SaadOjo/OJO/Sources/CAD/Drawings of purchased items/Wheels.PNG

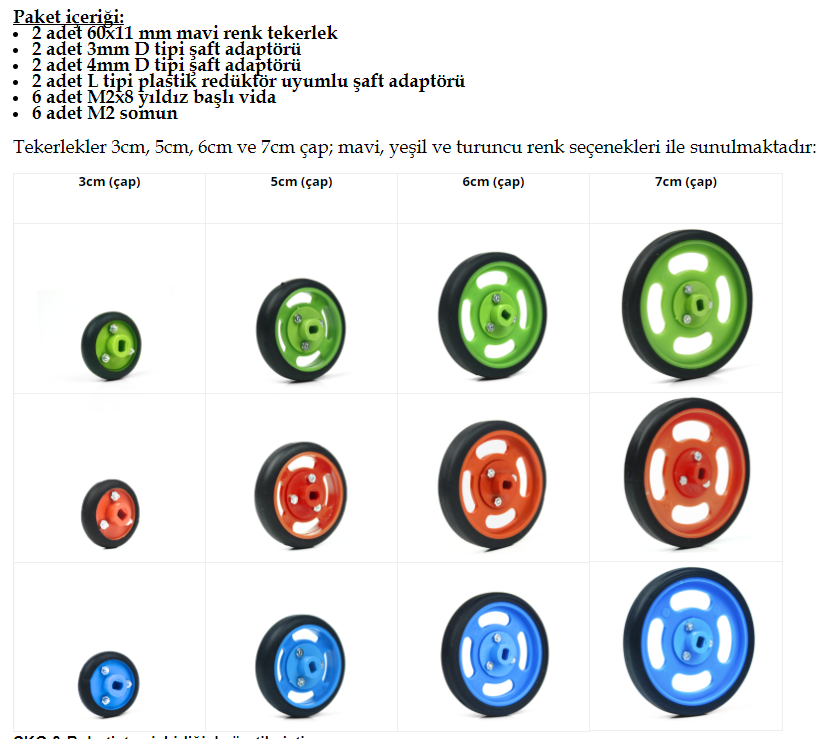
Sources/CAD/Drawings of purchased items/Wheels.PNG
