SaadOjo/OJO/OJO YouTube Cover.png

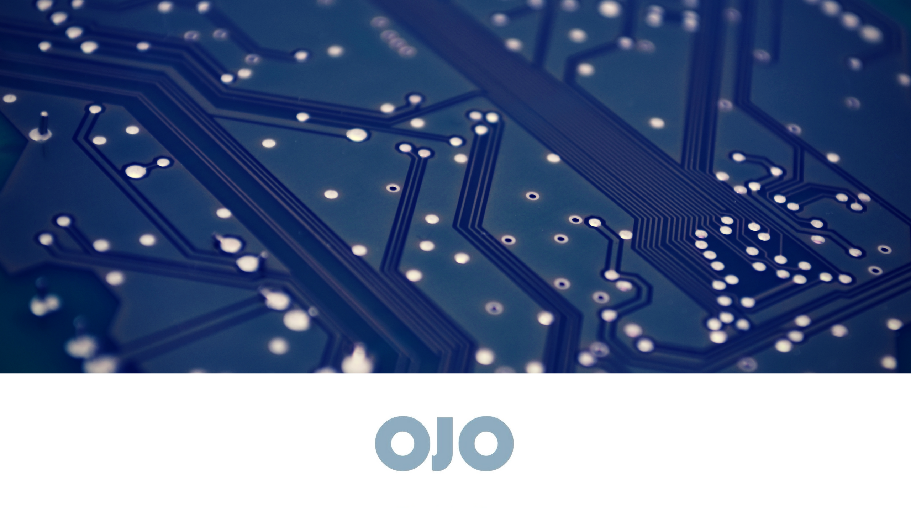
OJO YouTube Cover.png
