SaadOjo/OJO/README.md

# OJO
Colaboration platform for OJO company
