SaadOjo/OJO/Videos/Links.txt

1) Robot moving back* 
https://www.youtube.com/watch?v=8MlsbzrMXWE

2) Following the front robot, leaving the line command, finding the last one and detecting the laser
https://www.youtube.com/watch?v=pU-CdzhZj8A

3) Demo
https://youtu.be/8eGR3QvXF0o

*Relative to the convoy.
