SaadOjo/OJO/Sources/Microcontroller CodesSensorCombination/amount_of_pins_required.txt

US: 2 * 3 = 6 digital
IR DIR: 2 analog
IR DIS: 1 analog
IR Remote: 1 digital
Laser: 2 analog ??
Solar panel: 2 digital
POWER LED: 1
