SaadOjo/OJO/Sources/CAD/Links for wheels.txt

http://www.robotus.net/SLT20-Silikon-Tekerlek-2-Adet-,PR-576.html

http://www.robitshop.com/scooterkaykay-tekerlekler-icin-6mm-saft-adaptoru

https://www.robotistan.com/12v-25mm-100rpm-dc-motor

https://www.robotistan.com/aluminyum-l-tipi-25d-motor-tutucu-ikili

https://www.robotistan.com/solarbotics-rw2-tekerlek

http://www.robotus.net/SLT20-Silikon-Tekerlek-2-Adet-,PR-576.html
