SaadOjo/OJO/Sources/Microcontroller CodesSensorCombination/pinmapping.txt

Analog Pins:

A1: IR distance sensor
A2: IR direction 1 (LEFT)
A3: IR direction 2 (RIGHT)

Digital Pins:

2: IR Remote
5:Motor 1 (LEFT)
6:Motor 2 (RIGHT)
