SaadOjo/OJO/Documents/Weekly Reports/First semester/Week 8.docx

Weekly Report (WEEK 8)

Company Name: OJO e-mail: ojoee@googlegroups.com

Members:

Abdullah Aslam: phone: +90 (538) 050 37 64 e-mail: ama.abdullah90@gmail.com

Anar Abdullayev: phone: +90 (553) 924 96 43 e-mail: abdullayev.1995@gmail.com

Bulut Ulukapı: phone: +90 (555) 367 26 16 e-mail: ulukapi.bulut@metu.edu.tr

Syed Saad Saif: phone: +90 (546) 781 99 50 e-mail: saad.saif@metu.edu.tr

Umut Can Serçe: phone: +90 (506) 997 99 88 e-mail: serce.umut@metu.edu.tr

In this week, we decided to write our codes in a modular way. We divided some tasks related with coding, and then we assigned these to our group members. We made researches individually and started coding. In Table 1, it can be seen what these parts are and whom they are assigned to.

Motor driver: Abdullah Aslam

Ultrasonic sensor: Anar Abdullayev

LED antenna sensor: Bulut Ulukapı

Feedback control: Syed Saad Saif

Flags: Umut Can Serçe

Table 1. The list of modules and their assignments

In addition to the equipment and components that are purchased in last weeks, we purchased a chassis for tests and trial.

There was also a standards committee meeting. Before the meeting, we communicated with the other group and made an informal meeting. After these informal and formal meetings, some decisions are made. The agreements which are made on these meetings can be seen on the Table 2.

- If a leave command is given while turning, the optimal direction for leaving must be decided.
- Minimum radius of the curvature for turning is 100 cm.
- Maximum speed of the mock up robot is 12 cm/s. (previously it was 20cm/s)
- Distance between the center of the rectangle (visibility marker) on the robot and ground needs to in between 12 cm and 16 cm.
- Infrared LED’s needs to be horizontal.

Table 2. The decisions made in the standard committee meeting 3
