SaadOjo/OJO/Documents/Objective Tree.docx

Environment compatible Control

Light-weighted

Easily manoeuvrable

Performance

Rejoin in 10 sec
(For a good response time )

Minimum number of components to robust

Leaving and rejoining the convoy

Power Efficient

Marketable

Cost Effective

User Friendly
