SaadOjo/OJO/Documents/CDRR/CDRR Ideas and Plans.odt

-Overall System Description (with top-down approach)

-System and subsystem level

-Block diagrams

-Flow charts

-3D drawings

-All control and sata signals with their feedback paths

-Technical Specifications

-Design Modifications (changes since the CDR)

-Design changes

-4 wheel, 4 motor drive system

-Solar panel inside the box

-Chassis changed

-Updated Standards

-IR visibility marker/flags

-width of the green rectangle

-7 segment inside the box

-Compability Analysis of Sub-blocks

-Inter lib communication

-RPI --- Arduino standarts ---- UART

(Signal interfaces must be described clearly)

-Compliance with Requirements

-Design Requirements

-follow robot infront

-normal distance: 20 cm

-normal speed: 12 cm/s

-leave the line on externally received command

-within 15 sec

-maintain lateral distance of 10 cm from convoy

-rejoin the convoy as the last robot

-Physical Dimensions

-fit inside 30 cm diameter cylinder placed vertically

-Design Decisions According to the Requirements(give details)

-all the sensors and diff drive

-distance sensor IR

-IP to get distance and direction

-38 kHz IR receiver

-(cant read?) motors

-solar panel to detect laser

-made custom chassis

-Possible Error Sources

-HSV to minimize color change

-environmental light

-uneven surface

-4 wheels

-noise in sensors

-low pass filters

-combining data from multiple sensors

-Test Procedures and Assesment of Test Results(with encountered problems and proposed solutions)

TP:

-Image Processing

Objective: 1. Determine Distance,Direction,Orientation

2.Determine leaving command

1) Color Detection

-different colors

-check the range of green that can be detected

-different lighting conditions

1) Rectangle Detection

-edge detected

-tried different shapes

2) Corner Detection (coordinates)

3a) Accuracy of Dist,Dir,Orient

3b)Field of view

-Distance Sensors

-IR

-Ultrasonic

-Solar Panel

-Robot Speed

-Turning

-Leaving (Response Time)

-Following

-Power Delivery

-Resource Management (may need some addition)

-Updated budget

-Power distribution and management

- Updated Gannt
