SaadOjo/OJO/Documents/Flow chart (rough).docx

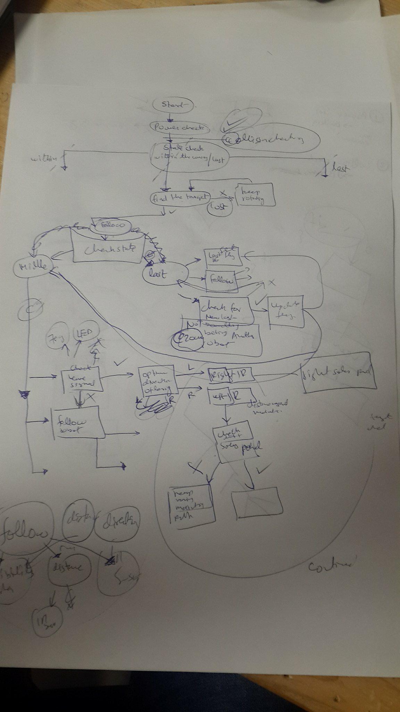
[picture p71: figure]
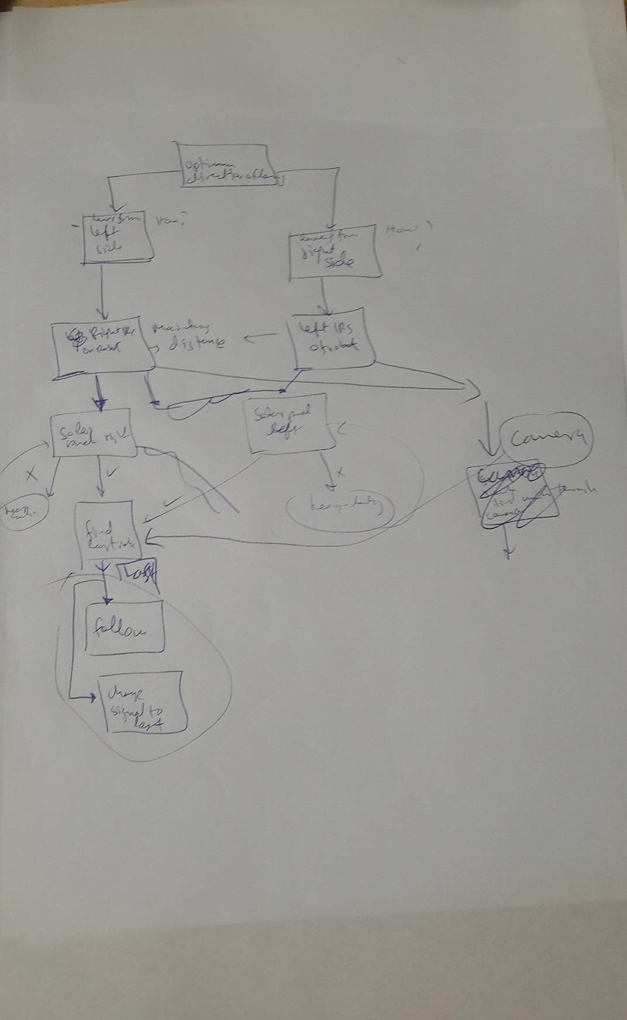
[picture p72: figure]
