SaadOjo/OJO/Datasheets/panel.jpg

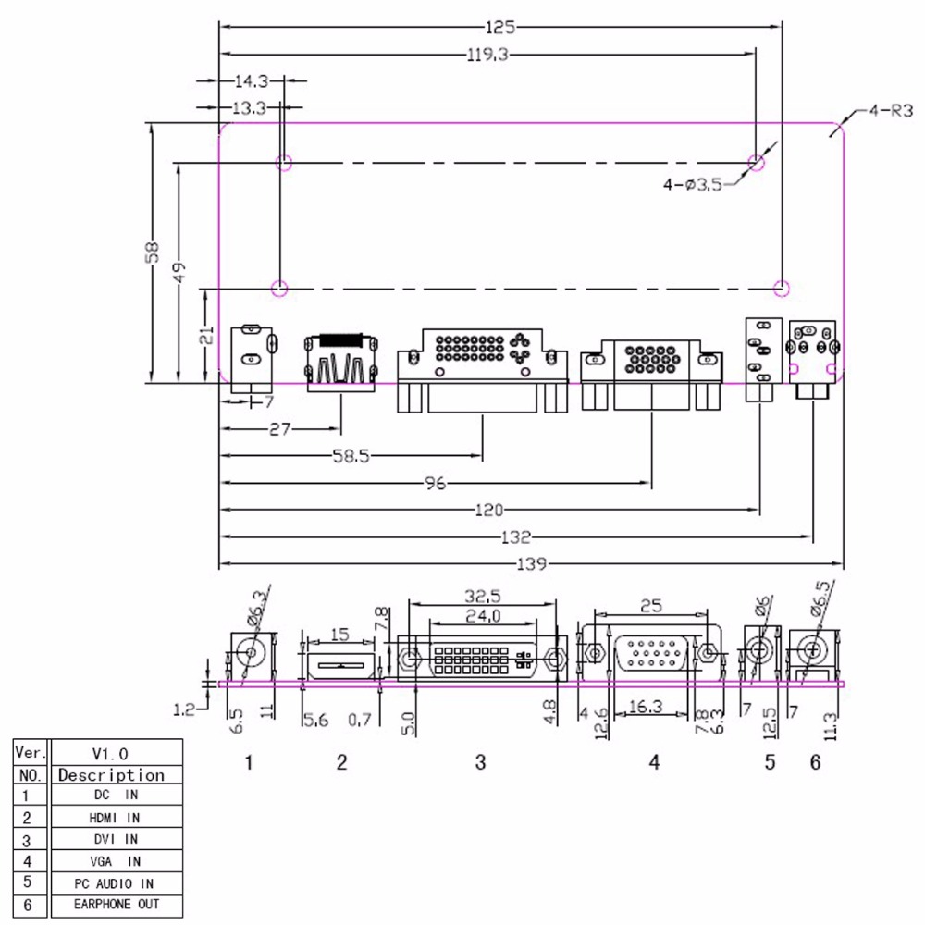
Datasheets/panel.jpg
