SaadOjo/OJO/Documents/CDRR/overall system diagram.jpg

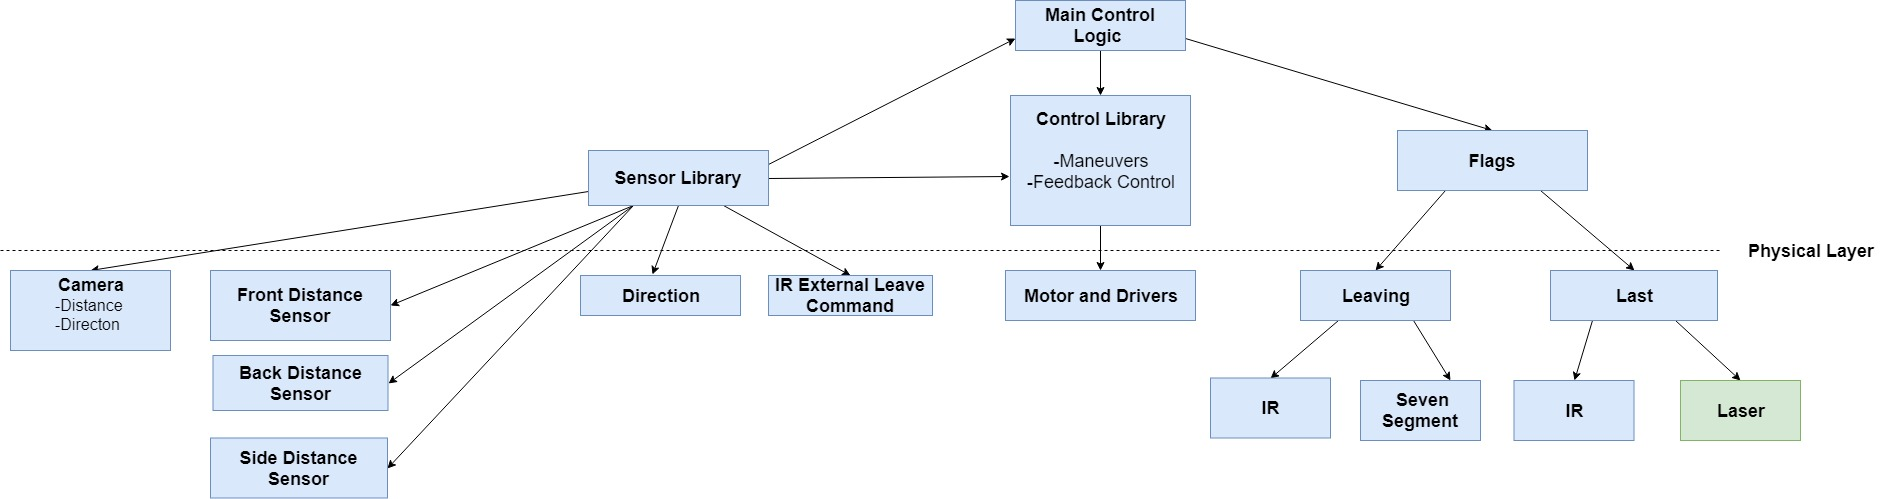
Documents/CDRR/overall system diagram.jpg
