SaadOjo/OJO/Documents/CDRR/Whole robot.png

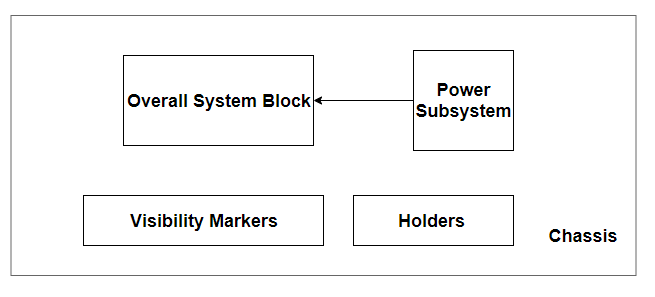
Documents/CDRR/Whole robot.png
