SaadOjo/OJO/Other/Sketchup 3D/for scale.png

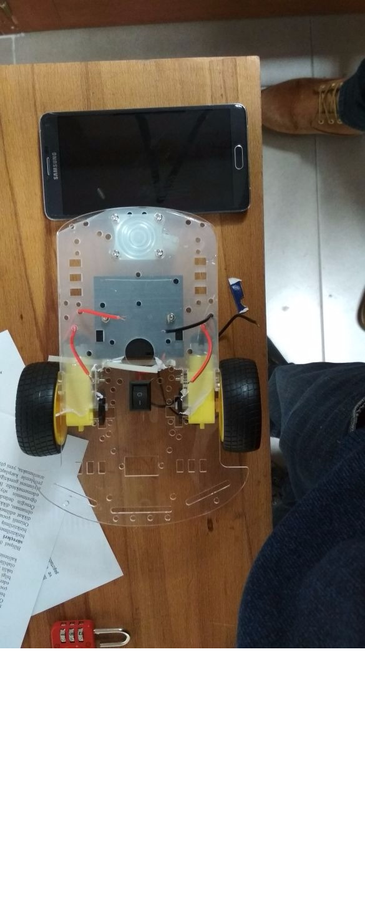
Other/Sketchup 3D/for scale.png
