SaadOjo/OJO/Other/Sketchup 3D/ruler.png

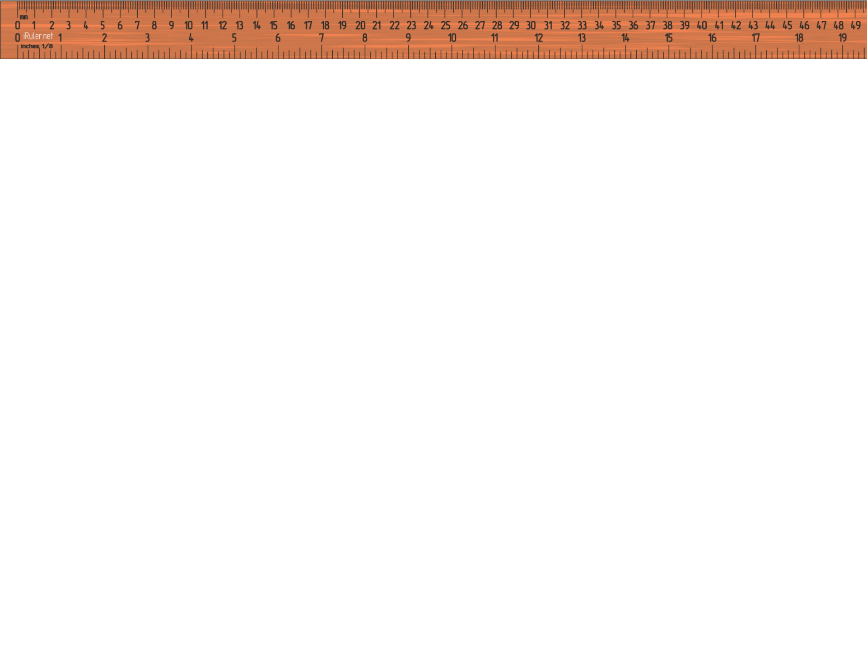
Other/Sketchup 3D/ruler.png
