SaadOjo/OJO/Sources/CAD/Solidworks Files/00 Non Project Related/Batman/ComicCon_Decals-61_1024x1024.png

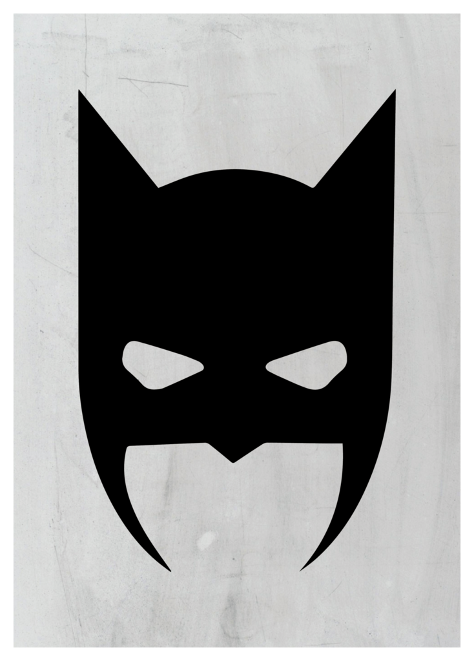
Sources/CAD/Solidworks Files/00 Non Project Related/Batman/ComicCon_Decals-61_1024x1024.png
