SaadOjo/OJO/Sources/CAD/Drawings of purchased items/25 mm motor holder.jpg

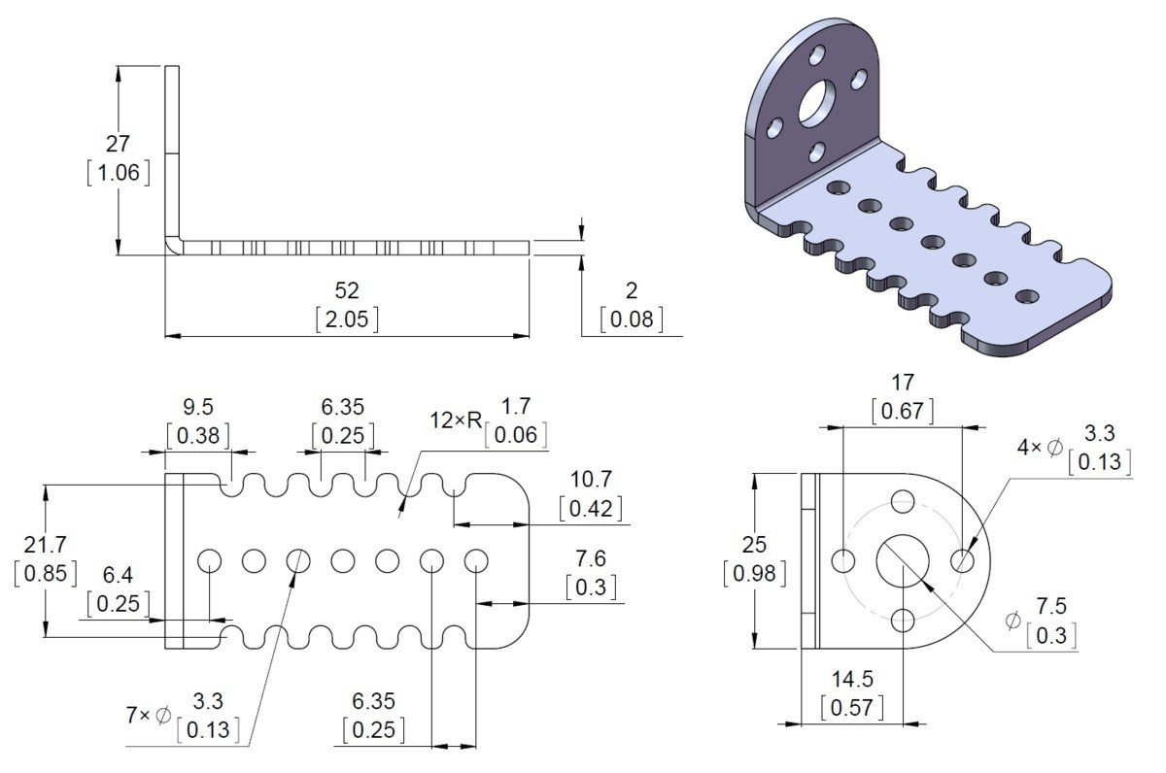
Sources/CAD/Drawings of purchased items/25 mm motor holder.jpg
