SaadOjo/OJO/Sources/CAD/Drawings of purchased items/drawings of microcontrollers and camera/arduino nano.png

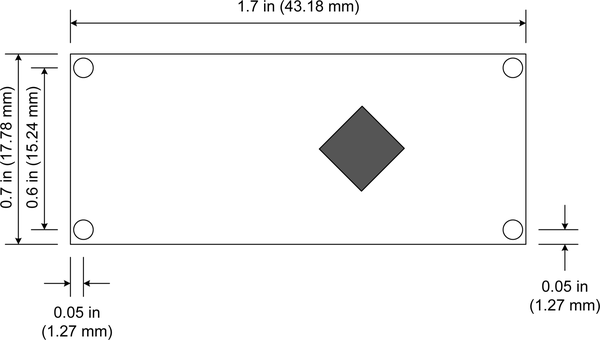
Sources/CAD/Drawings of purchased items/drawings of microcontrollers and camera/arduino nano.png
