SaadOjo/OJO/Sources/CAD/Drawings of purchased items/Hub.PNG

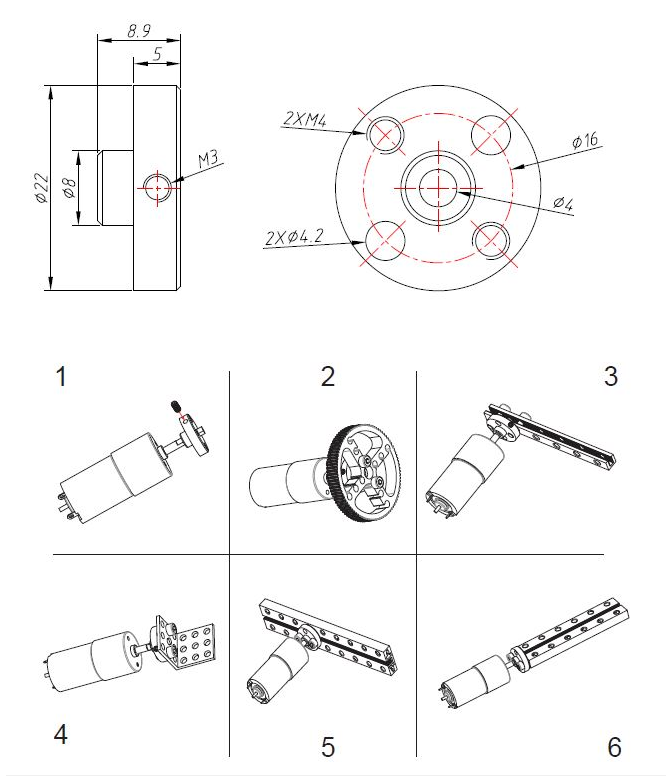
Sources/CAD/Drawings of purchased items/Hub.PNG
