SaadOjo/OJO/Sources/CAD/Solidworks Files/00 Non Project Related/coinSeperator/Assem1.SLDASM

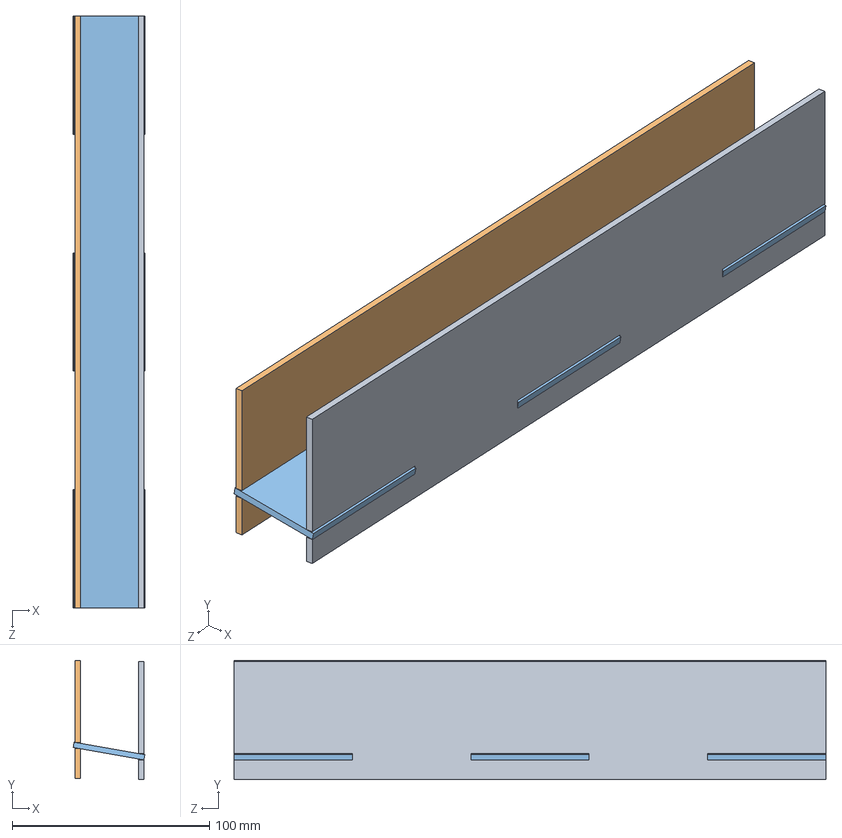
[picture p86: CAD file, 2018-03-12]
Sources/CAD/Solidworks Files/00 Non Project Related/coinSeperator/Assem1.SLDASM
36.3 x 60.5 x 300.0 mm
side_wall_1
side_wall_2
coin_plate
