SaadOjo/OJO/Sources/CAD/Solidworks Files/00 Non Project Related/Monitor/Assem.SLDASM

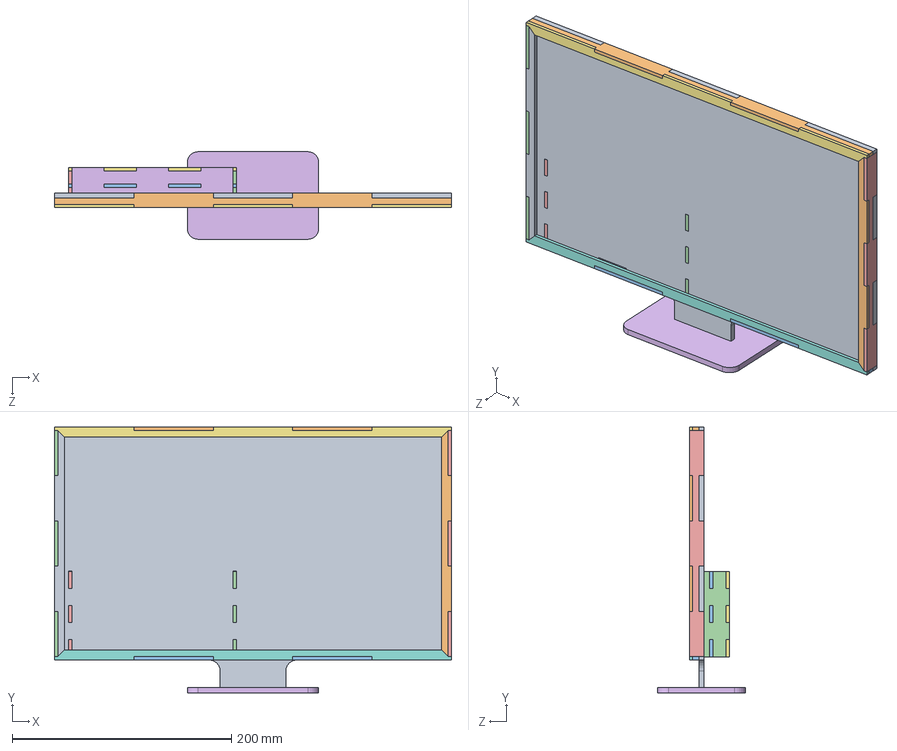
[picture p87: CAD file, 2018-03-06]
Sources/CAD/Solidworks Files/00 Non Project Related/Monitor/Assem.SLDASM
362.3 x 242.5 x 80.0 mm
A_1
B_1
C_1
D_1
F_1
BASE
G_1
H_1
I_1
J_1
BOX_A_1
BOX_B_1
BOX_C_1
BOX_D_1
BOX_E_1
