SaadOjo/OJO/Sources/CAD/Solidworks Files/00 Non Project Related/Monitor_2/Assem2.SLDASM

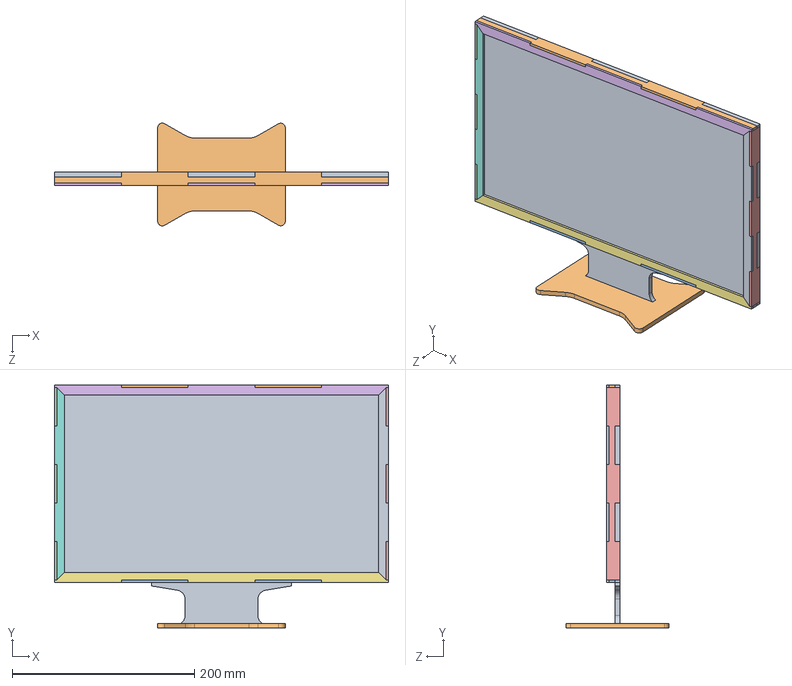
[picture p88: CAD file, 2018-05-15]
Sources/CAD/Solidworks Files/00 Non Project Related/Monitor_2/Assem2.SLDASM
366.4 x 266.4 x 112.8 mm
A_1
C_1_topdeepbezel
D_1_bottomdeepbezel
E_1_sidedeepbezel
F_1_sidedeepbezel
G_1_topbezel
H_1_topbezel
I_1_sidebezel
J_1_sidebezel
B_4_base
