SaadOjo/OJO/Sources/CAD/Solidworks Files/00 Non Project Related/Monitor_2/ButtonCase/holder_assem.SLDASM

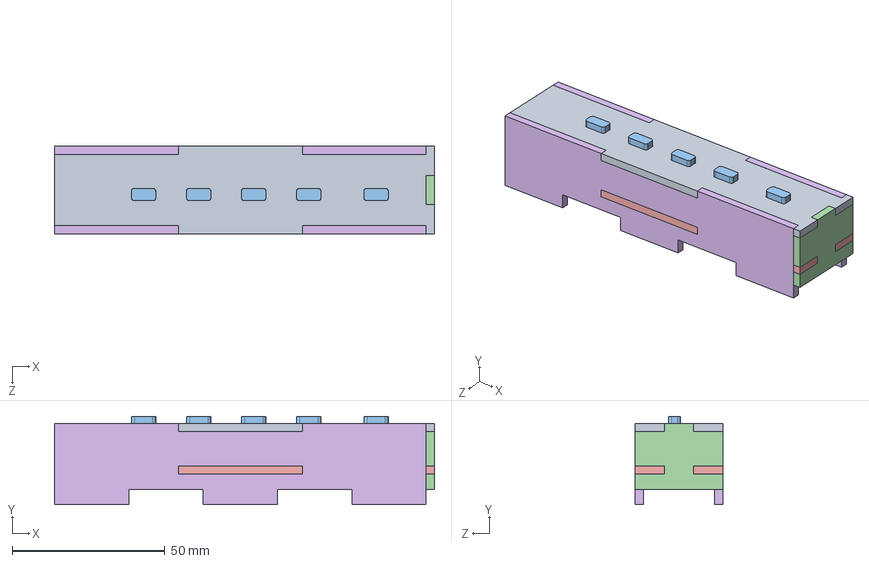
[picture p89: CAD file, 2018-05-15]
Sources/CAD/Solidworks Files/00 Non Project Related/Monitor_2/ButtonCase/holder_assem.SLDASM
124.2 x 28.9 x 28.6 mm
top_plate
bb1 x 5
bt1 x 5
side_plate
base_plate
other_side_2 x 2
