SaadOjo/OJO/Sources/CAD/Solidworks Files/00 Non Project Related/Monitor_3/Assem2_other.SLDASM

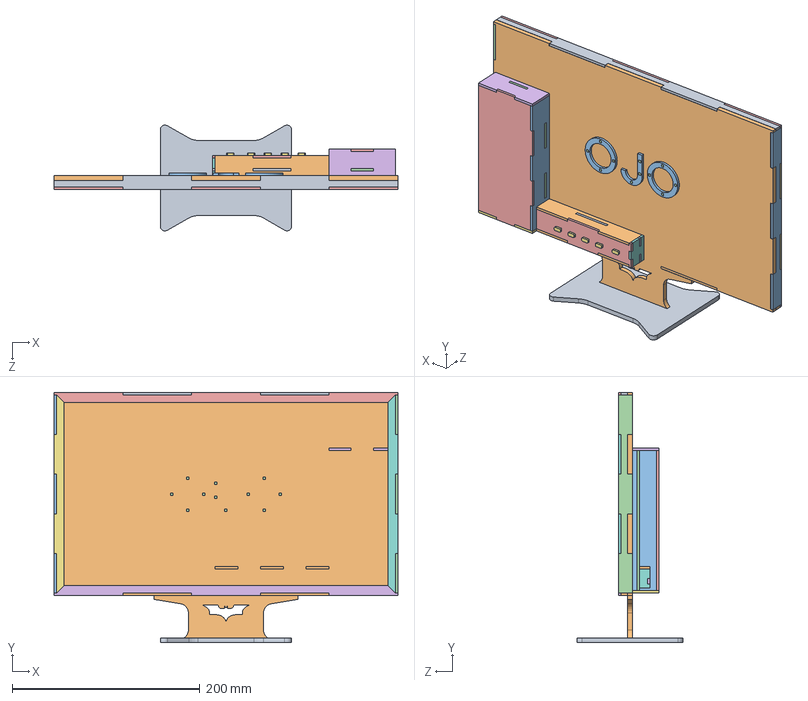
[picture p90: CAD file, 2018-05-15]
Sources/CAD/Solidworks Files/00 Non Project Related/Monitor_3/Assem2_other.SLDASM
366.5 x 266.5 x 112.8 mm
C_1_topdeepbezel
D_1_bottomdeepbezel
E_1_sidedeepbezel
F_1_sidedeepbezel
G_1_topbezel
H_1_topbezel
I_1_sidebezel
J_1_sidebezel
B_4_base
A_1_other
OJO LOGO
stick x 11
top_plate
bb1 x 5
bt1 x 5
side_plate
base_plate
other_side_2 x 2
box_back_plate
box_base_plate
box_top_plate
left_side_plate
right_side_plate
