SaadOjo/OJO/Sources/CAD/Solidworks Files/10 to be cut/5 mm/Solidworks/mainboard_last.SLDPRT

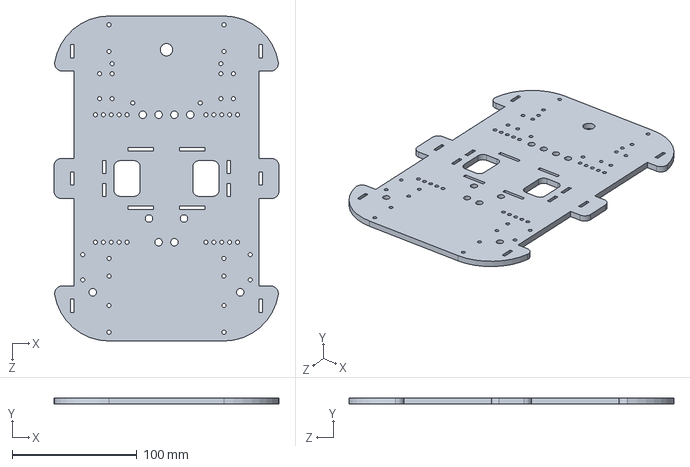
[picture p91: CAD file, 2018-05-15]
Sources/CAD/Solidworks Files/10 to be cut/5 mm/Solidworks/mainboard_last.SLDPRT
180.0 x 5.00 x 260.0 mm
