SaadOjo/OJO/Sources/CAD/Solidworks Files/Holder for solar panel/Assem for solar panel holder.SLDASM

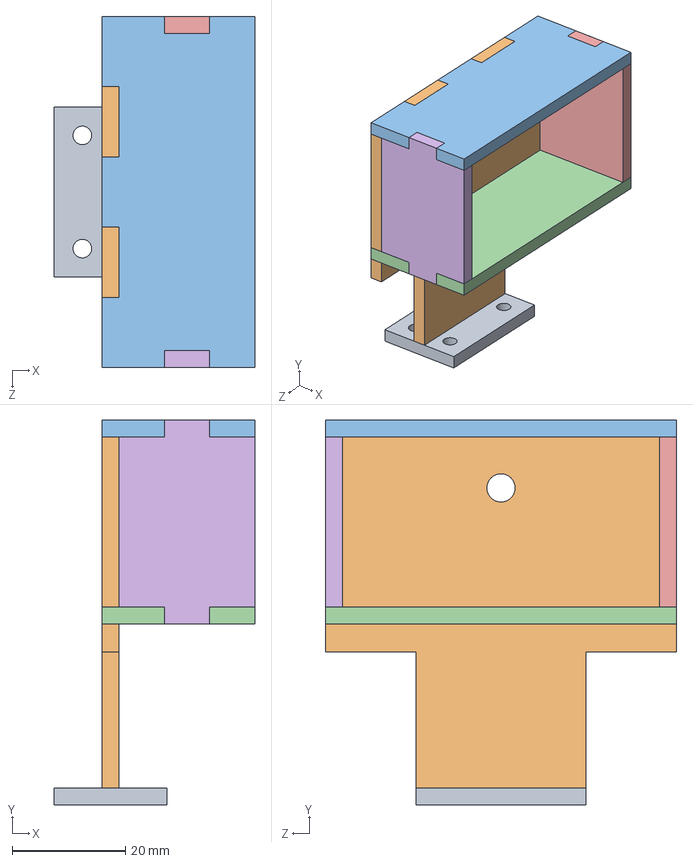
[picture p92: CAD file, 2018-03-03]
Sources/CAD/Solidworks Files/Holder for solar panel/Assem for solar panel holder.SLDASM
35.5 x 68.0 x 62.0 mm
part_A1
part_B1
Part_E1
Part_F1
Part_C1
Part_D1
