SaadOjo/OJO/Sources/CAD/Solidworks Files/Monitor_2/attachmentAssembly.SLDASM

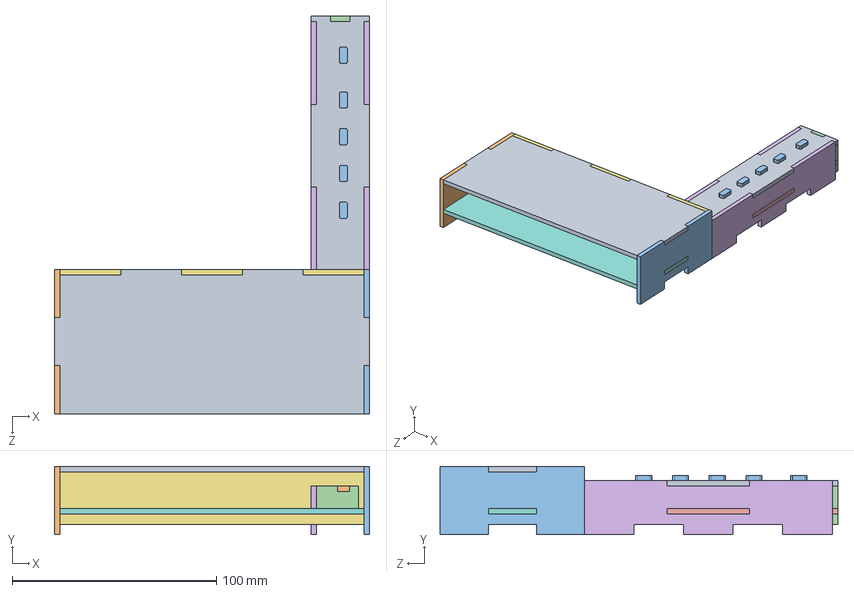
[picture p93: CAD file, 2018-05-15]
Sources/CAD/Solidworks Files/Monitor_2/attachmentAssembly.SLDASM
154.4 x 33.4 x 194.9 mm
top_plate
bb1 x 5
bt1 x 5
side_plate
base_plate
other_side_2 x 2
box_back_plate
box_base_plate
box_top_plate
left_side_plate
right_side_plate
