SaadOjo/OJO/Sources/CAD/Solidworks Files/Robot/Assem1_2_new.SLDASM

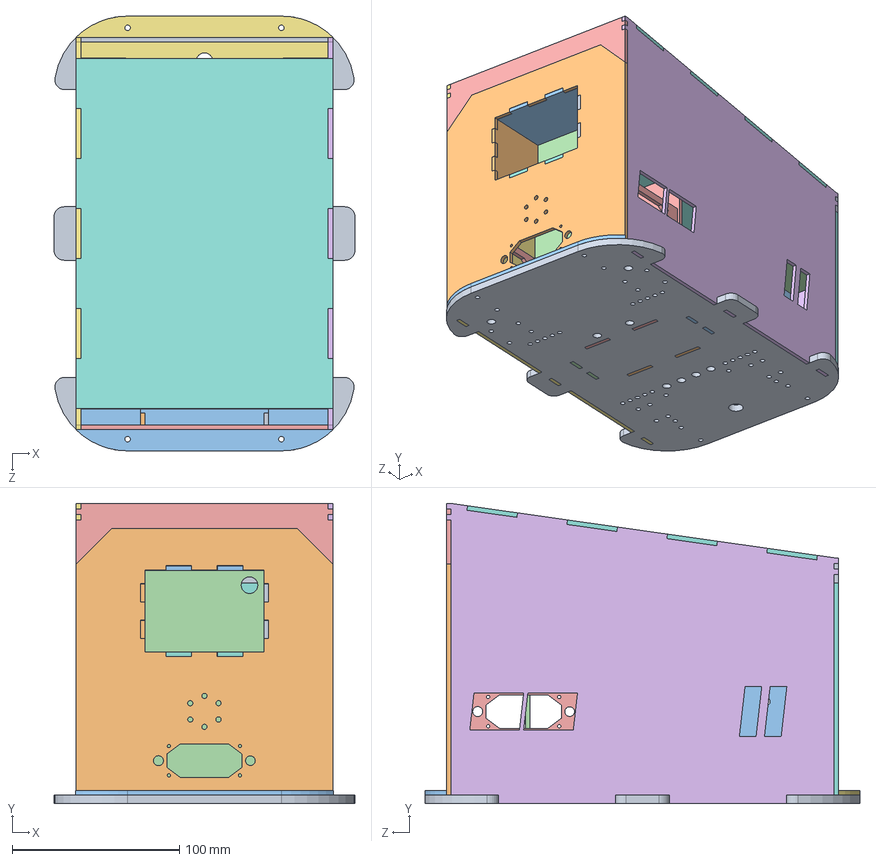
[picture p94: CAD file, 2018-05-15]
Sources/CAD/Solidworks Files/Robot/Assem1_2_new.SLDASM
180.0 x 179.5 x 260.0 mm
mainboard_last
part_A1 x 2
part_B1 x 2
Part_E1 x 2
Part_F1 x 2
Part_C1 x 2
Part_D1 x 2
partsev_bottom
partsev_side_1
partsev_side_2
partsev_top
partsev_back
back
Side_2
Side_1
top
front
new_back_holder_back_part_A
new_back_holder_base
new_back_holder_solar_panel_and_laser_part_B x 2
new_back_holder_solar_panel_and_laser_part_C x 2
Arduino_nano_holder
Base_main
Front_holder_A
Raspberry_holder
bat_long_wall_1
bat_short_wall_1
bat_short_wall_2
bat_long_wall_with_circuit_holder
