SaadOjo/OJO/Sources/CAD/Solidworks Files/seven segment box/partsev_assem.SLDASM

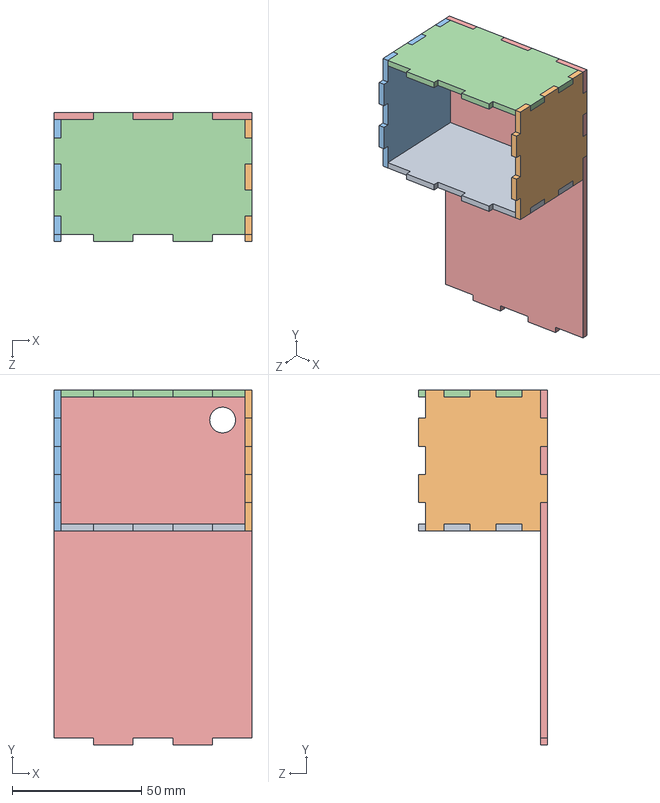
[picture p95: CAD file, 2018-05-15]
Sources/CAD/Solidworks Files/seven segment box/partsev_assem.SLDASM
76.4 x 137.2 x 50.0 mm
partsev_bottom
partsev_side_1
partsev_side_2
partsev_top
partsev_back
