SaadOjo/OJO/Sources/CAD/Solidworks Files/00 Non Project Related/Monitor_2/Assem.SLDASM

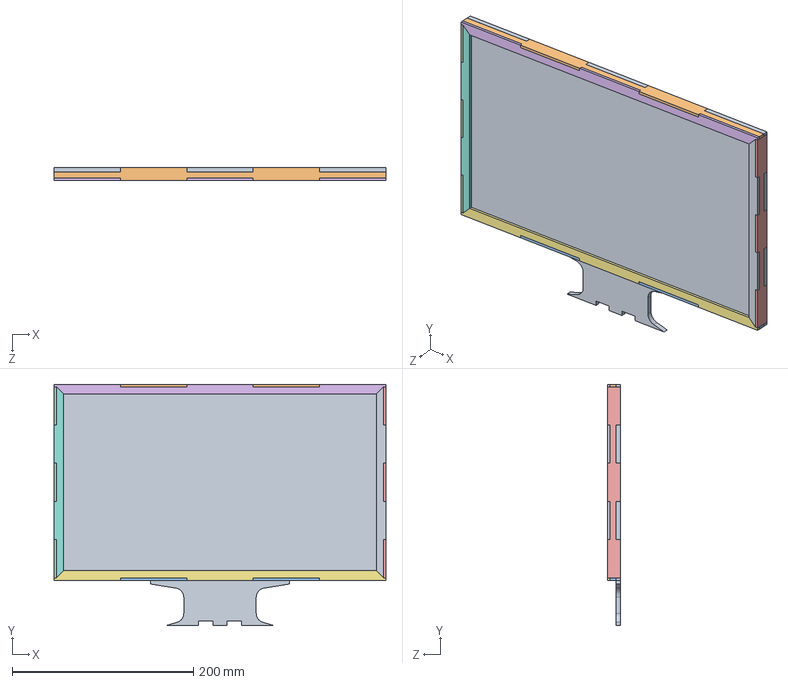
[picture p96: CAD file, 2018-03-12]
Sources/CAD/Solidworks Files/00 Non Project Related/Monitor_2/Assem.SLDASM
366.4 x 266.4 x 14.7 mm
A_1
C_1_topdeepbezel
D_1_bottomdeepbezel
E_1_sidedeepbezel
F_1_sidedeepbezel
G_1_topbezel
H_1_topbezel
I_1_sidebezel
J_1_sidebezel
