SaadOjo/OJO/Sources/CAD/Solidworks Files/00 Non Project Related/shelf/Assem1_prime.SLDASM

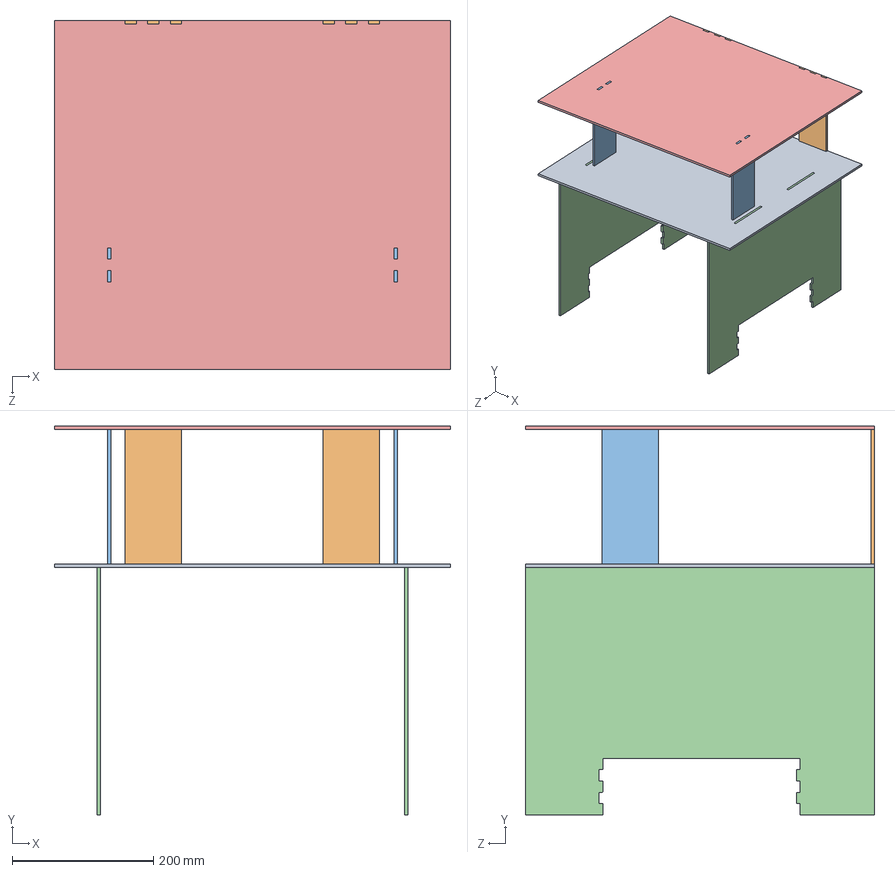
[picture p97: CAD file, 2018-03-12]
Sources/CAD/Solidworks Files/00 Non Project Related/shelf/Assem1_prime.SLDASM
560.0 x 550.0 x 494.0 mm
A_1
D_1_prime x 2
G_1_prime x 2
B_1_prime x 2
H_1
