SaadOjo/OJO/Sources/CAD/Solidworks Files/battery holder/Assem_bat_holder.SLDASM

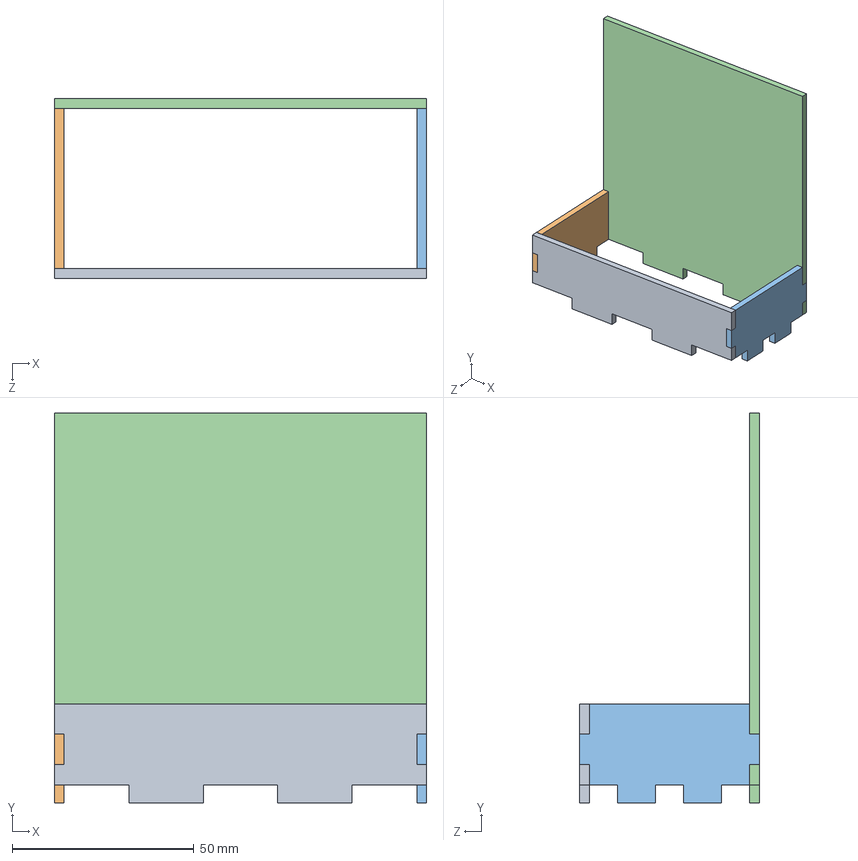
[picture p98: CAD file, 2018-05-15]
Sources/CAD/Solidworks Files/battery holder/Assem_bat_holder.SLDASM
102.4 x 107.3 x 49.4 mm
bat_long_wall_1
bat_short_wall_1
bat_short_wall_2
bat_long_wall_with_circuit_holder
