SaadOjo/OJO/Sources/CAD/Solidworks Files/Chassis/mainboard_04_new.SLDPRT

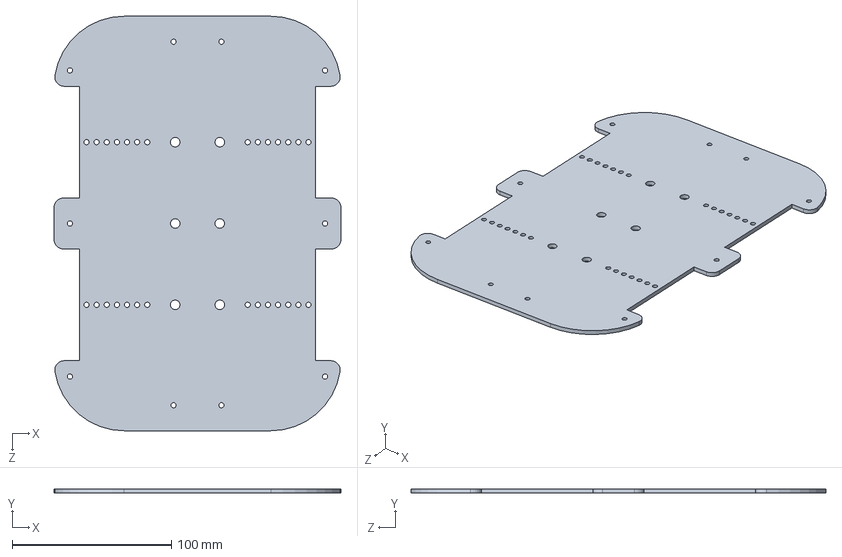
[picture p99: CAD file, 2018-02-26]
Sources/CAD/Solidworks Files/Chassis/mainboard_04_new.SLDPRT
180.0 x 2.80 x 260.0 mm
