SaadOjo/OJO/Sources/CAD/Solidworks Files/Front Holder/Assem_front.SLDASM

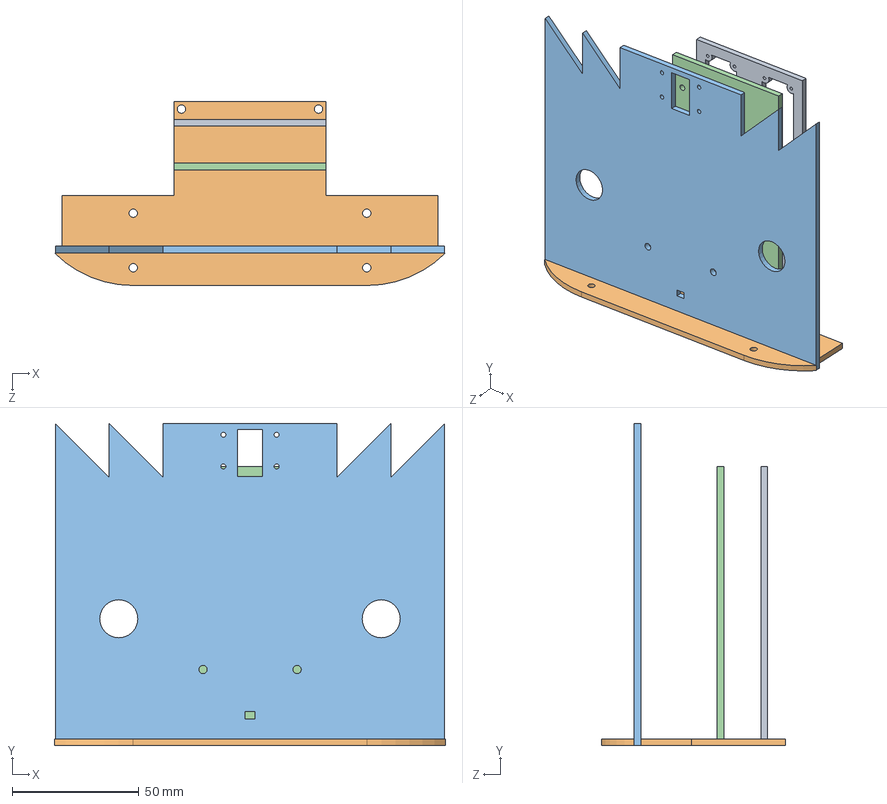
[picture p100: CAD file, 2018-05-15]
Sources/CAD/Solidworks Files/Front Holder/Assem_front.SLDASM
154.1 x 127.0 x 72.5 mm
Arduino_nano_holder
Base_main
Front_holder_A
Raspberry_holder
