SaadOjo/OJO/Sources/CAD/Solidworks Files/Monitor_2/ElectronicsBox/box_assem.SLDASM

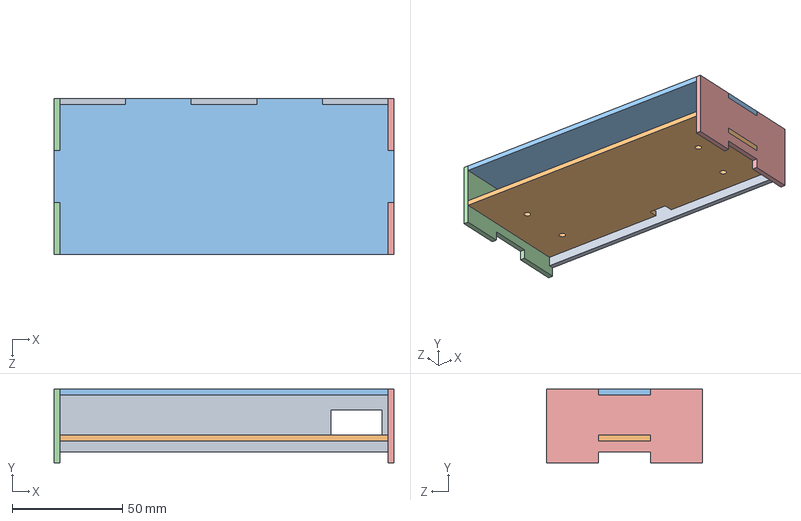
[picture p101: CAD file, 2018-05-15]
Sources/CAD/Solidworks Files/Monitor_2/ElectronicsBox/box_assem.SLDASM
154.4 x 33.4 x 70.7 mm
box_back_plate
box_base_plate
box_top_plate
left_side_plate
right_side_plate
