SaadOjo/OJO/Sources/CAD/Solidworks Files/new back holder/Assem_new_back.SLDASM

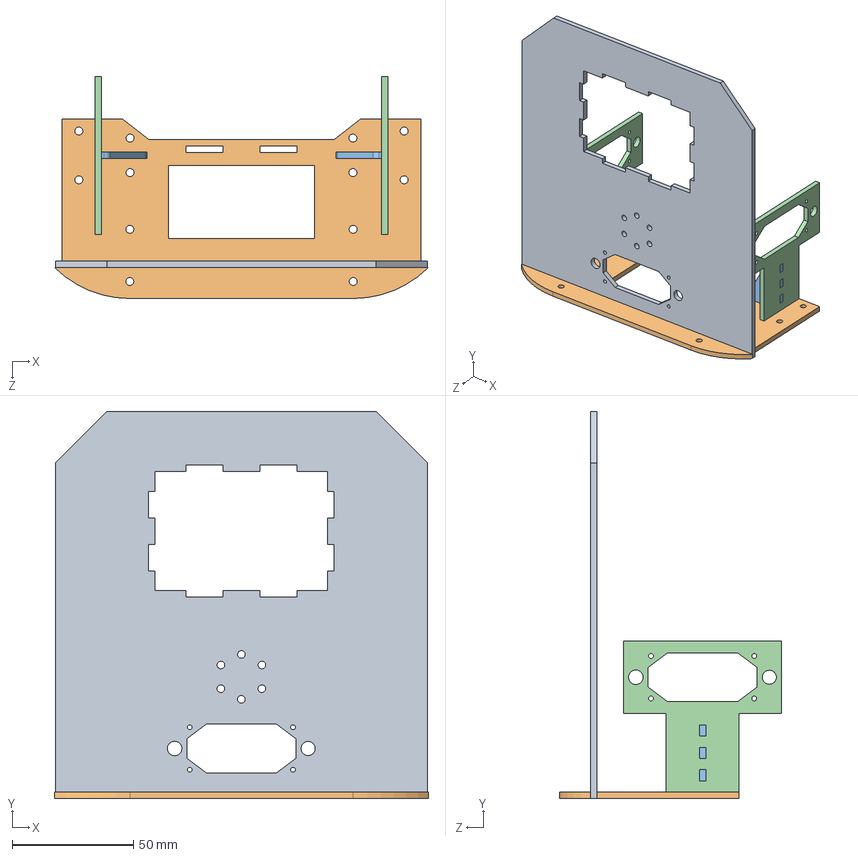
[picture p102: CAD file, 2018-05-15]
Sources/CAD/Solidworks Files/new back holder/Assem_new_back.SLDASM
154.1 x 159.5 x 91.4 mm
new_back_holder_back_part_A
new_back_holder_base
new_back_holder_solar_panel_and_laser_part_B x 2
new_back_holder_solar_panel_and_laser_part_C x 2
