SaadOjo/OJO/Sources/CAD/Solidworks Files/Robot/Assem1.SLDASM

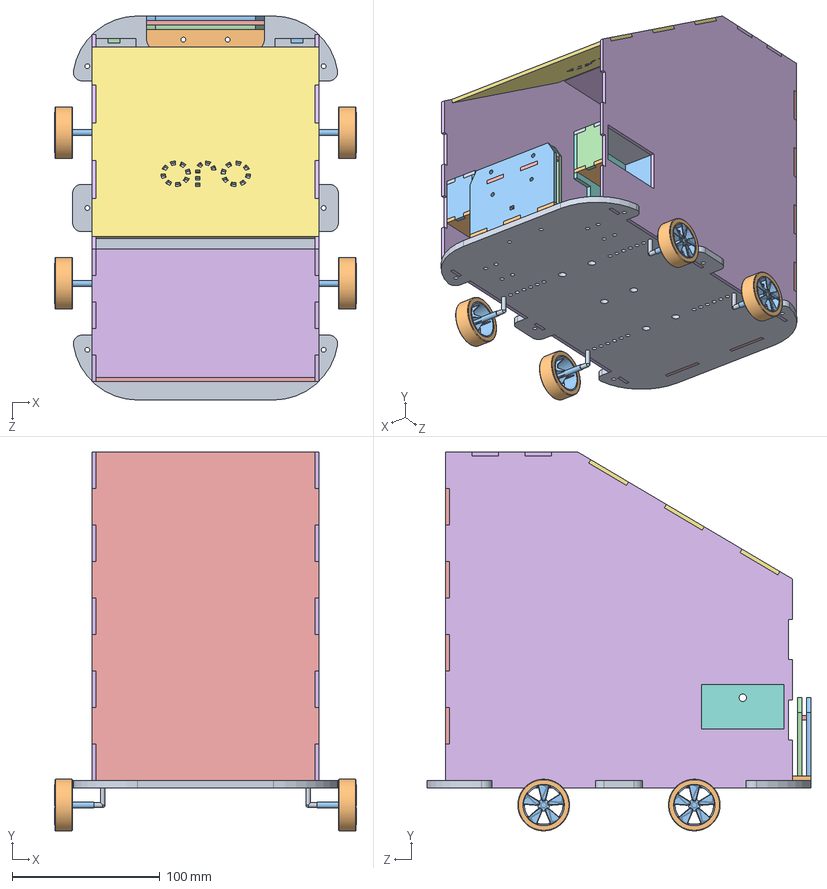
[picture p103: CAD file, 2018-03-08]
Sources/CAD/Solidworks Files/Robot/Assem1.SLDASM
204.6 x 256.4 x 260.0 mm
mainboard_last
holder_A_1
holder_B_2
holder_C_1
holder_D_1
Side_2 x 2
part_A1 x 2
part_B1 x 2
Part_E1 x 2
Part_F1 x 2
Part_C1 x 2
Part_D1 x 2
Back
Top_first
Top_second
tire x 4
disque roue x 4
