SaadOjo/OJO/Sources/CAD/Solidworks Files/Walls (Box)/walls_assem.SLDASM

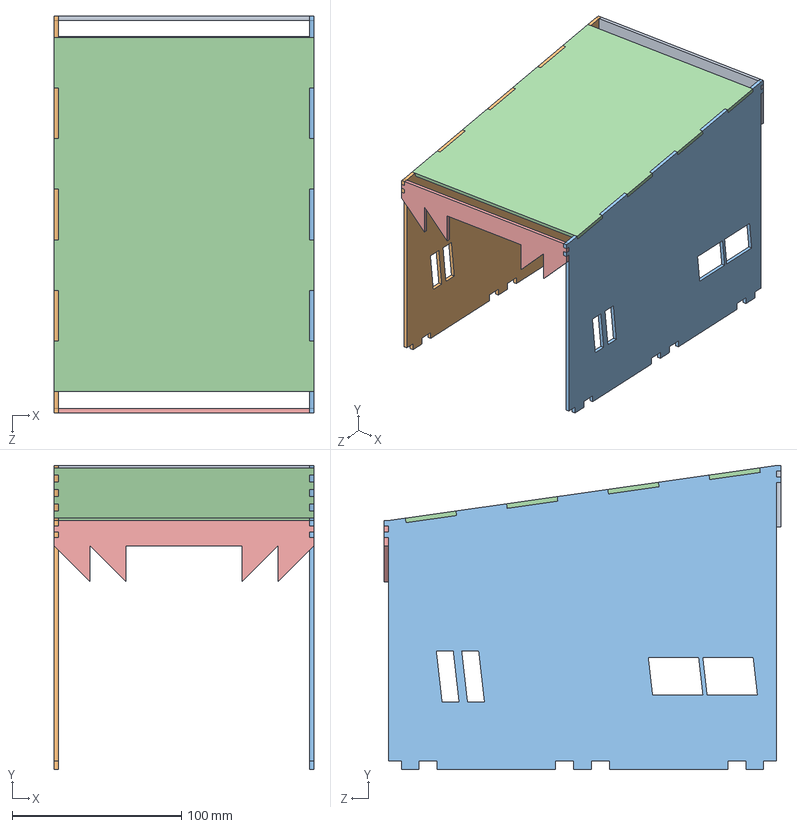
[picture p104: CAD file, 2018-05-15]
Sources/CAD/Solidworks Files/Walls (Box)/walls_assem.SLDASM
153.4 x 179.5 x 234.4 mm
back
Side_2
Side_1
top
front
