SaadOjo/OJO/Sources/CAD/Solidworks Files/00 Non Project Related/Monitor/Electronics Box/BoxAssembly.SLDASM

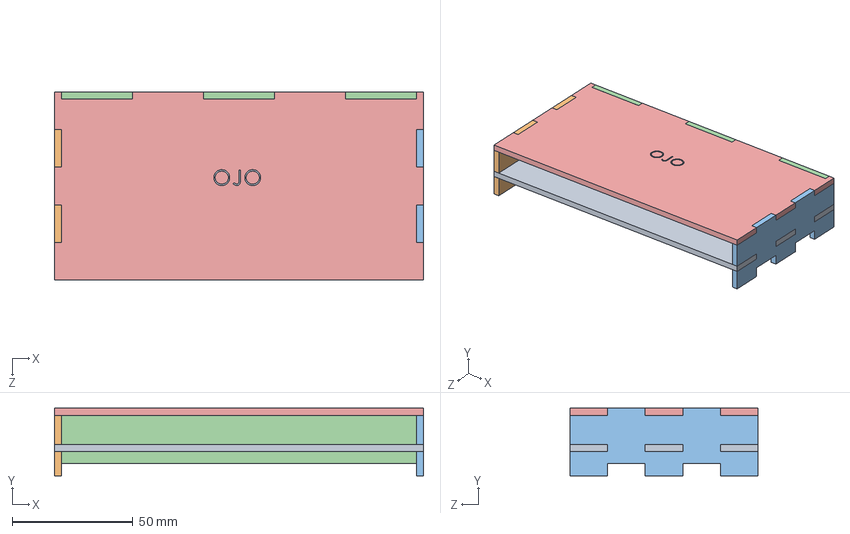
[picture p105: CAD file, 2018-03-06]
Sources/CAD/Solidworks Files/00 Non Project Related/Monitor/Electronics Box/BoxAssembly.SLDASM
153.0 x 28.0 x 78.0 mm
BOX_A_1
BOX_B_1
BOX_C_1
BOX_D_1
BOX_E_1
