SaadOjo/OJO/Sources/CAD/Solidworks Files/00 Non Project Related/Monitor_2/ElectronicsBox/assem.SLDASM

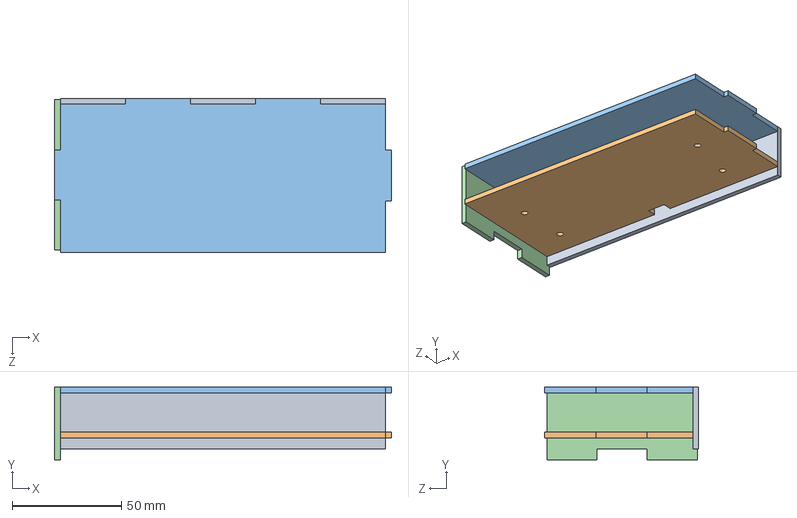
[picture p106: CAD file, 2018-03-17]
Sources/CAD/Solidworks Files/00 Non Project Related/Monitor_2/ElectronicsBox/assem.SLDASM
154.4 x 33.4 x 70.7 mm
box_back_plate
box_base_plate
box_top_plate
left_side_plate
