SaadOjo/OJO/Sources/CAD/Solidworks Files/Arduino Holder/Assem Arduino.SLDASM

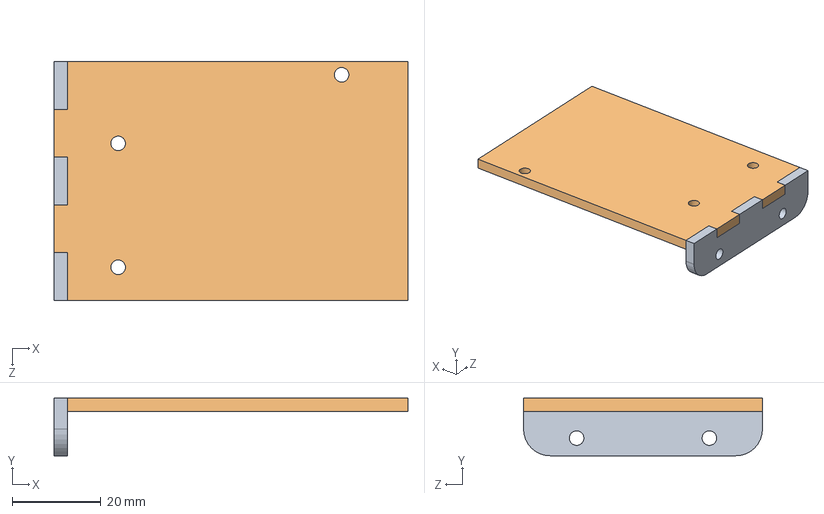
[picture p107: CAD file, 2018-03-03]
Sources/CAD/Solidworks Files/Arduino Holder/Assem Arduino.SLDASM
80.0 x 13.0 x 54.0 mm
Part_A_1
Part_B_1
