SaadOjo/OJO/Sources/CAD/Solidworks Files/Front Holder/Base_main.SLDPRT

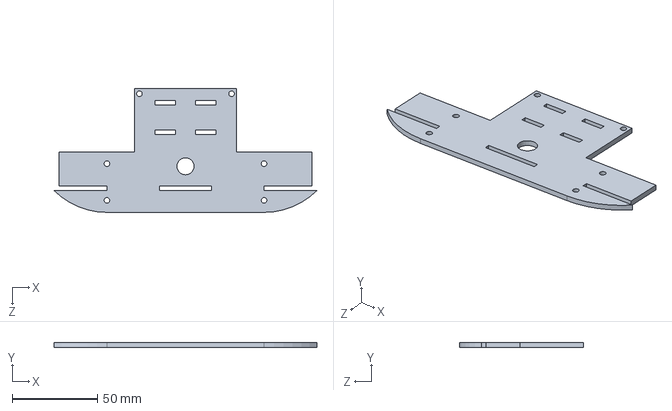
[picture p108: CAD file, 2018-05-15]
Sources/CAD/Solidworks Files/Front Holder/Base_main.SLDPRT
154.1 x 2.70 x 72.5 mm
