SaadOjo/OJO/Sources/CAD/Solidworks Files/This little thing/this little thing.SLDASM

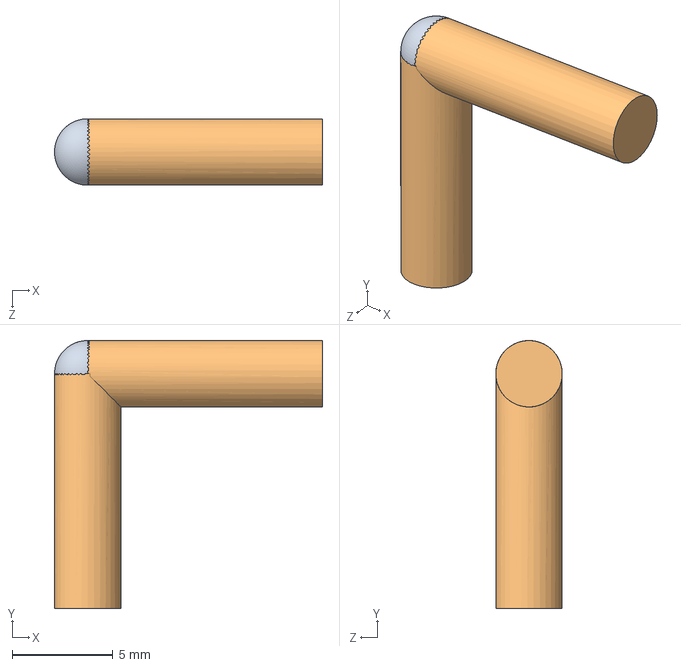
[picture p109: CAD file, 2018-03-08]
Sources/CAD/Solidworks Files/This little thing/this little thing.SLDASM
13.3 x 13.3 x 3.30 mm
