SaadOjo/OJO/Sources/CAD/Solidworks Files/00 Non Project Related/Monitor_3/ButtonCase/buttonAs1.SLDASM

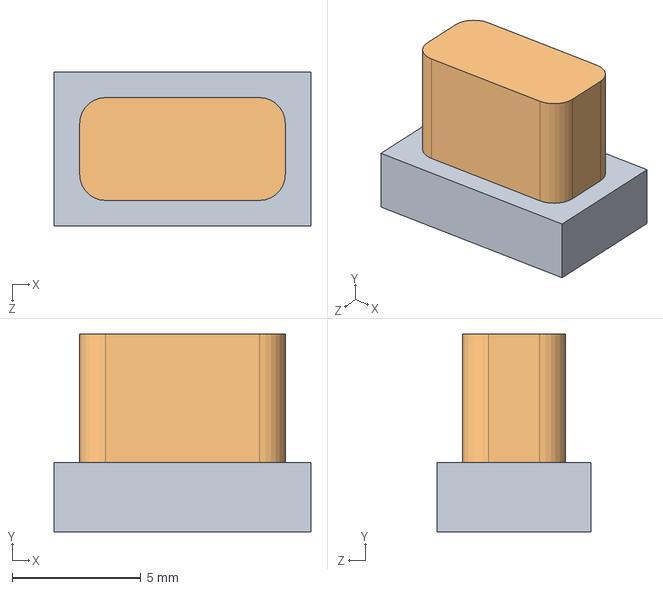
[picture p110: CAD file, 2018-03-12]
Sources/CAD/Solidworks Files/00 Non Project Related/Monitor_3/ButtonCase/buttonAs1.SLDASM
10.0 x 7.70 x 6.00 mm
button1_base
button1
