SaadOjo/OJO/Sources/CAD/Solidworks Files/00 Non Project Related/Monitor_3/ButtonCase/Assem3.SLDASM

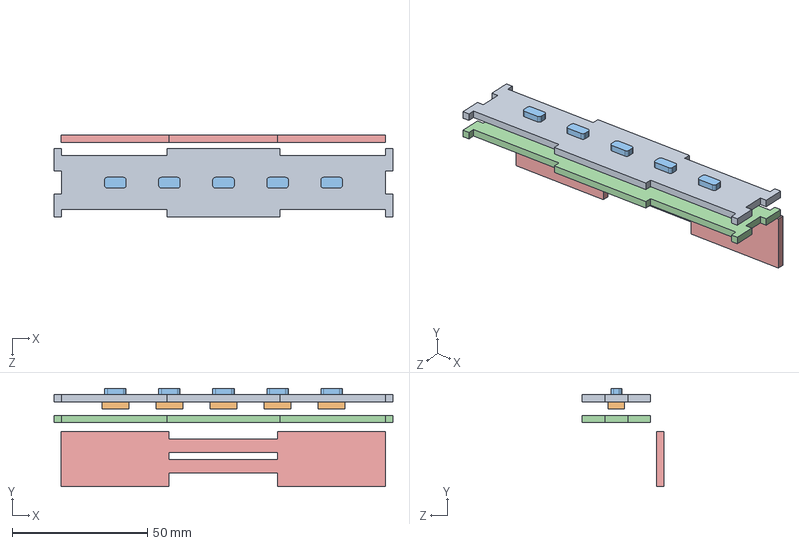
[picture p111: CAD file, 2018-03-12]
Sources/CAD/Solidworks Files/00 Non Project Related/Monitor_3/ButtonCase/Assem3.SLDASM
125.4 x 36.4 x 30.3 mm
top
button1_base x 5
button1 x 5
middle
boxlongedge
