SaadOjo/OJO/Sources/CAD/Solidworks Files/00 Non Project Related/shelf/Assem1.SLDASM

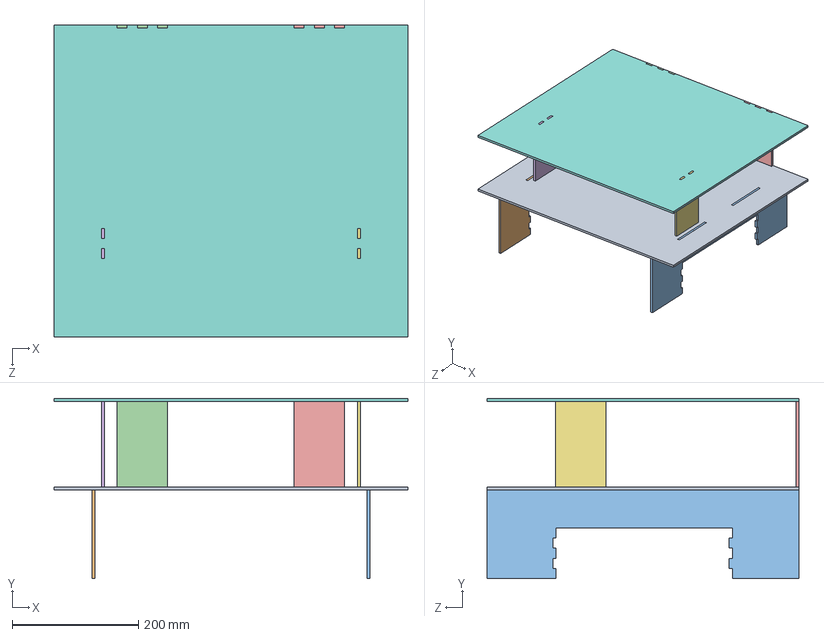
[picture p112: CAD file, 2018-03-12]
Sources/CAD/Solidworks Files/00 Non Project Related/shelf/Assem1.SLDASM
560.0 x 285.0 x 494.0 mm
A_1
B_1
C_1
D_1
E_1
F_1
G_1
H_1
