SaadOjo/OJO/Sources/CAD/Solidworks Files/00 Non Project Related/Batman/BATMAN 10 cm.SLDPRT

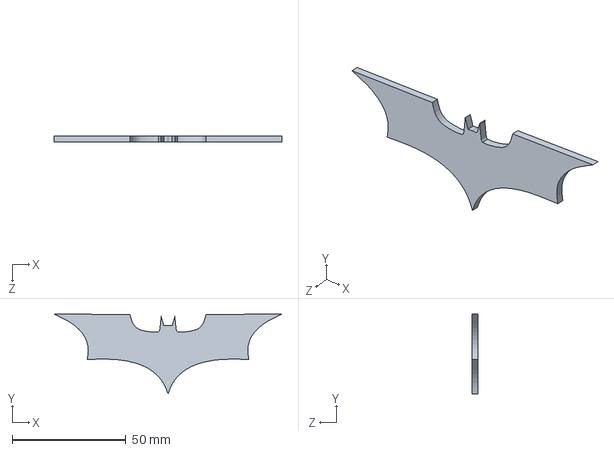
[picture p113: CAD file, 2018-03-16]
Sources/CAD/Solidworks Files/00 Non Project Related/Batman/BATMAN 10 cm.SLDPRT
100.0 x 35.0 x 2.70 mm
