SaadOjo/OJO/Sources/CAD/Solidworks Files/00 Non Project Related/Monitor/dxf/3mm/box/BOX_E_1.DXF

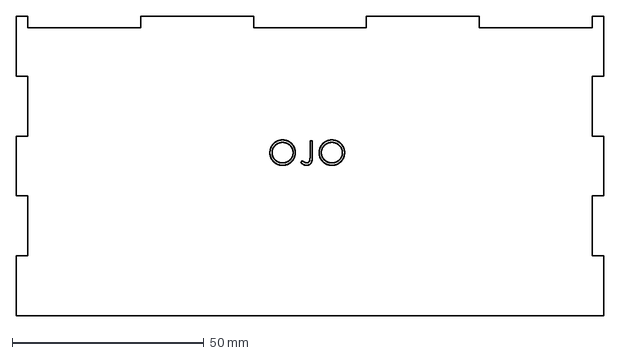
[picture p114: CAD file, 2018-03-06]
Sources/CAD/Solidworks Files/00 Non Project Related/Monitor/dxf/3mm/box/BOX_E_1.DXF
153.0 x 78.0 mm
