SaadOjo/OJO/Sources/CAD/Solidworks Files/00 Non Project Related/Monitor/dxf/3mm/J_1.DXF

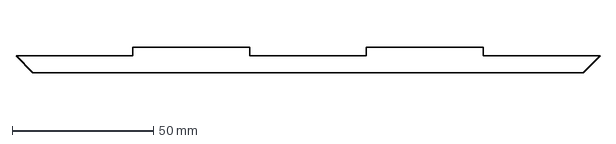
[picture p115: CAD file, 2018-03-06]
Sources/CAD/Solidworks Files/00 Non Project Related/Monitor/dxf/3mm/J_1.DXF
206.5 x 9.00 mm
