SaadOjo/OJO/Sources/CAD/Solidworks Files/00 Non Project Related/Monitor/dxf/5mm/BASE.DXF

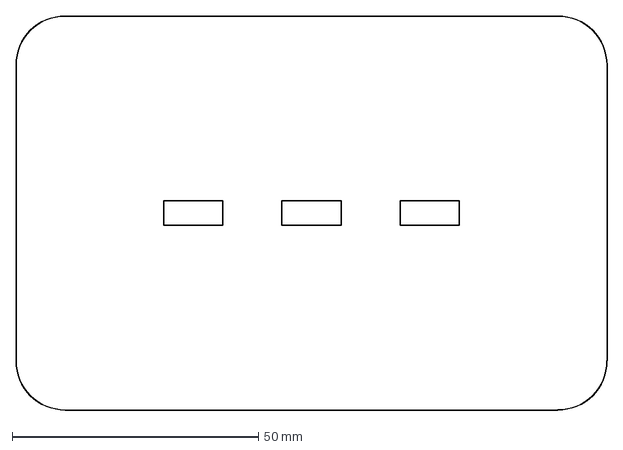
[picture p116: CAD file, 2018-03-06]
Sources/CAD/Solidworks Files/00 Non Project Related/Monitor/dxf/5mm/BASE.DXF
120.0 x 80.0 mm
