SaadOjo/OJO/Sources/CAD/Solidworks Files/00 Non Project Related/Monitor/Electronics Box/BOX_D_1.SLDPRT

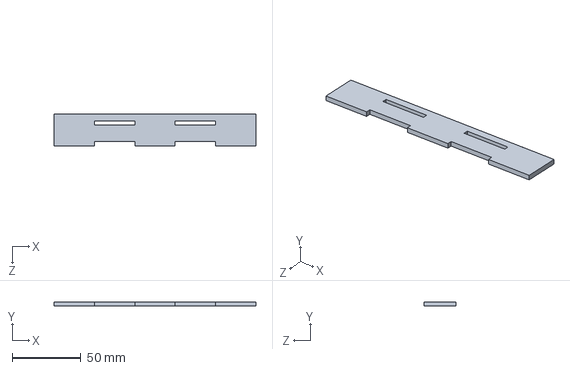
[picture p117: CAD file, 2018-03-06]
Sources/CAD/Solidworks Files/00 Non Project Related/Monitor/Electronics Box/BOX_D_1.SLDPRT
147.0 x 3.00 x 23.0 mm
