SaadOjo/OJO/Sources/CAD/Solidworks Files/00 Non Project Related/Monitor_2/3mm/E_1_sidedeepbezel.SLDPRT

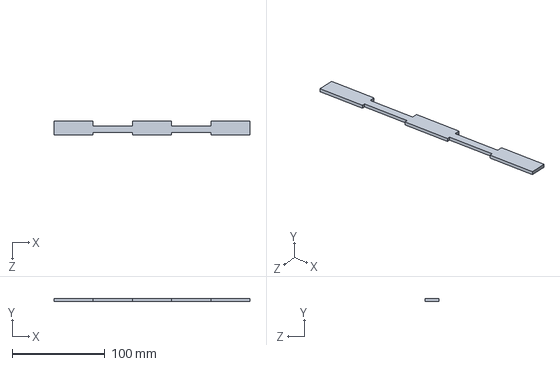
[picture p118: CAD file, 2018-03-10]
Sources/CAD/Solidworks Files/00 Non Project Related/Monitor_2/3mm/E_1_sidedeepbezel.SLDPRT
211.0 x 2.70 x 14.7 mm
