SaadOjo/OJO/Sources/CAD/Solidworks Files/00 Non Project Related/Monitor_2/5mm/5mm_dxf/A_1.DXF

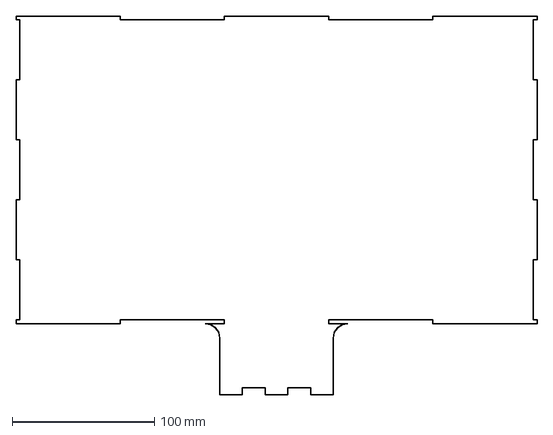
[picture p119: CAD file, 2018-03-10]
Sources/CAD/Solidworks Files/00 Non Project Related/Monitor_2/5mm/5mm_dxf/A_1.DXF
366.4 x 266.4 mm
