SaadOjo/OJO/Sources/CAD/Solidworks Files/00 Non Project Related/Monitor_2/5mm/A_1.SLDPRT

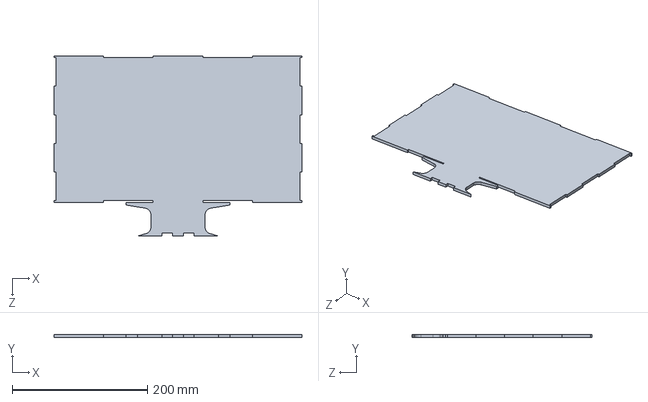
[picture p120: CAD file, 2018-03-12]
Sources/CAD/Solidworks Files/00 Non Project Related/Monitor_2/5mm/A_1.SLDPRT
366.4 x 5.00 x 266.4 mm
