SaadOjo/OJO/Sources/CAD/Solidworks Files/00 Non Project Related/Monitor_2/ElectronicsBox/left_side_plate.SLDPRT

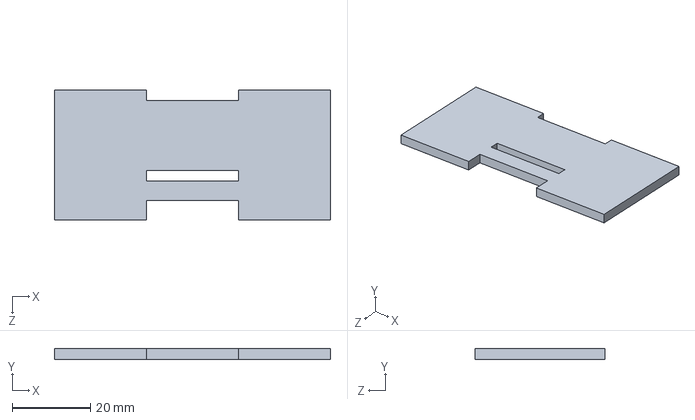
[picture p121: CAD file, 2018-05-15]
Sources/CAD/Solidworks Files/00 Non Project Related/Monitor_2/ElectronicsBox/left_side_plate.SLDPRT
70.7 x 2.70 x 33.4 mm
