SaadOjo/OJO/Sources/CAD/Solidworks Files/00 Non Project Related/Monitor_3/2.7 mm/stick.SLDPRT

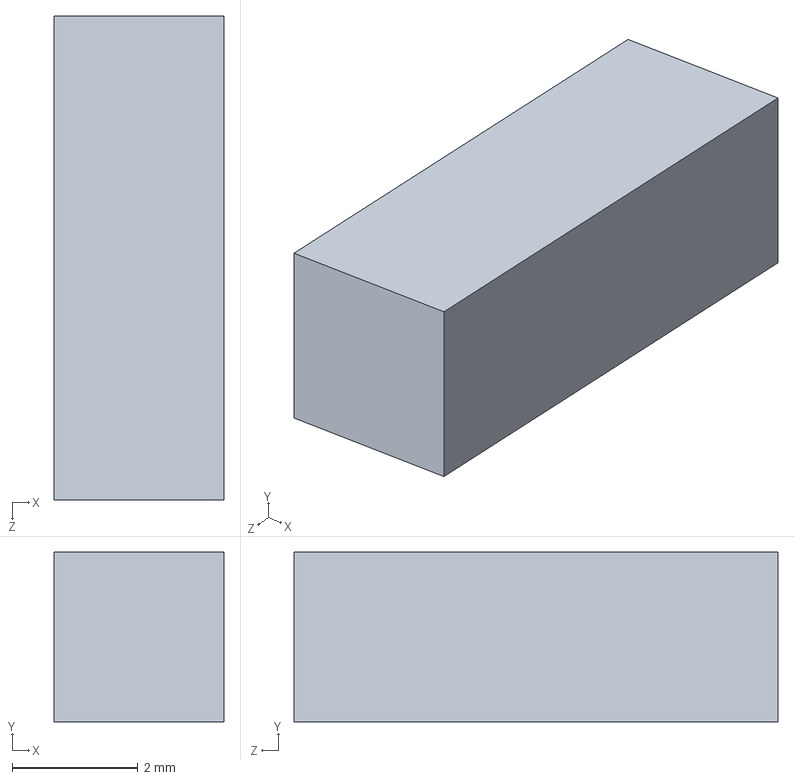
[picture p122: CAD file, 2018-03-16]
Sources/CAD/Solidworks Files/00 Non Project Related/Monitor_3/2.7 mm/stick.SLDPRT
2.70 x 2.70 x 7.70 mm
