SaadOjo/OJO/Sources/CAD/Solidworks Files/00 Non Project Related/Monitor_3/ButtonCase/button1.SLDPRT

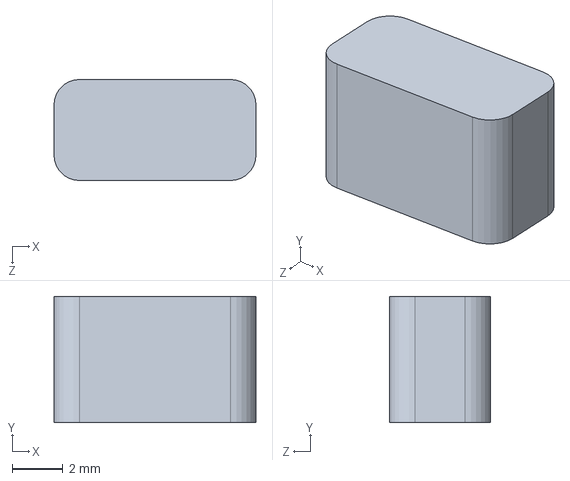
[picture p123: CAD file, 2018-03-12]
Sources/CAD/Solidworks Files/00 Non Project Related/Monitor_3/ButtonCase/button1.SLDPRT
8.00 x 5.00 x 4.00 mm
