SaadOjo/OJO/Sources/CAD/Solidworks Files/00 Non Project Related/shelf/D_1_prime.SLDPRT

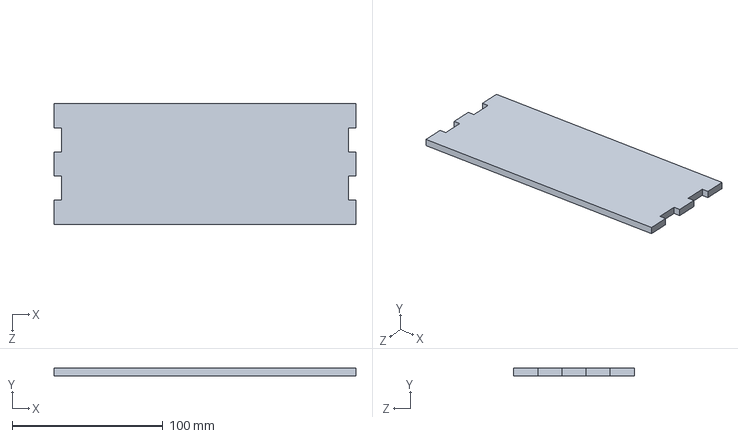
[picture p124: CAD file, 2018-03-12]
Sources/CAD/Solidworks Files/00 Non Project Related/shelf/D_1_prime.SLDPRT
200.0 x 5.00 x 80.0 mm
