SaadOjo/OJO/Sources/CAD/Solidworks Files/10 to be cut/2.7 mm/Solidworks/new_back_holder_solar_panel_and_laser_part_C.SLDPRT

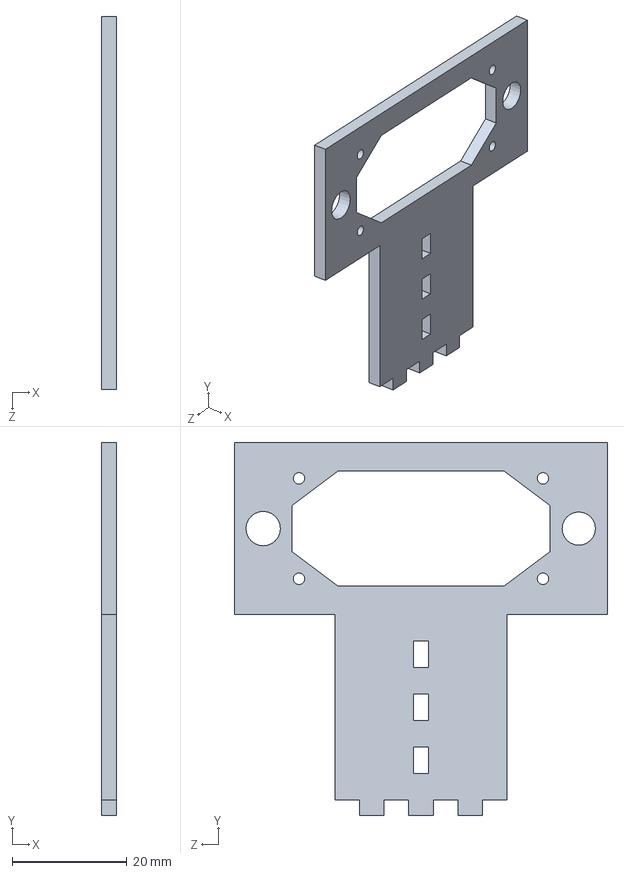
[picture p125: CAD file, 2018-05-15]
Sources/CAD/Solidworks Files/10 to be cut/2.7 mm/Solidworks/new_back_holder_solar_panel_and_laser_part_C.SLDPRT
2.70 x 65.0 x 65.0 mm
