SaadOjo/OJO/Sources/CAD/Solidworks Files/Arduino Holder/Part_A_1.SLDPRT

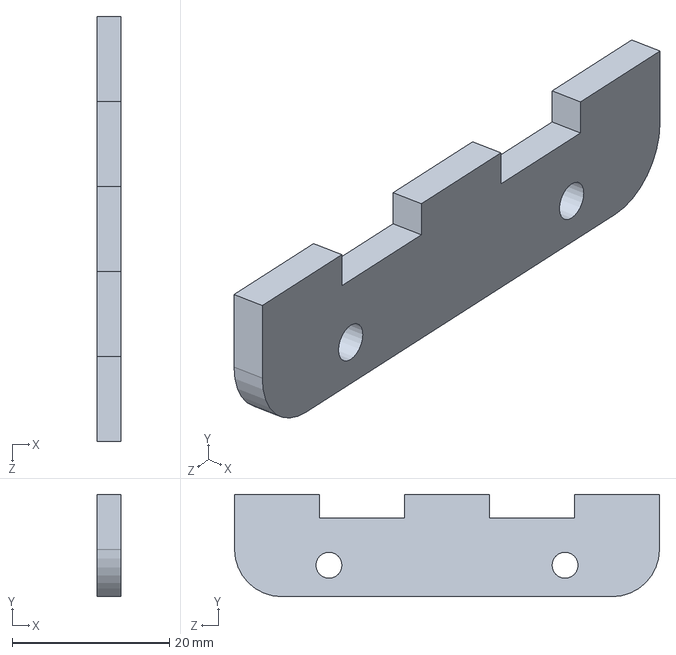
[picture p126: CAD file, 2018-03-03]
Sources/CAD/Solidworks Files/Arduino Holder/Part_A_1.SLDPRT
3.00 x 13.0 x 54.0 mm
