SaadOjo/OJO/Sources/CAD/Solidworks Files/battery holder/bat_short_wall_1.SLDPRT

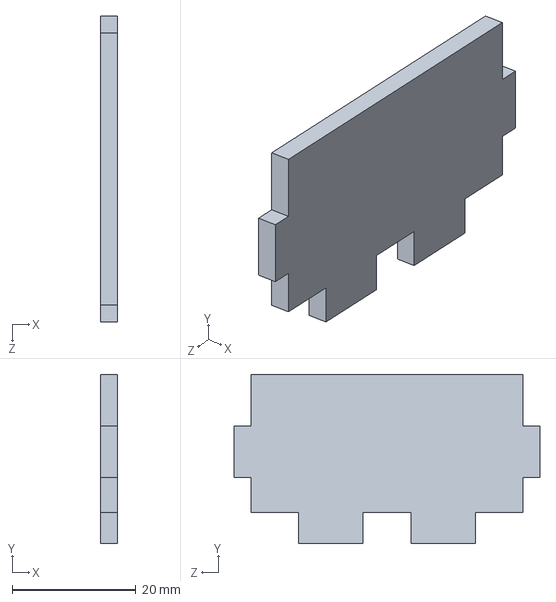
[picture p127: CAD file, 2018-05-15]
Sources/CAD/Solidworks Files/battery holder/bat_short_wall_1.SLDPRT
2.70 x 27.3 x 49.4 mm
