SaadOjo/OJO/Sources/CAD/Solidworks Files/Front Holder/Arduino_nano_holder.SLDPRT

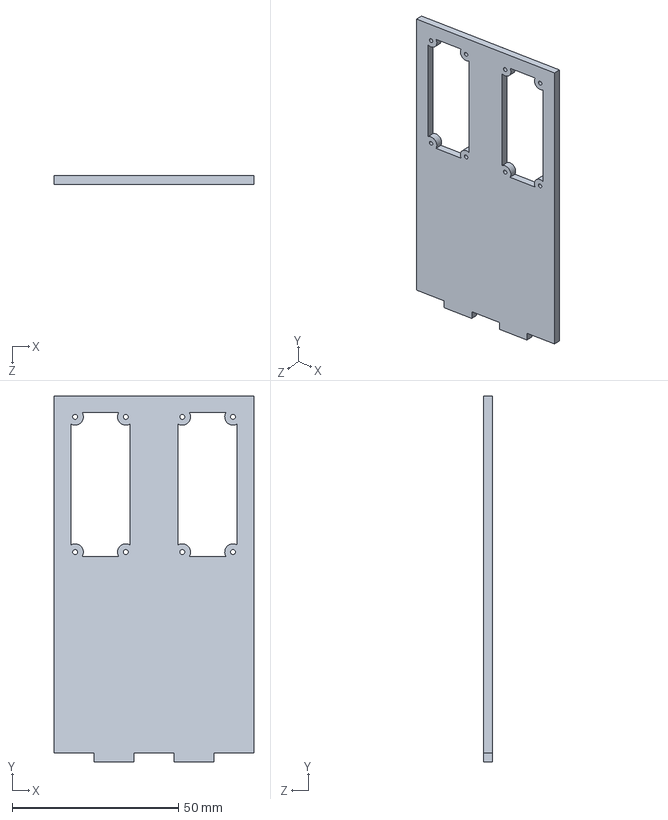
[picture p128: CAD file, 2018-05-15]
Sources/CAD/Solidworks Files/Front Holder/Arduino_nano_holder.SLDPRT
60.0 x 110.0 x 2.70 mm
