SaadOjo/OJO/Sources/CAD/Solidworks Files/Holder for direction and distance sensors/First (and failed) trial in 3D/new_holder_06.SLDPRT

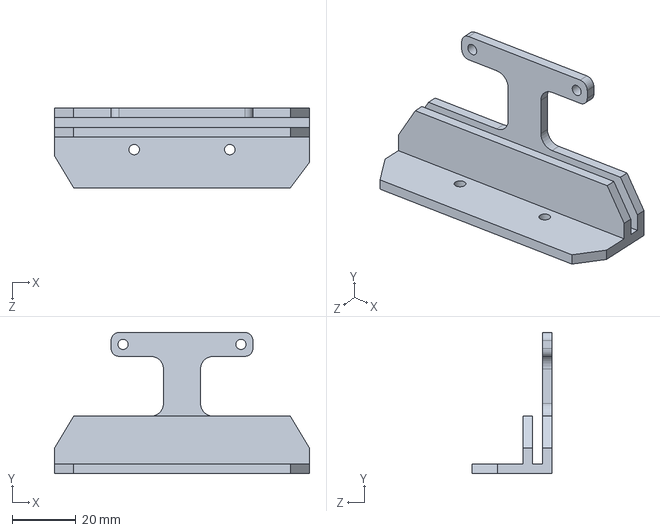
[picture p129: CAD file, 2018-03-02]
Sources/CAD/Solidworks Files/Holder for direction and distance sensors/First (and failed) trial in 3D/new_holder_06.SLDPRT
80.0 x 44.2 x 25.0 mm
