SaadOjo/OJO/Sources/CAD/Solidworks Files/Holder for direction and distance sensors/Separate parts/dxf/holder_A_2.DXF

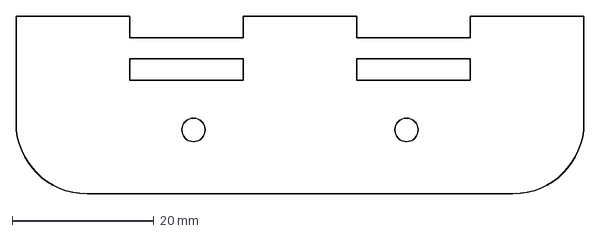
[picture p130: CAD file, 2018-03-03]
Sources/CAD/Solidworks Files/Holder for direction and distance sensors/Separate parts/dxf/holder_A_2.DXF
80.0 x 25.0 mm
