SaadOjo/OJO/Sources/CAD/Solidworks Files/Holder for direction and distance sensors/Separate parts/holder_B_2.SLDPRT

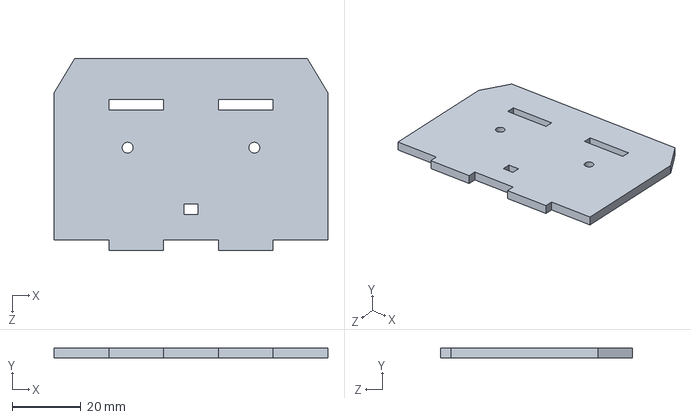
[picture p131: CAD file, 2018-03-08]
Sources/CAD/Solidworks Files/Holder for direction and distance sensors/Separate parts/holder_B_2.SLDPRT
80.0 x 3.00 x 56.0 mm
