SaadOjo/OJO/Sources/CAD/Solidworks Files/Holder for solar panel/dxf/Part_D1.DXF

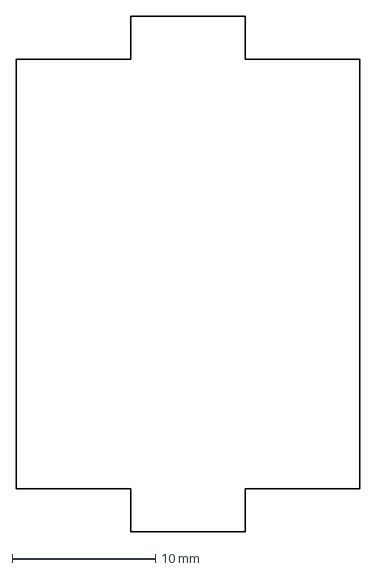
[picture p132: CAD file, 2018-03-02]
Sources/CAD/Solidworks Files/Holder for solar panel/dxf/Part_D1.DXF
24.0 x 36.0 mm
