SaadOjo/OJO/Sources/CAD/Solidworks Files/Monitor_3/dxfs/3mm/boxFiles/box_top_plate.DXF

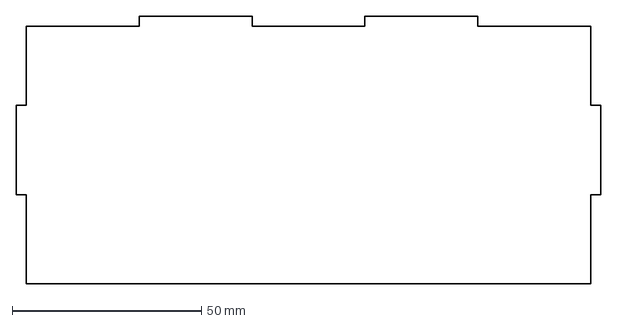
[picture p133: CAD file, 2018-05-15]
Sources/CAD/Solidworks Files/Monitor_3/dxfs/3mm/boxFiles/box_top_plate.DXF
154.4 x 70.7 mm
