SaadOjo/OJO/Sources/CAD/Solidworks Files/Monitor_3/dxfs/3mm/buttonHolder/base_plate.DXF

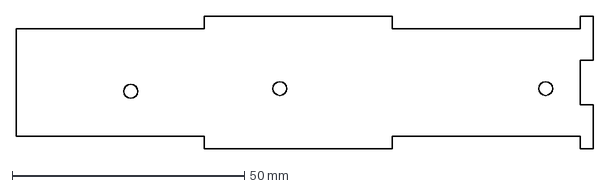
[picture p134: CAD file, 2018-05-15]
Sources/CAD/Solidworks Files/Monitor_3/dxfs/3mm/buttonHolder/base_plate.DXF
124.2 x 28.6 mm
