SaadOjo/OJO/Sources/CAD/Solidworks Files/Monitor_3/dxfs/3mm/monitorFiles/I_1_sidebezel.DXF

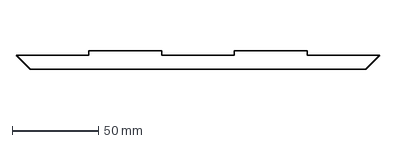
[picture p135: CAD file, 2018-05-15]
Sources/CAD/Solidworks Files/Monitor_3/dxfs/3mm/monitorFiles/I_1_sidebezel.DXF
211.0 x 10.7 mm
