SaadOjo/OJO/Sources/CAD/Solidworks Files/Monitor_3/dxfs/5mm/B_4_base.DXF

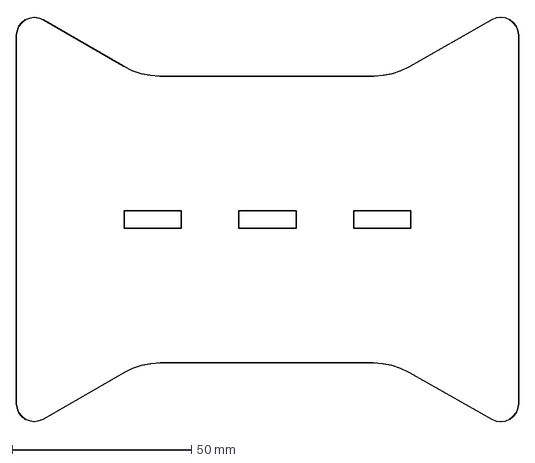
[picture p136: CAD file, 2018-05-15]
Sources/CAD/Solidworks Files/Monitor_3/dxfs/5mm/B_4_base.DXF
140.0 x 113.3 mm
