SaadOjo/OJO/Sources/CAD/Solidworks Files/new back holder/new_back_holder_base.SLDPRT

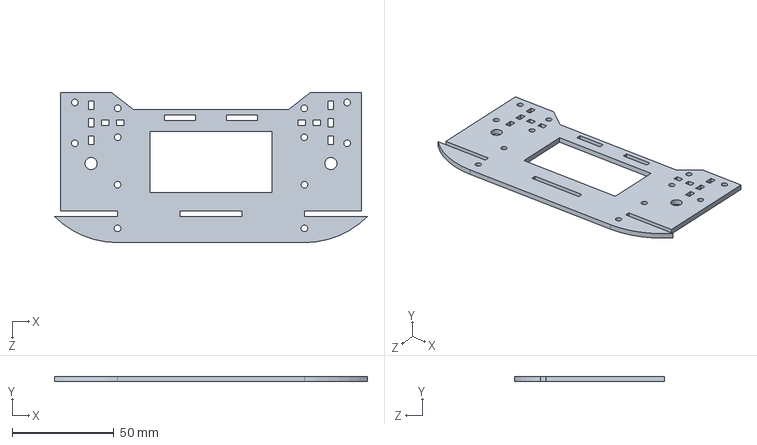
[picture p137: CAD file, 2018-05-15]
Sources/CAD/Solidworks Files/new back holder/new_back_holder_base.SLDPRT
154.1 x 2.70 x 73.9 mm
