SaadOjo/OJO/Sources/CAD/Solidworks Files/OJO logo/OJO_logo.SLDPRT

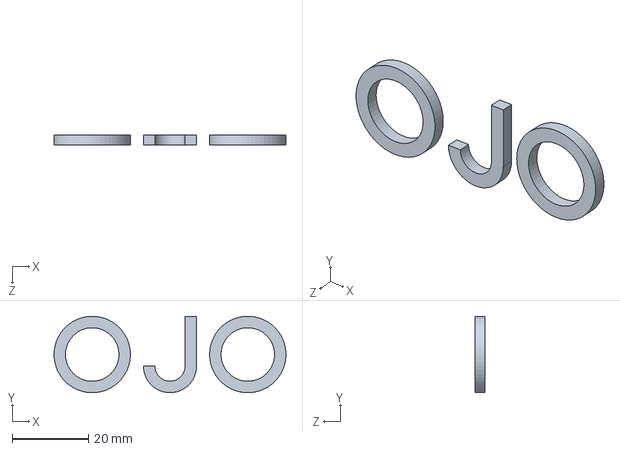
[picture p138: CAD file, 2018-05-15]
Sources/CAD/Solidworks Files/OJO logo/OJO_logo.SLDPRT
60.7 x 20.0 x 2.70 mm
