SaadOjo/OJO/Sources/CAD/Solidworks Files/This little thing/Part2.SLDPRT

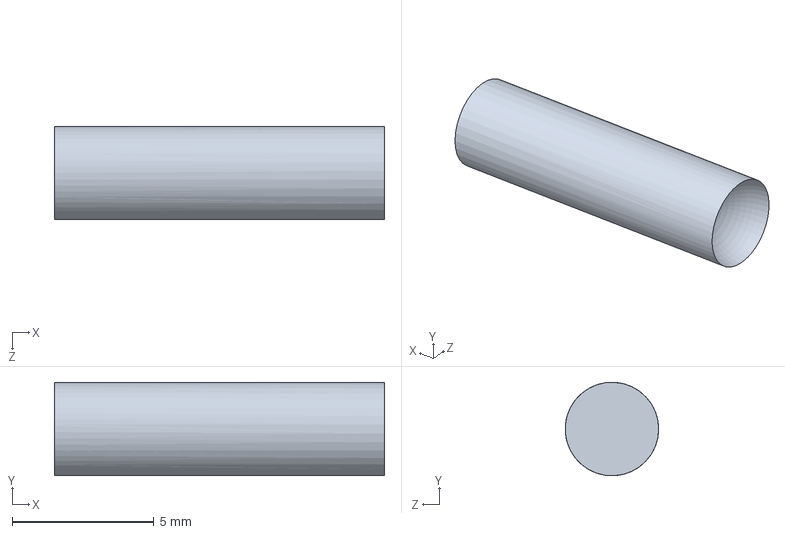
[picture p139: CAD file, 2018-03-08]
Sources/CAD/Solidworks Files/This little thing/Part2.SLDPRT
11.6 x 3.30 x 3.30 mm
