SaadOjo/OJO/Sources/CAD/Solidworks Files/Walls (Box)/Side_2.SLDPRT

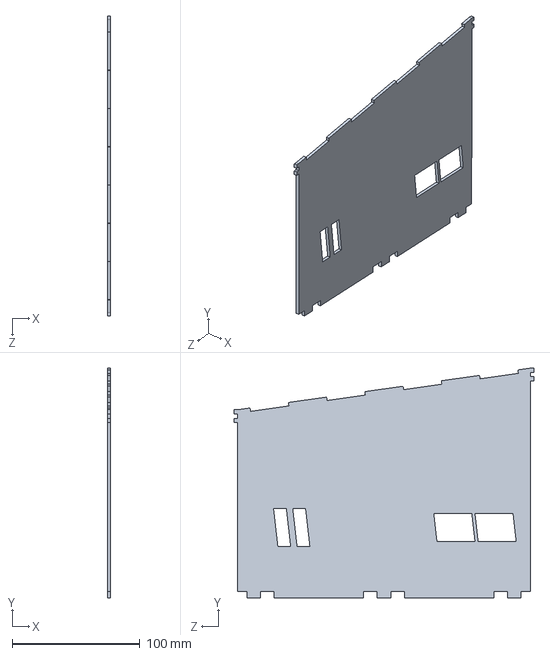
[picture p140: CAD file, 2018-05-15]
Sources/CAD/Solidworks Files/Walls (Box)/Side_2.SLDPRT
2.70 x 179.5 x 234.4 mm

Sources/CAD/Drawings of purchased items/drawings of microcontrollers and camera/rpi_MECH_3b_1p2.dxf
J13
U8
U19
U16
X2
F1
J9
U20
U1
L3
R81
C258
C256
C252
U18
U17
U15
U2
J10
R66
R42
R83
R75
R43
R4
R31
R82
R38
R61
R60
R8
R6
R5
R58
R57
R56
R55
R79
R78
R77
R76
R54
R52
R51
R25
R10
R45
R12
R13
R72
R71
R70
R69
R68
R67
R22
R21
R24
R23
R50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
