SaadOjo/OJO/Sources/CAD/Solidworks Files/00 Non Project Related/Batman/BATMAN.SLDPRT

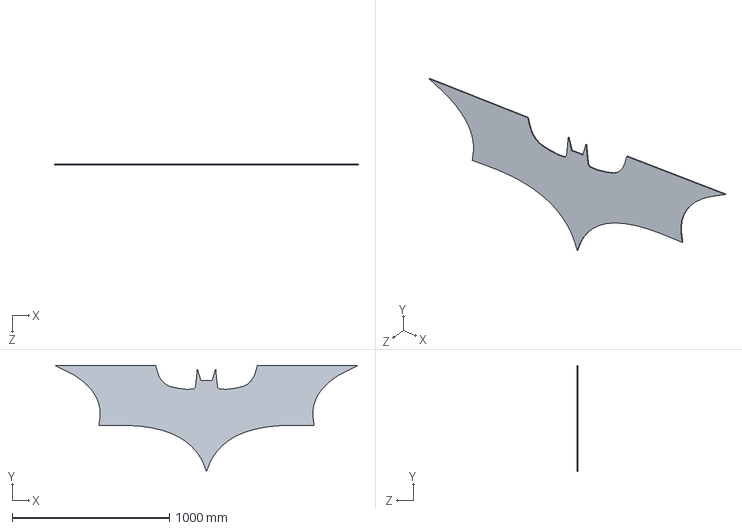
[picture p142: CAD file, 2018-03-16]
Sources/CAD/Solidworks Files/00 Non Project Related/Batman/BATMAN.SLDPRT
1936.0 x 678.0 x 5.00 mm
