SaadOjo/OJO/Sources/CAD/Solidworks Files/00 Non Project Related/coinSeperator/coin_plate.SLDPRT

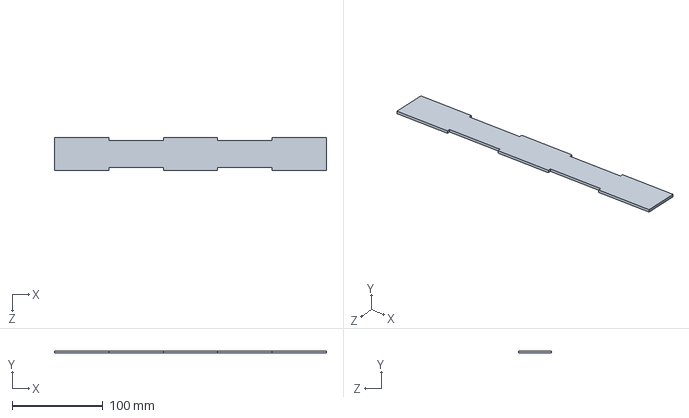
[picture p143: CAD file, 2018-03-12]
Sources/CAD/Solidworks Files/00 Non Project Related/coinSeperator/coin_plate.SLDPRT
300.0 x 2.70 x 36.4 mm
