SaadOjo/OJO/Sources/CAD/Solidworks Files/00 Non Project Related/Monitor/dxf/3mm/box/BOX_B_1.DXF

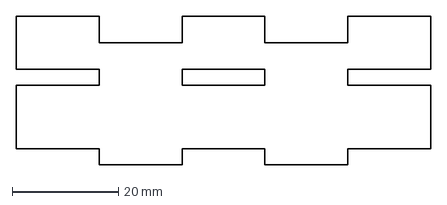
[picture p144: CAD file, 2018-03-06]
Sources/CAD/Solidworks Files/00 Non Project Related/Monitor/dxf/3mm/box/BOX_B_1.DXF
78.0 x 28.0 mm
