SaadOjo/OJO/Sources/CAD/Solidworks Files/00 Non Project Related/Monitor/dxf/3mm/H_1.DXF

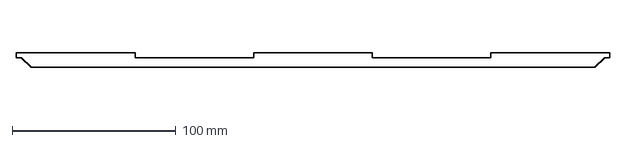
[picture p145: CAD file, 2018-03-06]
Sources/CAD/Solidworks Files/00 Non Project Related/Monitor/dxf/3mm/H_1.DXF
362.3 x 9.00 mm
