SaadOjo/OJO/Sources/CAD/Solidworks Files/00 Non Project Related/Monitor/dxf/5mm/A_1.DXF

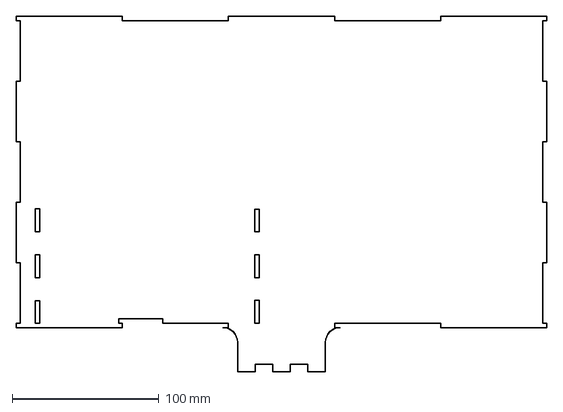
[picture p146: CAD file, 2018-03-06]
Sources/CAD/Solidworks Files/00 Non Project Related/Monitor/dxf/5mm/A_1.DXF
362.3 x 242.5 mm
