SaadOjo/OJO/Sources/CAD/Solidworks Files/00 Non Project Related/Monitor/Electronics Box/BOX_C_1.SLDPRT

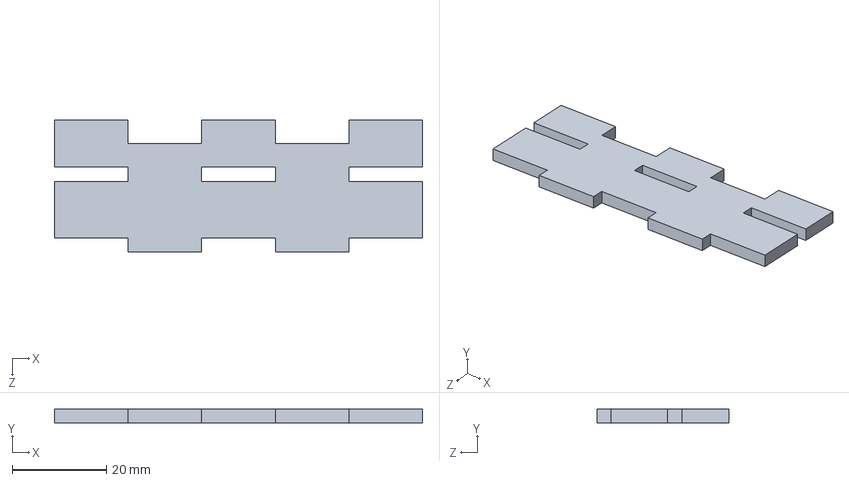
[picture p147: CAD file, 2018-03-06]
Sources/CAD/Solidworks Files/00 Non Project Related/Monitor/Electronics Box/BOX_C_1.SLDPRT
78.0 x 3.00 x 28.0 mm
