SaadOjo/OJO/Sources/CAD/Solidworks Files/00 Non Project Related/Monitor_2/3mm/G_1_topbezel.SLDPRT

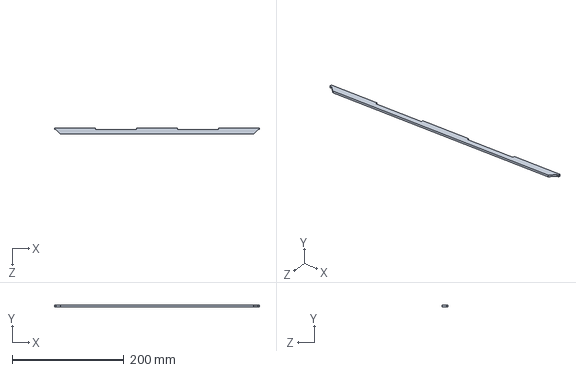
[picture p149: CAD file, 2018-03-10]
Sources/CAD/Solidworks Files/00 Non Project Related/Monitor_2/3mm/G_1_topbezel.SLDPRT
366.4 x 2.70 x 10.7 mm
