SaadOjo/OJO/Sources/CAD/Solidworks Files/00 Non Project Related/Monitor_2/5mm/B_4_base.SLDPRT

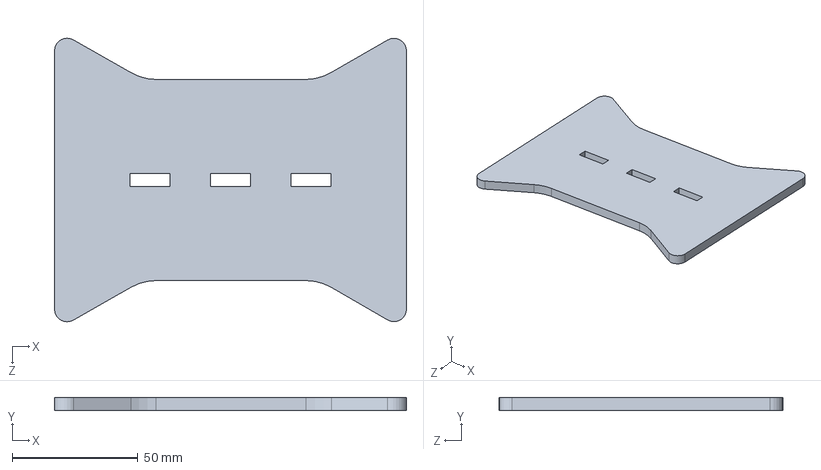
[picture p150: CAD file, 2018-03-12]
Sources/CAD/Solidworks Files/00 Non Project Related/Monitor_2/5mm/B_4_base.SLDPRT
140.0 x 5.00 x 112.8 mm
