SaadOjo/OJO/Sources/CAD/Solidworks Files/00 Non Project Related/Monitor_2/ButtonCase/other_side_1.SLDPRT

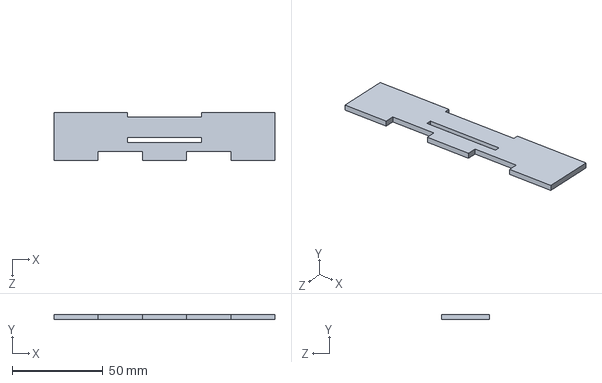
[picture p151: CAD file, 2018-03-17]
Sources/CAD/Solidworks Files/00 Non Project Related/Monitor_2/ButtonCase/other_side_1.SLDPRT
121.5 x 2.70 x 26.6 mm
