SaadOjo/OJO/Sources/CAD/Solidworks Files/00 Non Project Related/Monitor_2/ElectronicsBox/box_back_plate.SLDPRT

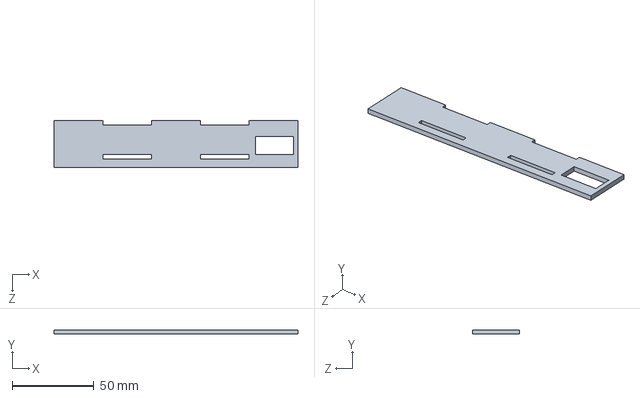
[picture p152: CAD file, 2018-05-15]
Sources/CAD/Solidworks Files/00 Non Project Related/Monitor_2/ElectronicsBox/box_back_plate.SLDPRT
149.0 x 2.70 x 28.4 mm
