SaadOjo/OJO/Sources/CAD/Solidworks Files/00 Non Project Related/Monitor_3/2.7 mm/OJO LOGO.SLDPRT

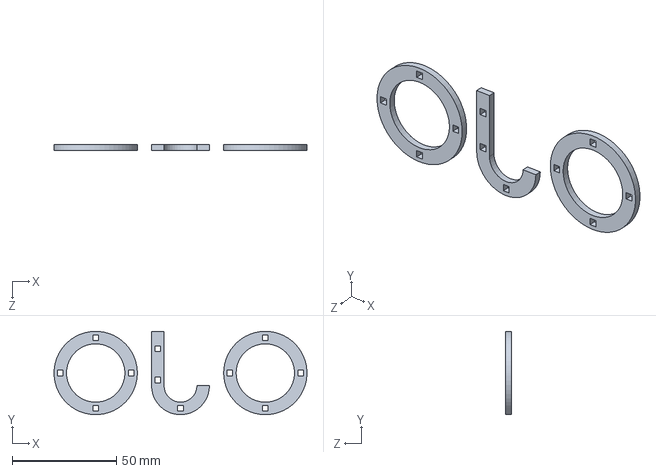
[picture p153: CAD file, 2018-03-16]
Sources/CAD/Solidworks Files/00 Non Project Related/Monitor_3/2.7 mm/OJO LOGO.SLDPRT
121.4 x 40.0 x 2.70 mm
