SaadOjo/OJO/Sources/CAD/Solidworks Files/00 Non Project Related/Monitor_3/ButtonCase/top.SLDPRT

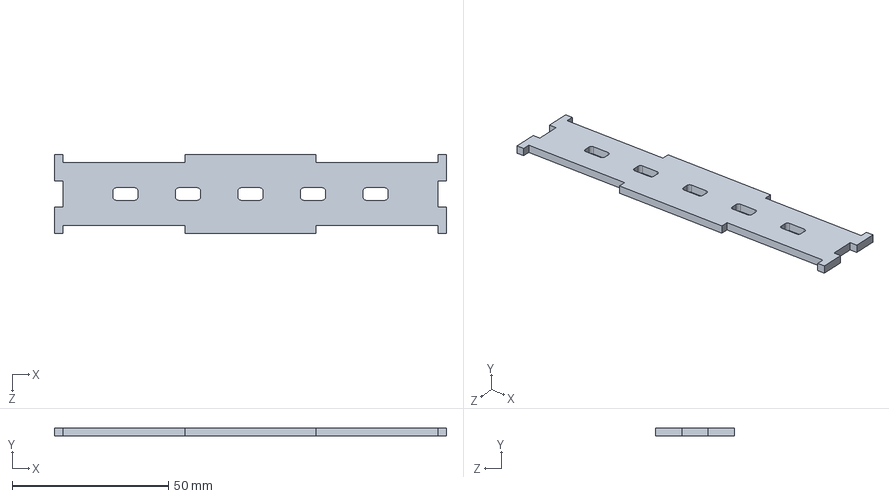
[picture p154: CAD file, 2018-03-12]
Sources/CAD/Solidworks Files/00 Non Project Related/Monitor_3/ButtonCase/top.SLDPRT
125.4 x 2.70 x 25.4 mm
