SaadOjo/OJO/Sources/CAD/Solidworks Files/10 to be cut/2.7 mm/Solidworks/top.SLDPRT

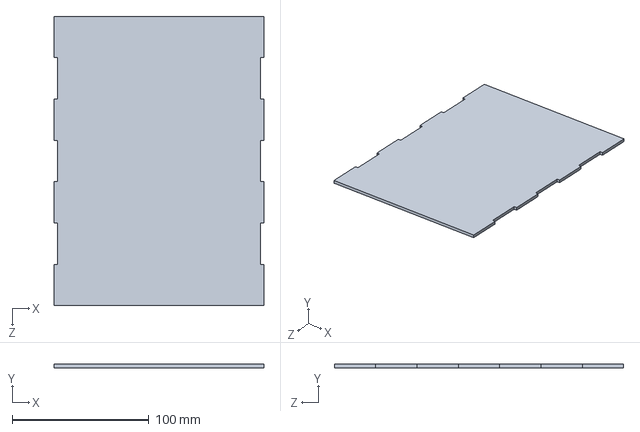
[picture p155: CAD file, 2018-05-15]
Sources/CAD/Solidworks Files/10 to be cut/2.7 mm/Solidworks/top.SLDPRT
153.4 x 2.70 x 211.3 mm
