SaadOjo/OJO/Sources/CAD/Solidworks Files/Arduino Holder/Part_B_1.SLDPRT

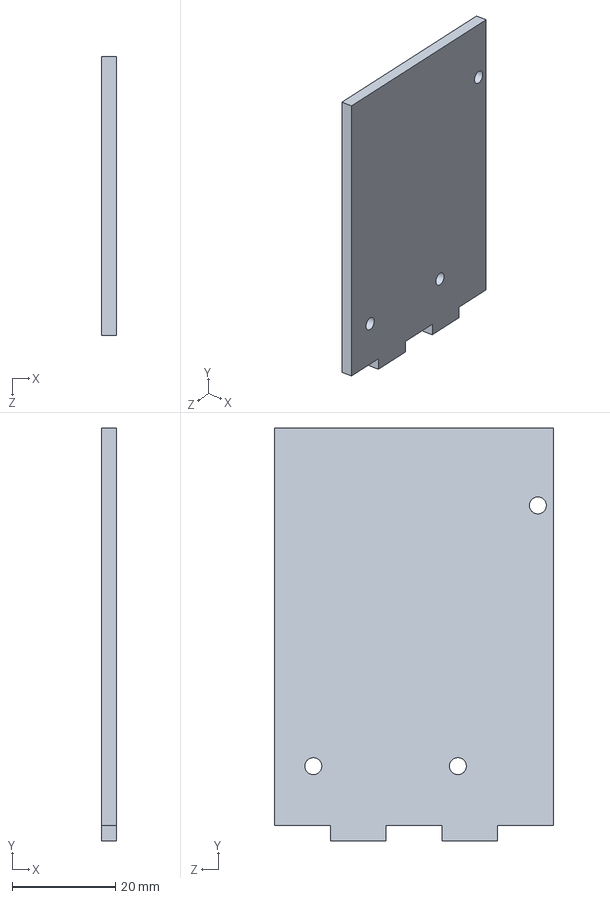
[picture p156: CAD file, 2018-03-03]
Sources/CAD/Solidworks Files/Arduino Holder/Part_B_1.SLDPRT
3.00 x 80.0 x 54.0 mm
