SaadOjo/OJO/Sources/CAD/Solidworks Files/Holder for direction and distance sensors/First (and failed) trial in 3D/new_holder_05.SLDPRT

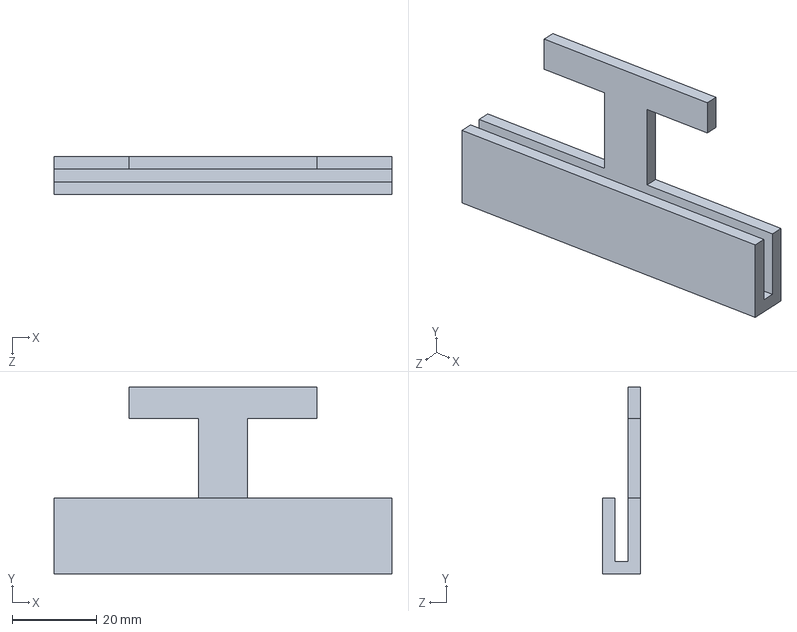
[picture p157: CAD file, 2018-03-02]
Sources/CAD/Solidworks Files/Holder for direction and distance sensors/First (and failed) trial in 3D/new_holder_05.SLDPRT
80.0 x 44.2 x 9.00 mm
