SaadOjo/OJO/Sources/CAD/Solidworks Files/Holder for direction and distance sensors/Separate parts/Assem part.SLDPRT

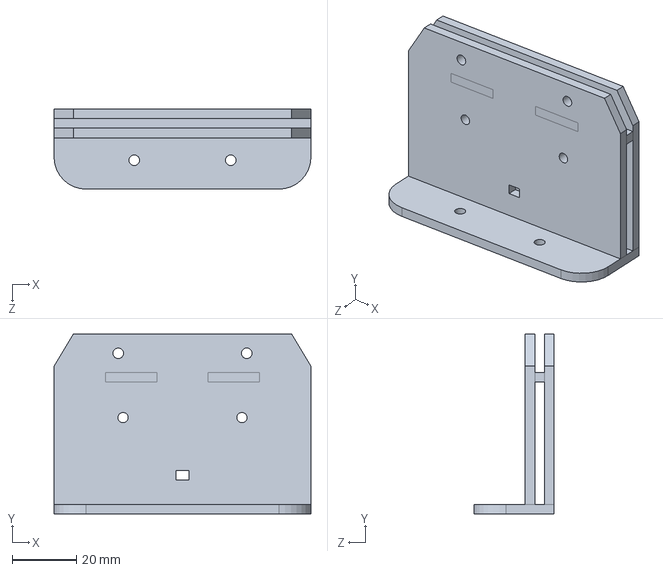
[picture p158: CAD file, 2018-03-03]
Sources/CAD/Solidworks Files/Holder for direction and distance sensors/Separate parts/Assem part.SLDPRT
80.0 x 56.0 x 25.0 mm
