SaadOjo/OJO/Sources/CAD/Solidworks Files/Monitor_3/dxfs/3mm/boxFiles/left_side_plate.DXF

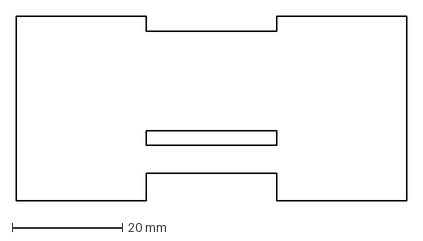
[picture p160: CAD file, 2018-05-15]
Sources/CAD/Solidworks Files/Monitor_3/dxfs/3mm/boxFiles/left_side_plate.DXF
70.7 x 33.4 mm
