SaadOjo/OJO/Sources/CAD/Solidworks Files/Monitor_3/dxfs/3mm/buttonHolder/top_plate.DXF

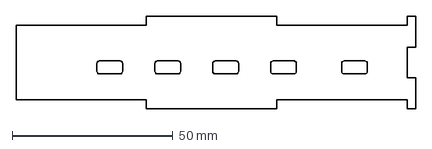
[picture p161: CAD file, 2018-05-15]
Sources/CAD/Solidworks Files/Monitor_3/dxfs/3mm/buttonHolder/top_plate.DXF
124.2 x 28.6 mm
