SaadOjo/OJO/Sources/CAD/Solidworks Files/Monitor_3/dxfs/5mm/A_1_other.DXF

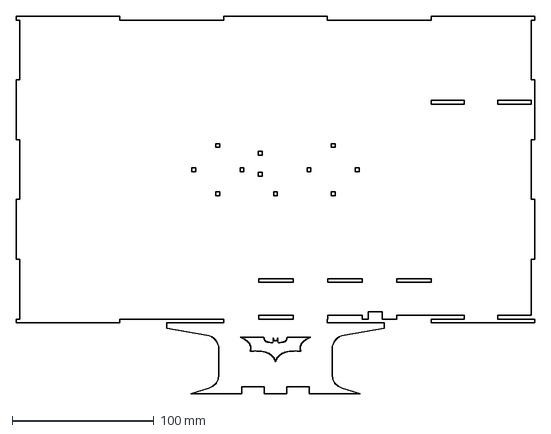
[picture p163: CAD file, 2018-05-15]
Sources/CAD/Solidworks Files/Monitor_3/dxfs/5mm/A_1_other.DXF
366.4 x 266.4 mm
