SaadOjo/OJO/Sources/CAD/Solidworks Files/seven segment box/partsev_top.SLDPRT

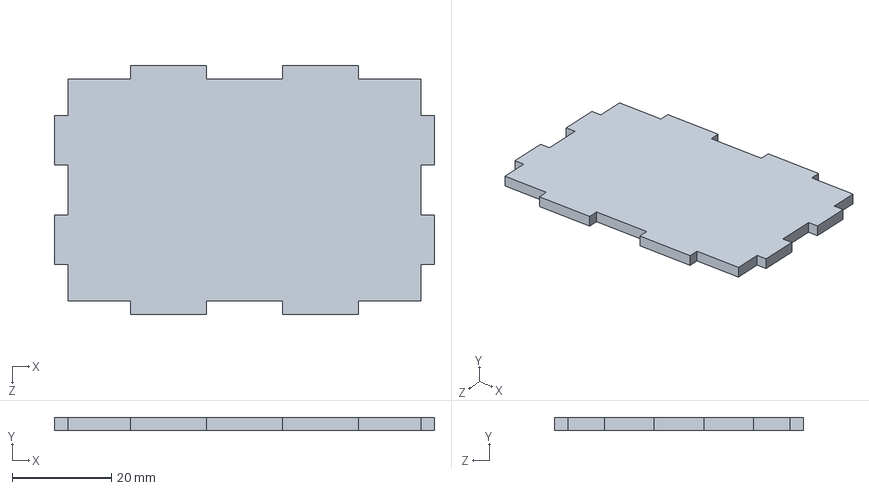
[picture p164: CAD file, 2018-05-15]
Sources/CAD/Solidworks Files/seven segment box/partsev_top.SLDPRT
76.4 x 2.70 x 50.0 mm
