SaadOjo/OJO/Sources/CAD/Solidworks Files/This little thing/Part1.SLDPRT

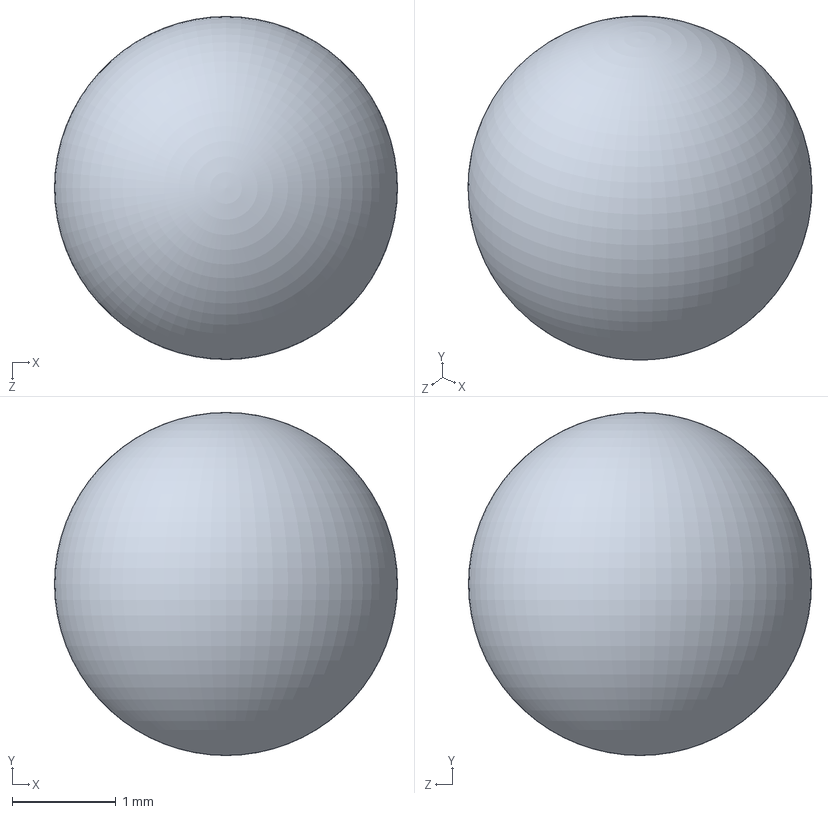
[picture p165: CAD file, 2018-03-08]
Sources/CAD/Solidworks Files/This little thing/Part1.SLDPRT
3.30 x 3.30 x 3.30 mm
