SaadOjo/OJO/Sources/CAD/Solidworks Files/00 Non Project Related/Batman/BAT HEAD.SLDPRT

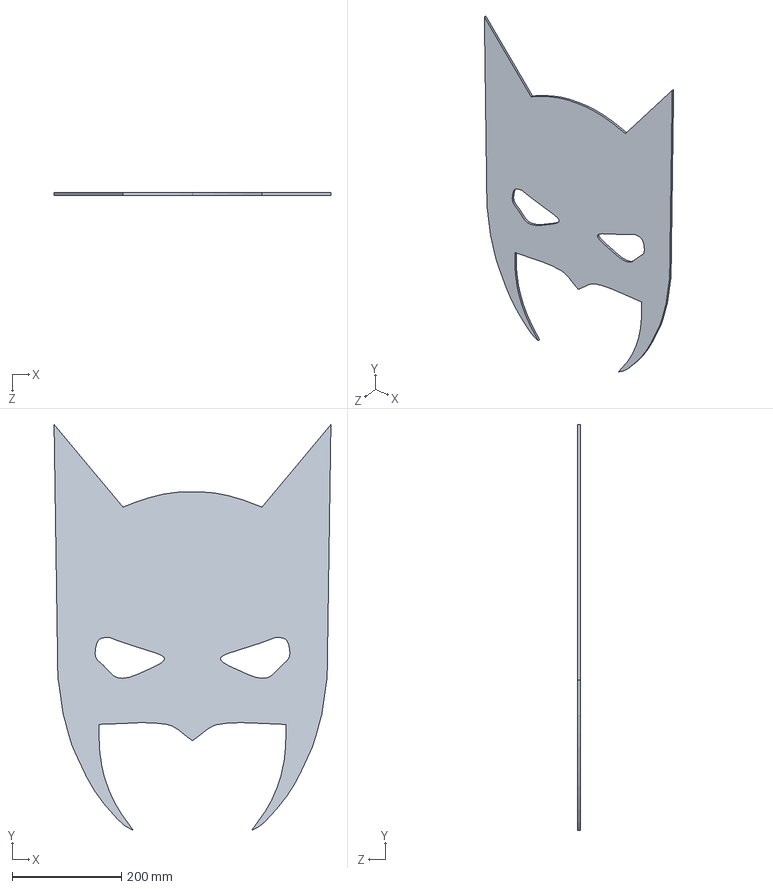
[picture p166: CAD file, 2018-03-16]
Sources/CAD/Solidworks Files/00 Non Project Related/Batman/BAT HEAD.SLDPRT
506.0 x 742.0 x 5.00 mm
