SaadOjo/OJO/Sources/CAD/Solidworks Files/00 Non Project Related/coinSeperator/side_wall_1.SLDPRT

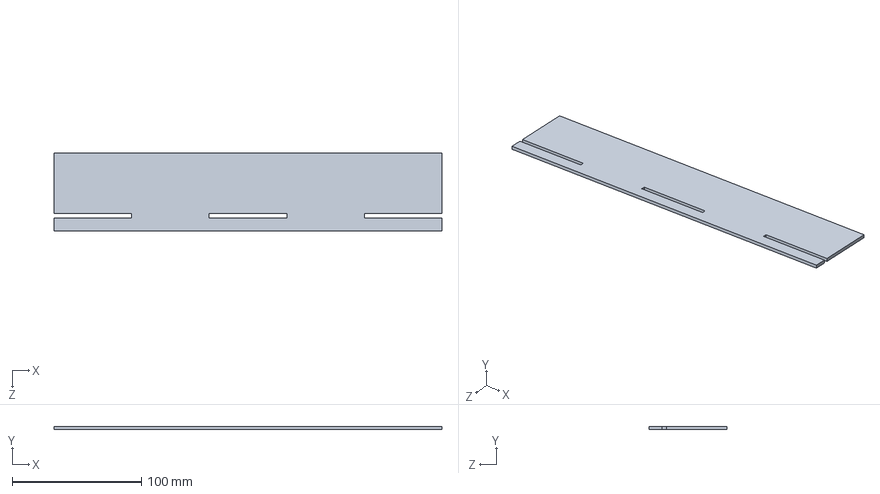
[picture p167: CAD file, 2018-03-12]
Sources/CAD/Solidworks Files/00 Non Project Related/coinSeperator/side_wall_1.SLDPRT
300.0 x 2.70 x 60.0 mm
