SaadOjo/OJO/Sources/CAD/Solidworks Files/00 Non Project Related/Monitor/J_1.SLDPRT

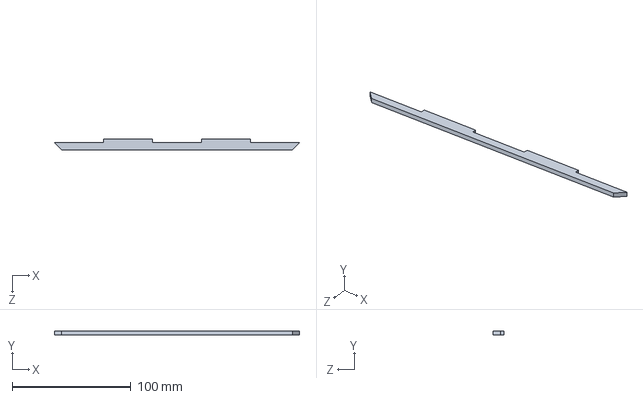
[picture p170: CAD file, 2018-03-06]
Sources/CAD/Solidworks Files/00 Non Project Related/Monitor/J_1.SLDPRT
206.5 x 3.00 x 9.00 mm
