SaadOjo/OJO/Sources/CAD/Solidworks Files/00 Non Project Related/Monitor_2/ButtonCase/base_plate.SLDPRT

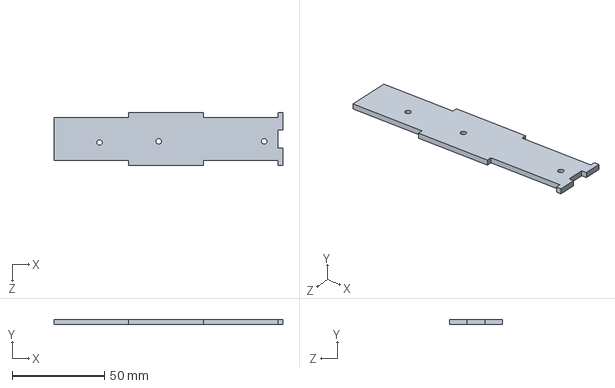
[picture p171: CAD file, 2018-03-17]
Sources/CAD/Solidworks Files/00 Non Project Related/Monitor_2/ButtonCase/base_plate.SLDPRT
124.2 x 2.70 x 28.6 mm
