SaadOjo/OJO/Sources/CAD/Solidworks Files/00 Non Project Related/Monitor_3/3mm/J_1_sidebezel.SLDPRT

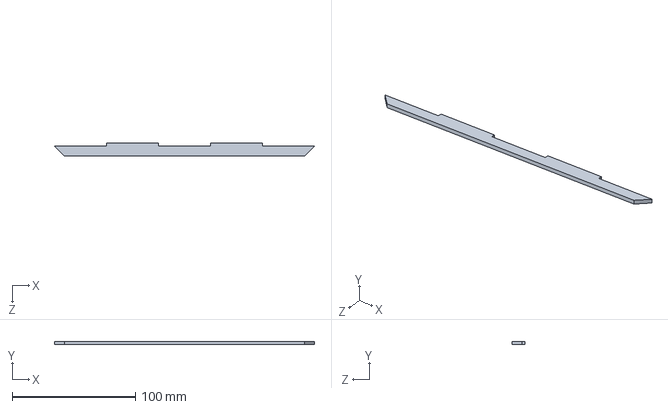
[picture p172: CAD file, 2018-03-10]
Sources/CAD/Solidworks Files/00 Non Project Related/Monitor_3/3mm/J_1_sidebezel.SLDPRT
211.0 x 2.70 x 10.7 mm
