SaadOjo/OJO/Sources/CAD/Solidworks Files/00 Non Project Related/Monitor_3/ButtonCase/boxlongedge.SLDPRT

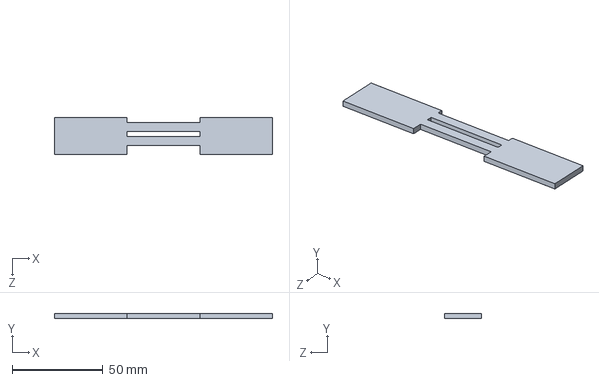
[picture p173: CAD file, 2018-03-12]
Sources/CAD/Solidworks Files/00 Non Project Related/Monitor_3/ButtonCase/boxlongedge.SLDPRT
120.0 x 2.70 x 20.4 mm
