SaadOjo/OJO/Sources/CAD/Solidworks Files/00 Non Project Related/shelf/B_1_prime.SLDPRT

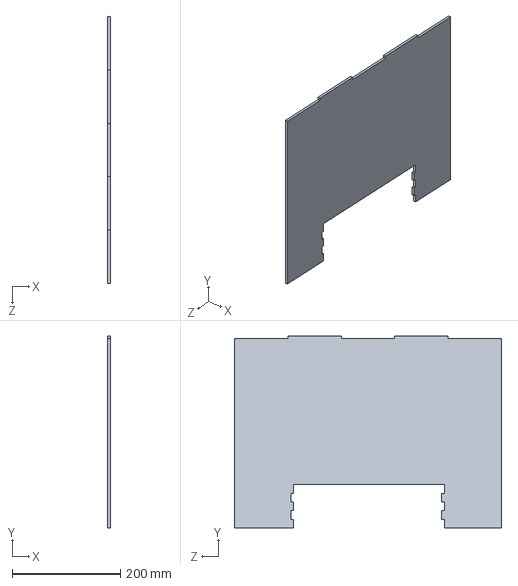
[picture p174: CAD file, 2018-03-12]
Sources/CAD/Solidworks Files/00 Non Project Related/shelf/B_1_prime.SLDPRT
5.00 x 355.0 x 494.0 mm
