SaadOjo/OJO/Sources/CAD/Solidworks Files/10 to be cut/2.7 mm/Solidworks/Raspberry_holder.SLDPRT

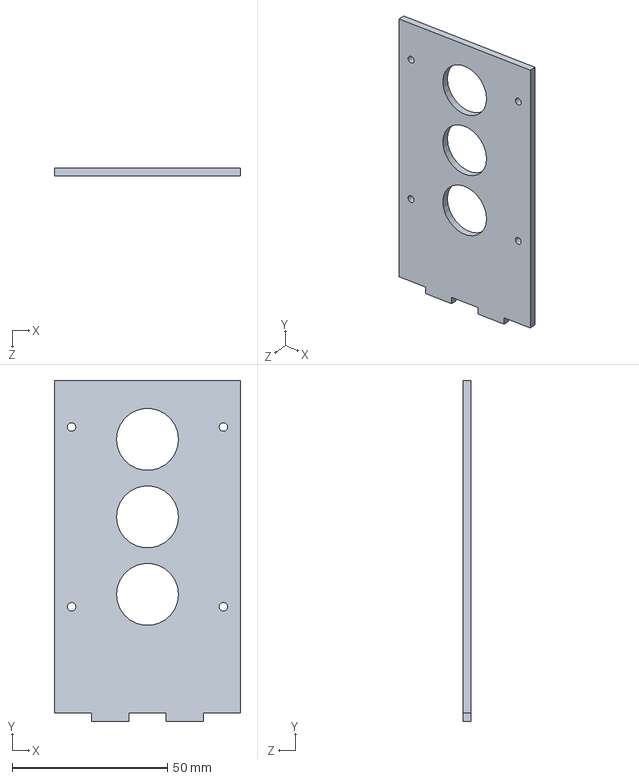
[picture p175: CAD file, 2018-05-15]
Sources/CAD/Solidworks Files/10 to be cut/2.7 mm/Solidworks/Raspberry_holder.SLDPRT
60.0 x 110.0 x 2.70 mm
