SaadOjo/OJO/Sources/CAD/Solidworks Files/Holder for direction and distance sensors/Separate parts/holder_A_1.SLDPRT

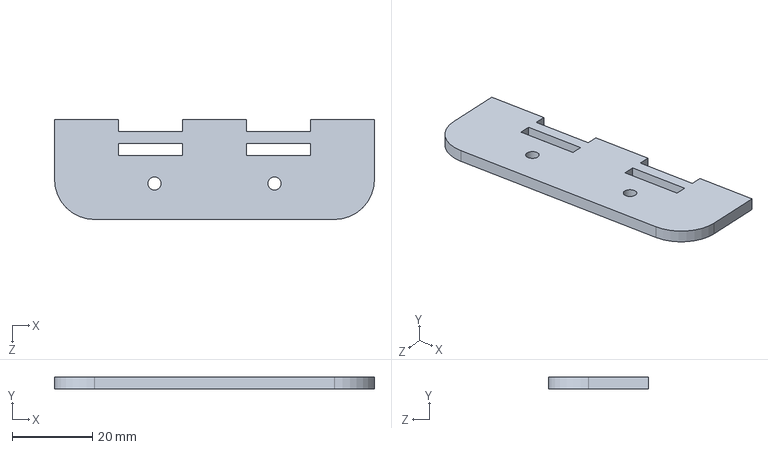
[picture p176: CAD file, 2018-03-03]
Sources/CAD/Solidworks Files/Holder for direction and distance sensors/Separate parts/holder_A_1.SLDPRT
80.0 x 3.00 x 25.0 mm
