SaadOjo/OJO/Sources/CAD/Solidworks Files/Holder for solar panel/dxf/part_A1.DXF

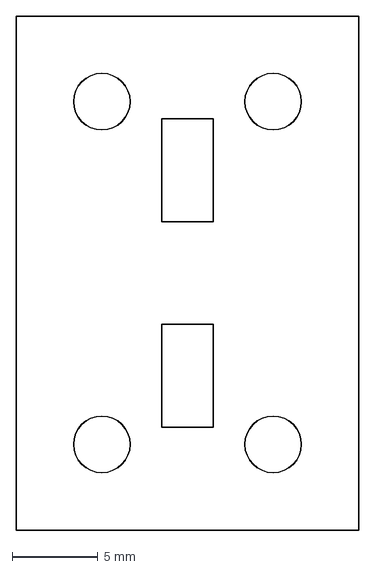
[picture p177: CAD file, 2018-03-02]
Sources/CAD/Solidworks Files/Holder for solar panel/dxf/part_A1.DXF
20.0 x 30.0 mm
