SaadOjo/OJO/Sources/CAD/Solidworks Files/Monitor_3/dxfs/3mm/boxFiles/box_back_plate.DXF

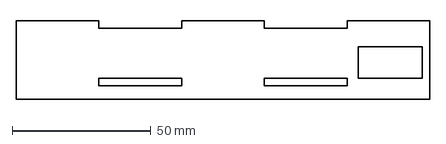
[picture p178: CAD file, 2018-05-15]
Sources/CAD/Solidworks Files/Monitor_3/dxfs/3mm/boxFiles/box_back_plate.DXF
149.0 x 28.4 mm
