SaadOjo/OJO/Sources/CAD/Solidworks Files/Monitor_3/dxfs/3mm/buttonHolder/side_plate.DXF

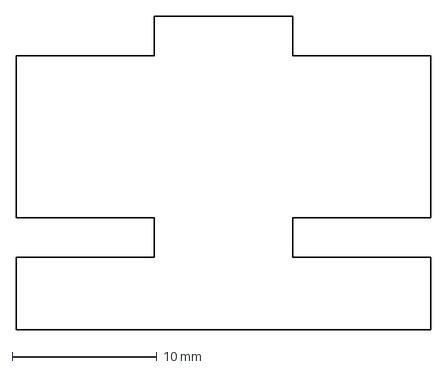
[picture p179: CAD file, 2018-05-15]
Sources/CAD/Solidworks Files/Monitor_3/dxfs/3mm/buttonHolder/side_plate.DXF
28.6 x 21.6 mm
