SaadOjo/OJO/Sources/CAD/Solidworks Files/Monitor_3/dxfs/3mm/monitorFiles/C_1_topdeepbezel.DXF

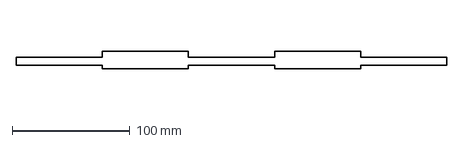
[picture p180: CAD file, 2018-05-15]
Sources/CAD/Solidworks Files/Monitor_3/dxfs/3mm/monitorFiles/C_1_topdeepbezel.DXF
366.4 x 14.7 mm
