SaadOjo/OJO/Sources/CAD/Solidworks Files/Monitor_3/dxfs/5mm/bt1.DXF

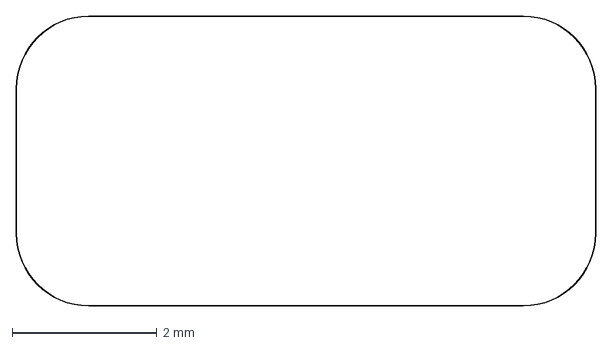
[picture p181: CAD file, 2018-05-15]
Sources/CAD/Solidworks Files/Monitor_3/dxfs/5mm/bt1.DXF
8.00 x 4.00 mm
