SaadOjo/OJO/Sources/CAD/Solidworks Files/new back holder/new_back_holder_solar_panel_and_laser_part_B.SLDPRT

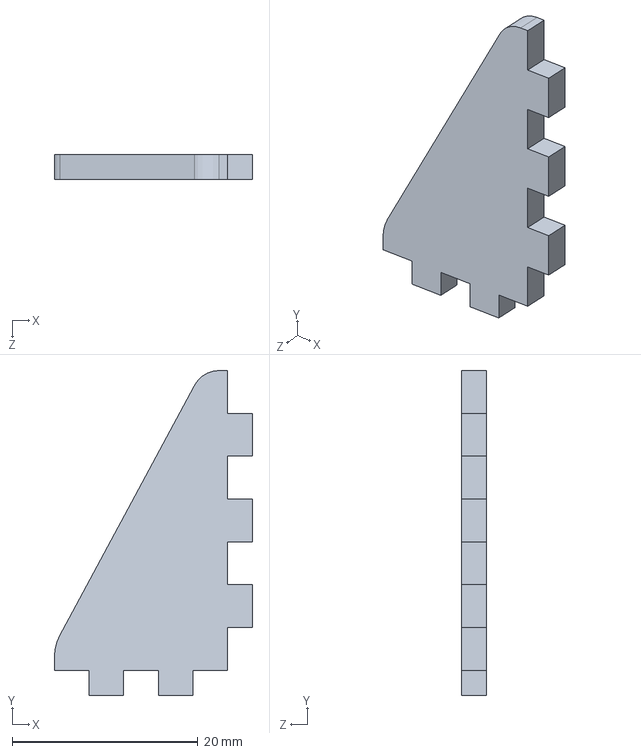
[picture p182: CAD file, 2018-05-15]
Sources/CAD/Solidworks Files/new back holder/new_back_holder_solar_panel_and_laser_part_B.SLDPRT
21.4 x 35.0 x 2.70 mm
