SaadOjo/OJO/Sources/CAD/Solidworks Files/seven segment box/partsev_side_1.SLDPRT

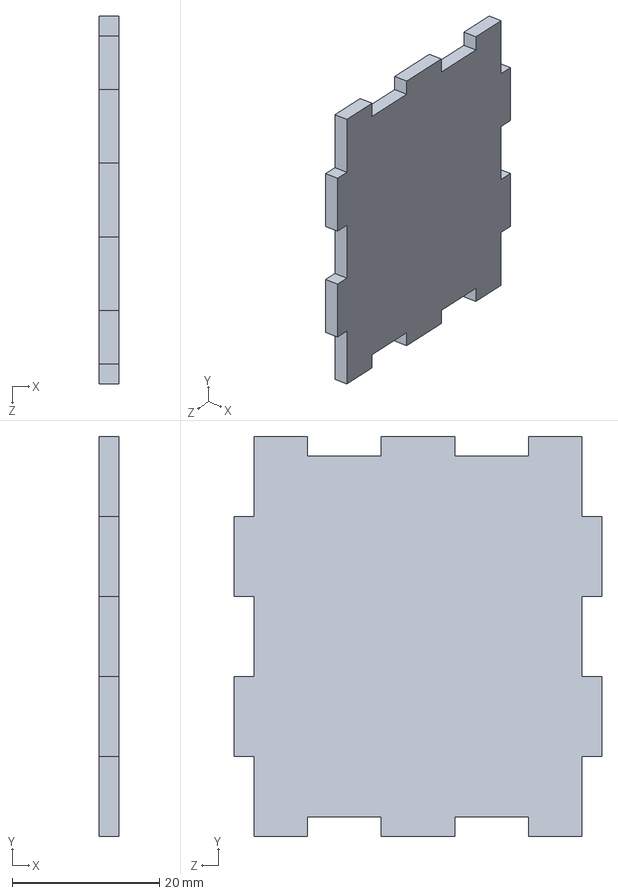
[picture p183: CAD file, 2018-05-15]
Sources/CAD/Solidworks Files/seven segment box/partsev_side_1.SLDPRT
2.70 x 54.4 x 50.0 mm
