SaadOjo/OJO/Sources/CAD/Solidworks Files/00 Non Project Related/Monitor/B_1.SLDPRT

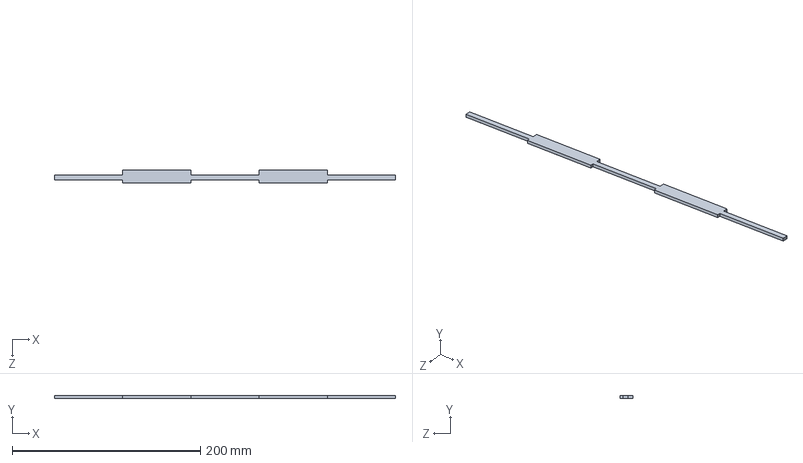
[picture p184: CAD file, 2018-03-06]
Sources/CAD/Solidworks Files/00 Non Project Related/Monitor/B_1.SLDPRT
362.3 x 3.00 x 13.5 mm
