SaadOjo/OJO/Sources/CAD/Solidworks Files/00 Non Project Related/Monitor/dxf/3mm/box/BOX_D_1.DXF

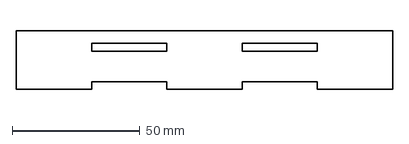
[picture p185: CAD file, 2018-03-06]
Sources/CAD/Solidworks Files/00 Non Project Related/Monitor/dxf/3mm/box/BOX_D_1.DXF
147.0 x 23.0 mm
