SaadOjo/OJO/Sources/CAD/Solidworks Files/00 Non Project Related/Monitor_2/ButtonCase/side_plate.SLDPRT

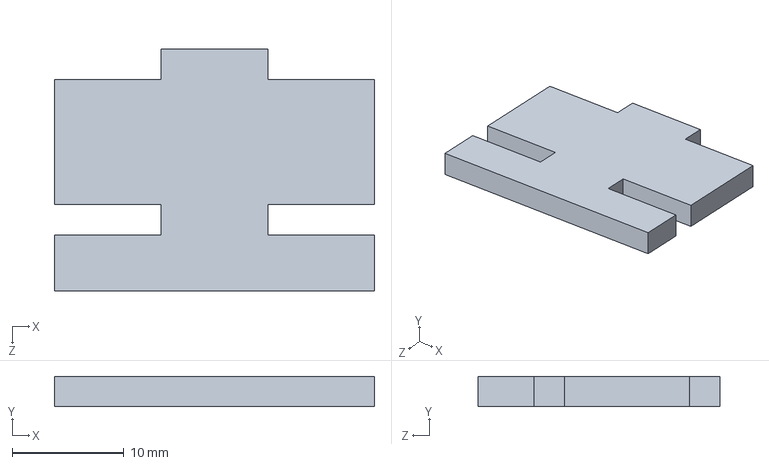
[picture p187: CAD file, 2018-03-17]
Sources/CAD/Solidworks Files/00 Non Project Related/Monitor_2/ButtonCase/side_plate.SLDPRT
28.6 x 2.70 x 21.6 mm
