SaadOjo/OJO/Sources/CAD/Solidworks Files/00 Non Project Related/Monitor_2/ElectronicsBox/box_top_plate.SLDPRT

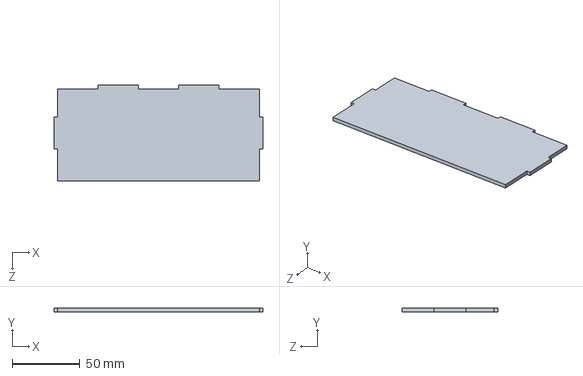
[picture p188: CAD file, 2018-03-17]
Sources/CAD/Solidworks Files/00 Non Project Related/Monitor_2/ElectronicsBox/box_top_plate.SLDPRT
154.4 x 2.70 x 70.7 mm
