SaadOjo/OJO/Sources/CAD/Solidworks Files/battery holder/bat_long_wall_1.SLDPRT

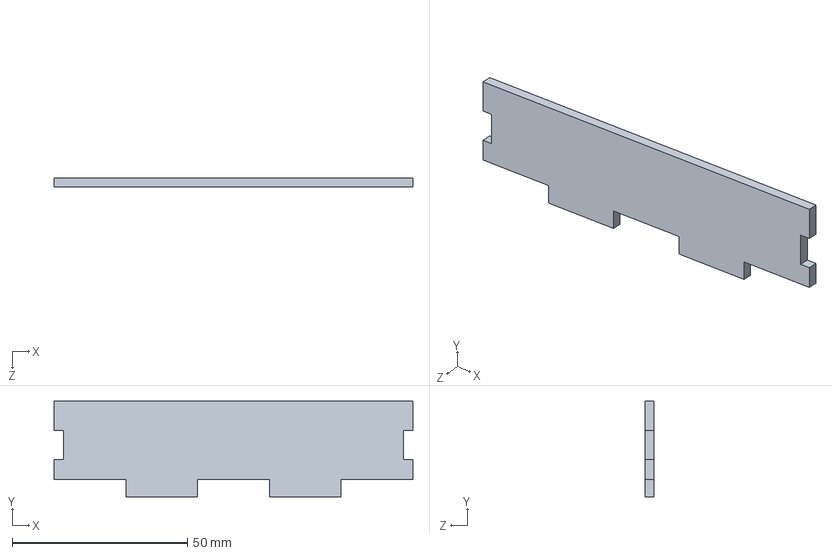
[picture p189: CAD file, 2018-05-15]
Sources/CAD/Solidworks Files/battery holder/bat_long_wall_1.SLDPRT
102.4 x 27.3 x 2.70 mm
