SaadOjo/OJO/Sources/CAD/Solidworks Files/Holder for direction and distance sensors/Separate parts/holder_C_1.SLDPRT

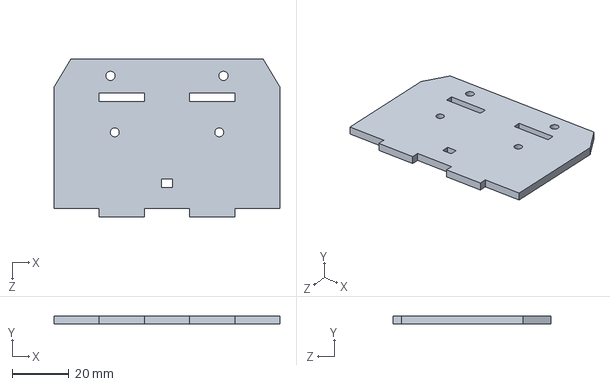
[picture p190: CAD file, 2018-03-02]
Sources/CAD/Solidworks Files/Holder for direction and distance sensors/Separate parts/holder_C_1.SLDPRT
80.0 x 3.00 x 56.0 mm
