SaadOjo/OJO/Sources/CAD/Solidworks Files/Holder for solar panel/dxf/Part_F1.DXF

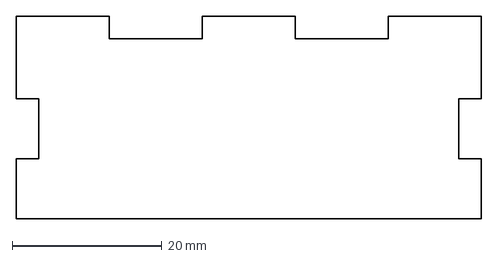
[picture p191: CAD file, 2018-03-02]
Sources/CAD/Solidworks Files/Holder for solar panel/dxf/Part_F1.DXF
62.0 x 27.0 mm
