SaadOjo/OJO/Sources/CAD/Solidworks Files/Monitor_3/dxfs/3mm/buttonHolder/bb1.DXF

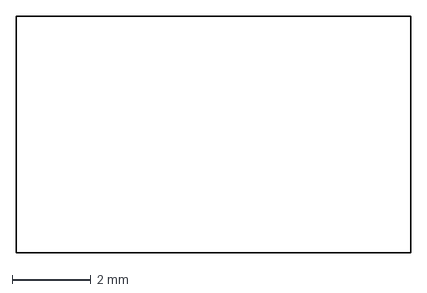
[picture p193: CAD file, 2018-05-15]
Sources/CAD/Solidworks Files/Monitor_3/dxfs/3mm/buttonHolder/bb1.DXF
10.0 x 6.00 mm
