SaadOjo/OJO/Sources/CAD/Solidworks Files/Monitor_3/dxfs/3mm/monitorFiles/G_1_topbezel.DXF

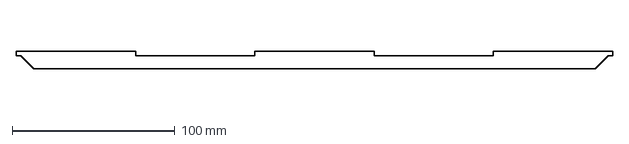
[picture p194: CAD file, 2018-05-15]
Sources/CAD/Solidworks Files/Monitor_3/dxfs/3mm/monitorFiles/G_1_topbezel.DXF
366.4 x 10.7 mm
