SaadOjo/OJO/Sources/CAD/Solidworks Files/new back holder/new_back_holder_back_part_A.SLDPRT

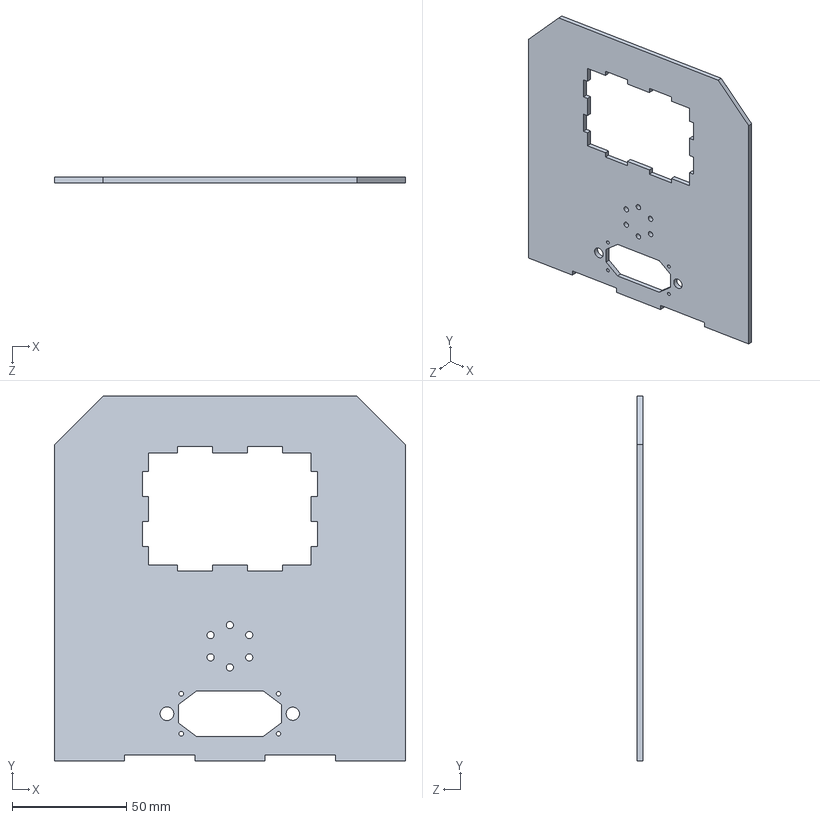
[picture p195: CAD file, 2018-05-15]
Sources/CAD/Solidworks Files/new back holder/new_back_holder_back_part_A.SLDPRT
153.4 x 159.5 x 2.70 mm
