SaadOjo/OJO/Sources/CAD/Solidworks Files/Walls (Box)/front.SLDPRT

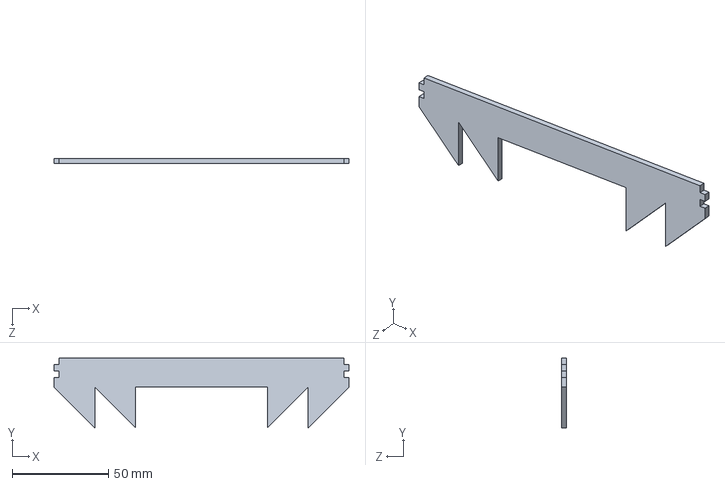
[picture p196: CAD file, 2018-05-15]
Sources/CAD/Solidworks Files/Walls (Box)/front.SLDPRT
153.4 x 36.2 x 2.70 mm
