SaadOjo/OJO/(list of files, cad)

Other CAD files:
Sources/CAD/Solidworks Files/Chassis/mainboard_last.SLDPRT
Sources/CAD/Solidworks Files/00 Non Project Related/Monitor_3/Assem2.SLDASM
Sources/CAD/Solidworks Files/Chassis/mainboard_03.SLDPRT
Sources/CAD/Solidworks Files/Chassis/mainboard_03_new.SLDPRT
Sources/CAD/Solidworks Files/Chassis/main board.SLDPRT
Sources/CAD/Solidworks Files/Chassis/mainboard_02.SLDPRT
Sources/CAD/Solidworks Files/00 Non Project Related/Monitor_2/ButtonCase/ba1.SLDASM
Sources/CAD/Solidworks Files/Chassis/mainboard_01.SLDPRT
Sources/CAD/Drawings of purchased items/drawings of microcontrollers and camera/ArduinoUno.dxf
Sources/CAD/Solidworks Files/00 Non Project Related/Monitor_3/5mm/A_1_other.SLDPRT
Sources/CAD/Solidworks Files/00 Non Project Related/Monitor_3/5mm/A_1.SLDPRT
Sources/CAD/Drawings of purchased items/drawings of microcontrollers and camera/dimensioniMega.dxf
Sources/CAD/Solidworks Files/00 Non Project Related/Monitor_2/5mm/B_3_base.SLDPRT
Sources/CAD/Solidworks Files/Walls (Box)/Side_1.SLDPRT
Sources/CAD/Solidworks Files/00 Non Project Related/coinSeperator/side_wall_2.SLDPRT
Sources/CAD/Solidworks Files/00 Non Project Related/Monitor/Electronics Box/BOX_B_1.SLDPRT
Sources/CAD/Solidworks Files/00 Non Project Related/Monitor_2/3mm/I_1_sidebezel.SLDPRT
Sources/CAD/Solidworks Files/00 Non Project Related/Monitor_2/5mm/B_2_base.SLDPRT
Sources/CAD/Solidworks Files/00 Non Project Related/Monitor_3/5mm/B_3_base.SLDPRT
Sources/CAD/Solidworks Files/00 Non Project Related/Monitor_3/ButtonCase/middle.SLDPRT
Sources/CAD/Solidworks Files/00 Non Project Related/shelf/G_1_prime.SLDPRT
Sources/CAD/Solidworks Files/seven segment box/partsev_bottom.SLDPRT
Other/Sketchup 3D/deneme00.skp
Other/Sketchup 3D/deneme01.skp
Other/Sketchup 3D/deneme02.skp
Other/Sketchup 3D/deneme03.skp
Other/Sketchup 3D/deneme04.skp
Sources/CAD/Solidworks Files/00 Non Project Related/Monitor/A_1X.SLDPRT
Sources/CAD/Solidworks Files/00 Non Project Related/Monitor/BASE.SLDPRT
Sources/CAD/Solidworks Files/00 Non Project Related/Monitor/C_1.SLDPRT
Sources/CAD/Solidworks Files/00 Non Project Related/Monitor/D_1.SLDPRT
Sources/CAD/Solidworks Files/00 Non Project Related/Monitor/E_1.SLDPRT
Sources/CAD/Solidworks Files/00 Non Project Related/Monitor/Electronics Box/BOX_A_1.SLDPRT
Sources/CAD/Solidworks Files/00 Non Project Related/Monitor/Electronics Box/BOX_E_1.SLDPRT
Sources/CAD/Solidworks Files/00 Non Project Related/Monitor/G_1.SLDPRT
Sources/CAD/Solidworks Files/00 Non Project Related/Monitor/H_1.SLDPRT
Sources/CAD/Solidworks Files/00 Non Project Related/Monitor/I_1.SLDPRT
Sources/CAD/Solidworks Files/00 Non Project Related/Monitor/dxf/3mm/D_1.DXF
Sources/CAD/Solidworks Files/00 Non Project Related/Monitor/dxf/3mm/E_1.DXF
Sources/CAD/Solidworks Files/00 Non Project Related/Monitor/dxf/3mm/G_1.DXF
Sources/CAD/Solidworks Files/00 Non Project Related/Monitor/dxf/3mm/I_1.DXF
Sources/CAD/Solidworks Files/00 Non Project Related/Monitor_2/3mm/C_1_topdeepbezel.SLDPRT
Sources/CAD/Solidworks Files/00 Non Project Related/Monitor_2/3mm/D_1_bottomdeepbezel.SLDPRT
Sources/CAD/Solidworks Files/00 Non Project Related/Monitor_2/3mm/F_1_sidedeepbezel.SLDPRT
Sources/CAD/Solidworks Files/00 Non Project Related/Monitor_2/ButtonCase/bb1.SLDPRT
Sources/CAD/Solidworks Files/00 Non Project Related/Monitor_2/ButtonCase/bt1.SLDPRT
Sources/CAD/Solidworks Files/00 Non Project Related/Monitor_2/ButtonCase/other_side_2.SLDPRT
Sources/CAD/Solidworks Files/00 Non Project Related/Monitor_2/ButtonCase/top_plate.SLDPRT
Sources/CAD/Solidworks Files/00 Non Project Related/Monitor_2/ElectronicsBox/box_base_plate.SLDPRT
Sources/CAD/Solidworks Files/00 Non Project Related/Monitor_3/3mm/C_1_topdeepbezel.SLDPRT
Sources/CAD/Solidworks Files/00 Non Project Related/Monitor_3/3mm/D_1_bottomdeepbezel.SLDPRT
Sources/CAD/Solidworks Files/00 Non Project Related/Monitor_3/3mm/F_1_sidedeepbezel.SLDPRT
Sources/CAD/Solidworks Files/00 Non Project Related/Monitor_3/3mm/I_1_sidebezel.SLDPRT
Sources/CAD/Solidworks Files/00 Non Project Related/Monitor_3/5mm/B_2_base.SLDPRT
Sources/CAD/Solidworks Files/00 Non Project Related/Monitor_3/ButtonCase/button1_base.SLDPRT
Sources/CAD/Solidworks Files/00 Non Project Related/shelf/A_1.SLDPRT
Sources/CAD/Solidworks Files/00 Non Project Related/shelf/B_1.SLDPRT
Sources/CAD/Solidworks Files/00 Non Project Related/shelf/C_1.SLDPRT
Sources/CAD/Solidworks Files/00 Non Project Related/shelf/D_1.SLDPRT
Sources/CAD/Solidworks Files/00 Non Project Related/shelf/E_1.SLDPRT
Sources/CAD/Solidworks Files/00 Non Project Related/shelf/F_1.SLDPRT
Sources/CAD/Solidworks Files/00 Non Project Related/shelf/G_1.SLDPRT
Sources/CAD/Solidworks Files/00 Non Project Related/shelf/H_1.SLDPRT
Sources/CAD/Solidworks Files/01 unused (old)/Arduino Uno Holder/dxf/Part_A_1.DXF
Sources/CAD/Solidworks Files/01 unused (old)/Arduino Uno Holder/dxf/Part_B_1.DXF
Sources/CAD/Solidworks Files/01 unused (old)/Holder for Laser and US Sensor/Assem1_for_holder_for_laser_and_us_sensor.SLDASM
Sources/CAD/Solidworks Files/01 unused (old)/Holder for Laser and US Sensor/Part_A.SLDPRT
Sources/CAD/Solidworks Files/01 unused (old)/Holder for direction and distance sensors/Separate parts/Assem.SLDASM
Sources/CAD/Solidworks Files/01 unused (old)/Holder for direction and distance sensors/Separate parts/backup/holder_A_1.SLDPRT
Sources/CAD/Solidworks Files/01 unused (old)/Holder for direction and distance sensors/Separate parts/backup/holder_C_1.SLDPRT
Sources/CAD/Solidworks Files/01 unused (old)/Holder for direction and distance sensors/Separate parts/backup/holder_D_1.SLDPRT
Sources/CAD/Solidworks Files/01 unused (old)/Holder for direction and distance sensors/Separate parts/dxf/holder_B_2.DXF
Sources/CAD/Solidworks Files/01 unused (old)/Holder for direction and distance sensors/Separate parts/dxf/holder_C_1.DXF
Sources/CAD/Solidworks Files/01 unused (old)/Holder for direction and distance sensors/Separate parts/dxf/holder_D_1.DXF
Sources/CAD/Solidworks Files/01 unused (old)/Holder for direction and distance sensors/Separate parts/holder_D_1.SLDPRT
Sources/CAD/Solidworks Files/01 unused (old)/Parts that are used for front holder/New holder for direction and distance sensors and camera/Assem2.SLDASM
Sources/CAD/Solidworks Files/01 unused (old)/Parts that are used for front holder/New holder for direction and distance sensors and camera/First_Part.SLDPRT
Sources/CAD/Solidworks Files/01 unused (old)/Parts that are used for front holder/New holder for direction and distance sensors and camera/Second_Part.SLDPRT
Sources/CAD/Solidworks Files/01 unused (old)/Parts that are used for front holder/Raspberry and Arduino Holder/Base_rasp_and_ard.SLDPRT
Sources/CAD/Solidworks Files/01 unused (old)/Parts that are used for front holder/Raspberry and Arduino Holder/rasp_ard_assem.SLDASM
Sources/CAD/Solidworks Files/01 unused (old)/Raspberry Camera Holder (dimensions needs to be measured)/part1.SLDPRT
Sources/CAD/Solidworks Files/01 unused (old)/Roboy (unused)/Assem1_2.SLDASM
Sources/CAD/Solidworks Files/01 unused (old)/back holder/Assem1.SLDASM
Sources/CAD/Solidworks Files/01 unused (old)/back holder/First_Part_01.SLDPRT
Sources/CAD/Solidworks Files/01 unused (old)/back holder/Second_Part_02.SLDPRT
Sources/CAD/Solidworks Files/01 unused (old)/chassis (previous ones)/main board.SLDPRT
Sources/CAD/Solidworks Files/01 unused (old)/chassis (previous ones)/mainboard_01.SLDPRT
Sources/CAD/Solidworks Files/01 unused (old)/chassis (previous ones)/mainboard_02.SLDPRT
Sources/CAD/Solidworks Files/01 unused (old)/chassis (previous ones)/mainboard_03.SLDPRT
Sources/CAD/Solidworks Files/01 unused (old)/chassis (previous ones)/mainboard_03_new.SLDPRT
Sources/CAD/Solidworks Files/10 to be cut/2.7 mm/Dxf/Arduino_nano_holder.DXF
Sources/CAD/Solidworks Files/10 to be cut/2.7 mm/Dxf/Base_main.DXF
Sources/CAD/Solidworks Files/10 to be cut/2.7 mm/Dxf/Front_holder_A.DXF
Sources/CAD/Solidworks Files/10 to be cut/2.7 mm/Dxf/OJO_logo.DXF
Sources/CAD/Solidworks Files/10 to be cut/2.7 mm/Dxf/Part_C1 - Kopya.DXF
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
