SaadOjo/OJO/(list of files, drawings)

Other design files:
Sources/Microcontroller CodesSensorCombination/ultrasound sensor/Ultrasonic/extras/Ultrasonic.fzz
