SaadOjo/OJO/Sources/Microcontroller 2 Codes/secondArduino/collisionDetector.h

/*
 A custom library written for collison detecting
 Library wrıtten by Syed Saad Saif
 */
#ifndef COLLISION_DETECTOR_H
#define COLLISION_DETECTOR_H

#include <Arduino.h>
#include "Ultrasonic.h"
#include "infraredDistance.h"
#include "average.h"
#define DANGER_DISTANCE 10
#define LAST_DETERMINE_DISTANCE 30

class collisionDetector
{
  public:
    collisionDetector(unsigned char frontPin, unsigned char leftEchoPin, 
    unsigned char leftTriggerPin, unsigned char rightEchoPin, unsigned char rightTriggerPin,
    unsigned char backEchoPin, unsigned char backTriggerPin);
    bool robotIsLast();
    bool update();
    bool init();
    unsigned char getAvoidAction();
  private:
    int _leftDist, _rightDist, _frontDist, _backDist;
    unsigned char _frontPin, _leftEchoPin, _leftTriggerPin;
    unsigned char _rightEchoPin, _rightTriggerPin, _backEchoPin, _backTriggerPin;
    Ultrasonic _left, _right, _back;
    infraredDistance _front;
    average _leftAverage,_backAverage,_rightAverage,_frontAverage;
};


#endif
