SaadOjo/OJO/Sources/Codes_For_Demo_Backup/Microcontroller Codes/flags_transmitter/flags_transmitter_lib_playground/flags_transmitter_lib_playground.ino

#include "flagsTransmitter.h"

flagsTransmitter myFlagsTransmitter(4, 7);


void setup()
{
  Serial.begin(115200);
  myFlagsTransmitter.init();

  myFlagsTransmitter.setLeaveSignal(HIGH);
  myFlagsTransmitter.setLastSignal(HIGH);
  //myFlagsTransmitter.clearFlags();

}

void loop()
{

  myFlagsTransmitter.transmit();

}
