SaadOjo/OJO/Sources/Microcontroller CodesSensorCombination/robotMotion/motion_lib_playground/robotMotion.h

/*
 A custom library written for IR distance sensor
 Library wrıtten by Syed Saad Saif
 */
#ifndef ROBOT_MOTION_H
#define ROBOT_MOTION_H

#include <Arduino.h>
#include "signalConditioner.h"

class robotMotion
{
  public:
    robotMotion(int motor_left, int motor_right);
    bool run();
    bool setSpeed(unsigned short int speed);
    bool setDirection(short int direction);
    bool runRight(unsigned short int speed); 
    bool runLeft(unsigned short int speed); 
    bool init();
  private:
    int _motor_left;
    int _motor_right; 

    int _leftCalibrationFactor = 100; //Percentage
    int _rightCalibrationFactor = 85; //Percentage
    int _speed;
    int _direction;
};

#endif
