SaadOjo/OJO/Sources/Microcontroller CodesSensorCombination/IR_Protocol_Simple/infraredTransmitter/infrared_transmitter_lib_playground/infrared_transmitter_lib_playground.ino

#include "infraredTransmitter.h"

infraredTransmitter myTransmitter(9);

void setup()
{
  Serial.begin(115200);
  myTransmitter.init();
  myTransmitter.setSignalIdentity(1);
}

void loop()
{
  myTransmitter.transmit();
  delay(20);
  
}
