SaadOjo/OJO/Sources/Microcontroller CodesSensorCombination/feedback control/controller_lib_playground/infraredDistance.cpp

/*
 A custom library written for wireless lvdt LCD display
 Library wrıtten by Syed Saad Saif
 */
#include "infraredDistance.h"

infraredDistance::infraredDistance(int pin)
{
  _pin = pin;
 
}

bool infraredDistance::init(){
//Analog declaration
}

float infraredDistance::getDistance()
{
  _count = analogRead(_pin);
  _voltage = (float)_count*_referenceVoltage/1024;
  _distance = 36.8*(1/_voltage);
  return _distance;
}
