SaadOjo/OJO/(commit log)

2017-11-10 gannt chart template
    [Excel-Gantt-Chart-Template-TeamGantt.xlsx]
2017-11-10 Gantt document
    [gantt.xlsx]
2017-11-10 gantt 2
    [gantt updated.xlsx]
2017-11-10 gannt updated again
    [gantt updated.xlsx]
2017-11-10 Comparison Table
    [Comparison Table.xlsx]
2017-11-10 comparison table update
    [Comparison Table.xlsx]
2017-11-10 Comp table word
    [Comparison Table.xlsx]
2017-11-25 ultrasonic sensor library
    [Ultrasonic.fzz]
2017-11-28 added IR led library
2017-11-28 accelerometer
    added
2017-12-08 direct action controller, added low pass filter to sensor
2017-12-08 feedback lib updated to use sensor
2017-12-12 trial for 3D printer
    seems a little desperate
    [deneme00.skp, deneme01.skp, deneme02.skp, deneme03.skp, deneme04.skp]
2017-12-17 Added direction Sensor
2017-12-27 calibrated distance sensor
2018-01-22 calibration done
2018-01-24 changed robot motion to work with the new driver IC
2018-01-24 Added pin mapping and also initialised a IR sensor library
2018-01-24 added remote detector (Not working fully)
    [remoteDecoder.cpp, remoteDecoder.h, remote_lib_playground.ino]
2018-02-19 deleted presentaion selection form. Re organised the repository
    [Ultrasonic.fzz, solidworks_1.SLDPRT]
2018-02-19 cad sketch together
    [main board.SLDPRT]
2018-02-19 solidworks together
    [main board.SLDPRT, mainboard_01.SLDPRT, mainboard_02.SLDPRT]
2018-02-22 new drawing
    [mainboard_ucs_09.SLDPRT]
2018-02-24 CAD again
    [mainboard_03.SLDPRT, mainboard_03_new.SLDPRT, mainboard_ucs_09.SLDPRT]
2018-02-25 modified for camera,need improvement
2018-02-26 CAD 6546
    [mainboard_04_new.SLDPRT]
2018-02-28 sensor library updated
2018-03-01 template for latest gannt chart
    [latestgannt.xlsx]
2018-03-01 gantt march updated
    [gantt updated.xlsx, latestgannt.xlsx, latestgantt_march01.xlsx]
2018-03-01 Week 3 report
    [latestgantt_march01.xlsx]
2018-03-02 sensor holder drawing started
    [cancelled_holder_01.SLDPRT, deneme00.skp, deneme01.skp, deneme02.skp, deneme03.skp, deneme04.skp, new_holder_01.SLDPRT]
2018-03-02 Lots of CAD
    [holder_A_1.SLDPRT, holder_B_1.SLDPRT, holder_B_2.SLDPRT, holder_C_1.SLDPRT, holder_D_1.SLDPRT, new_holder_02.SLDPRT, new_holder_03.SLDPRT, new_holder_04.SLDPRT]
2018-03-02 CAD error
    [holder_A_1.SLDPRT, holder_B_1.SLDPRT, holder_B_2.SLDPRT]
2018-03-02 sensor holder assembly CAD
    [Assem.SLDASM]
2018-03-02 solar panel holder
    [Assem.SLDASM, Part_C1.SLDPRT, holder_A_1.SLDPRT, holder_B_2.SLDPRT, holder_C_1.SLDPRT, holder_D_1.SLDPRT, new_holder_05.SLDPRT, new_holder_06.SLDPRT]
2018-03-02 solar panel cad
    [Part_D1.SLDPRT, Part_E1.SLDPRT]
2018-03-02 Parts for solar panel done
    [Part_E1.SLDPRT]
2018-03-02 sp cad
    [Part_F1.SLDPRT]
2018-03-02 Solar panel assembly
    [Assem for solar panel holder.SLDASM]
2018-03-02 sensor holder dxf trial
    [Assem for solar panel holder.SLDASM, holder_B_2.DXF]
2018-03-02 dxf for both sensors and panels
    [Part_C1.DXF, Part_D1.DXF, Part_E1.DXF, Part_F1.DXF, holder_A_1.DXF, holder_C_1.DXF, holder_D_1.DXF, part_A1.DXF]
2018-03-03 holes for ir holders aligned, dxf file added
    [holder_A_2.DXF]
2018-03-03 removed the wrong file
    [holder_A_1.DXF]
2018-03-03 unrequred files removed
    [Assem for solar panel holder.SLDASM, Assem.SLDASM, holder_A_1.SLDPRT]
2018-03-03 Robot CAD
    [Assem part.SLDPRT, Assem1.SLDASM, mainboard_last.SLDPRT]
2018-03-03 Arduino Holder
    [Assem Arduino.SLDASM, Assem1.SLDASM, Part_A_1.DXF, Part_A_1.SLDPRT, Part_B_1.DXF, Part_B_1.SLDPRT]
2018-03-04 monitor files
    [A_1.SLDPRT, Assem.SLDASM, BASE.SLDPRT, B_1.SLDPRT, C_1.SLDPRT, D_1.SLDPRT, E_1.SLDPRT, F_1.SLDPRT]
2018-03-04 stuff added
    [A_1.SLDPRT, Assem.SLDASM, BOX_A_1.SLDPRT, BOX_B_1.SLDPRT, BOX_C_1.SLDPRT, BOX_D_1.SLDPRT, BOX_E_1.SLDPRT, BOX_F_1.SLDPRT]
2018-03-04 monitor done
    [A_1.SLDPRT, Assem.SLDASM, BOX_A_1.SLDPRT, BOX_B_1.SLDPRT, BOX_C_1.SLDPRT, BOX_D_1.SLDPRT, BOX_E_1.SLDPRT, BOX_F_1.SLDPRT]
2018-03-05 Weekly Report for 4th week
    [Assem part.SLDPRT, Assem.SLDASM, holder_A_1.SLDPRT, holder_A_2.DXF, holder_B_2.DXF, holder_B_2.SLDPRT, holder_C_1.DXF, holder_C_1.SLDPRT]
2018-03-06 Some new CAD
    [Back.SLDPRT, Side.SLDPRT]
2018-03-06 Side planes and assem
    [Assem.SLDASM, Assem1.SLDASM, Back.SLDPRT, Side.SLDPRT, Side_2.SLDPRT, mainboard_last.SLDPRT]
2018-03-06 back CAD
    [Assem1.SLDASM, Back.SLDPRT, Side_2.SLDPRT, mainboard_last.SLDPRT]
2018-03-06 CAD back side done
    [Assem1.SLDASM, Back.SLDPRT, mainboard_last.SLDPRT]
2018-03-07 OJO logo
    [Assem1.SLDASM, Back.SLDPRT]
2018-03-07 CAD top_1
    [Assem1.SLDASM, Top_first.SLDPRT]
2018-03-07 logo up
    [Back.SLDPRT]
2018-03-08 Top_2 CAD
    [Assem1.SLDASM, Side.SLDPRT, Top_second.SLDPRT, latestgantt_march01.xlsx]
2018-03-08 logo CAD
    [Assem1.SLDASM, Back.SLDPRT, Top_second.SLDPRT]
2018-03-08 CAD updated wheel
    [Assem.SLDASM, Assem1.SLDASM, Assem1_2.SLDASM, Part1.SLDPRT, Part2.SLDPRT, holder_B_2.SLDPRT, this little thing.SLDASM]
2018-03-10 saad sync
    [A_1.SLDPRT, A_1X.SLDPRT, Assem.SLDASM, B_2_base.SLDPRT, C_1_topdeepbezel.SLDPRT, D_1_bottomdeepbezel.SLDPRT, E_1_sidedeepbezel.SLDPRT]
2018-03-10 monitor alternate design
    [A_1.DXF, Assem2.SLDASM, B_2_base.SLDPRT, B_3_base.SLDPRT]
2018-03-12 shelf added
    [A_1.SLDPRT, Assem.SLDASM, Assem1.SLDASM, Assem2.SLDASM, Assem3.SLDASM, B_1.SLDPRT, B_3_base.SLDPRT, B_4_base.SLDPRT]
2018-03-12 Alternative Shelf
    [Assem1_prime.SLDASM, B_1_prime.SLDPRT, D_1_prime.SLDPRT, G_1_prime.SLDPRT]
2018-03-13 removed a stupid bug
    [controller.cpp, controller.h, controller_lib_playground.ino, infraredReciever.cpp, infraredReciever.h, infraredTest.ino, infraredTransmitter.cpp, infraredTransmitter.h]
2018-03-16 I'M BATMAN
    [A_1.SLDPRT, Assem2.SLDASM]
2018-03-16 Monitor alternative
    [A_1_other.SLDPRT, Assem2_other.SLDASM, OJO LOGO.SLDPRT, stick.SLDPRT]
2018-03-19 rough flow chart
2018-03-20 removed self fulfilling bug
    [controller.cpp, controller.h, controller_lib_playground.ino]
2018-03-21 NEW direction and distance sensor holder
    [Assem for new holder for direction and distance sensors.SLDASM, Assem.SLDASM, Assem1_2.SLDASM, Assem1_2_new.SLDASM, First_Part.SLDPRT, Second_Part.SLDPRT, Side_2.SLDPRT, mainboard_last.SLDPRT]
2018-03-22 final standards
    [Assem for new holder for direction and distance sensors.SLDASM, Assem1_2_new.SLDASM, mainboard_last.SLDPRT]
2018-03-23 Holder for US Sensor and LASER
    [Assem1_for_holder_for_laser_and_us_sensor.SLDASM, Part_A.SLDPRT, Part_B.SLDPRT, Part_C.SLDPRT]
2018-03-23 lots of CAD work
    [Assem1_2_new.SLDASM, Assem1_for_holder_for_laser_and_us_sensor.SLDASM, Part_A.SLDPRT, Part_C.SLDPRT, Side_1.SLDPRT, Side_2.SLDPRT, mainboard_last.SLDPRT]
2018-03-30 walls updated (CAD)
    [Assem1_2_new.SLDASM, Side_1.SLDPRT, Side_2.SLDPRT]
2018-03-30 remoteDecoder added to sensor library
2018-03-31 CAD update
    [Assem1_2_new.SLDASM, Assem2.SLDASM, Side_2.SLDPRT, Top_first.SLDPRT, mainboard_last.SLDPRT]
2018-03-31 CAD update and new video link
    [Back.SLDPRT]
2018-04-06 CAD CAD CAD
    [Assem1.SLDASM, Assem1_2_new.SLDASM, Assem2.SLDASM, First_Part_01.SLDPRT, Second_Part_02.SLDPRT]
2018-04-06 Collison avoidance
    collison avoidance except ir distance sensor
    [collisionDetector.cpp, collisionDetector.h, signalConditioner.cpp, signalConditioner.h]
2018-04-07 raspberry pi camera holder (dimensions to be measured)
    [ArduinoUno.dxf, Assem1.SLDASM, Assem1_2_new.SLDASM, First_Part_01.SLDPRT, dimensioniMega.dxf, part1.SLDPRT, rpi_MECH_3b_1p2.dxf]
2018-04-11 collision detection library(with us sensors for now)
    [ultrasonic_lib_playground.ino]
2018-04-11 CAD (lots of new comp)
    [Assem1.SLDASM, Assem1_2_new.SLDASM, Assem2.SLDASM, First_Part.SLDPRT, First_Part_01.SLDPRT, Second_Part.SLDPRT, Second_Part_02.SLDPRT, Side_1.SLDPRT]
2018-04-12 lots of new CAD
    [A_1.DXF, A_1.SLDPRT, A_1X.SLDPRT, A_1_other.SLDPRT, Arduino_nano_holder.SLDPRT, Assem Arduino.SLDASM, Assem part.SLDPRT, Assem.SLDASM]
2018-04-13 CAD is finally done!
    [A_1.SLDPRT, Arduino_nano_holder.DXF, Arduino_nano_holder.SLDPRT, Assem1.SLDASM, Assem1_2.SLDASM, Assem1_2_new.SLDASM, Assem1_prime.SLDASM, Assem_bat_holder.SLDASM]
2018-04-15 I2C for arduino communication
2018-04-15 collision detector format changed
    [collisionDetector.cpp, collisionDetector.h]
2018-04-15 second arduino code done
2018-04-15 inter arduino tested
2018-04-16 pi encoder implemented in main code
2018-04-18 pin amount
2018-04-18 transmit and recieve i2c
2018-04-19 Power rail mapping
2018-04-20 flagsTransmitter library added
    sevensegment and laser
2018-04-20 removed ir distance from main arduino
2018-04-22 added front sensor made made connection accordingly
2018-04-24 backup made for code for demo
    [Ultrasonic.fzz]
2018-05-02 noise reduction (by saad)
    [average.cpp, average.h]
2018-05-02 sth tried does not work
    [infraredDirection.cpp]
2018-05-04 stuff happening
    [Ultrasonic.fzz]
2018-05-04 maintaining velocity repetiveness added
2018-05-14 sensor timings changed
    compensation for low pass filter
